snowyfoams/dog6/doc/walk/README.md

# Walking from the fold stand: one reference, the joint layer kept, the QP

*MuJoCo study, 2026-10-04, branch `cloud`.  The repo's own `StandSequence` /
`BalanceLaw` / `TrotGait` / `SafetyGate` run through
`doc/crouch_trot/hwsim.py` (CAN round robin, encoder quantisation, the 40 Hz
qd filter, IMU latency, the gate's 120 N·m/s slew and 9 N·m clip), with
`hw.trot_esti`'s Kalman filter fed **one sweep late** as `hw.stand` does.
The operator "holds keys": the command comes from a schedule.  Everything
here is simulation on the CAD model with DOG5's rotor inertia; **nothing has
flown**.  Section 10 says how to reproduce every table.*

**TL;DR.**  `hw.fold_walk` walks `hw.fold_trot` from the keyboard (W/S x, A/D
y, Q/E yaw) with the joint layer **kept**: its stance targets are anchored in
the world at each touchdown and seen from the *reference* trunk, so along
the reference they ask for exactly zero torque and they pull only on the
error the x/y rows pull on (section 2: the proof, and `selftest` §14).  The
force allocation is a QP with the friction pyramid inside the problem
(section 5), checked against SLSQP and certified by KKT.  **MuJoCo says it is
feasible inside a modest envelope**: across six gait phases a case the
shipped walk stays under 10° of tilt — in place, forward and back
0.05–0.10 m/s, sideways ±0.05 and 0.08 m/s, turns of ±20 and 40 °/s, 0.10 m/s
with a 20 °/s turn — and **0.15 m/s forward is not** (3 of 6 tipped, 2 to the
tilt stop).  Getting there took three findings worth more than any gain:
(1) the swing leg is **torque-rate bound** — in z the foot is 5.8 kg through
the reflected rotor, so the 20 mm arc's own feedforward asks the knee for
~1 000 N·m/s at the trot's 120 ms of swing and ~300 at 180 ms, against the
gate's 120: hence duty 0.70 and a swing law stiff in x/y, soft in z;
(2) DOG5's **settle** (a 0.2 s freeze of the gait clock every 2 cycles) must
be **off** while walking; (3) the **armature is the swing law's gain** — with
DOG6's lighter rotor (the bench's 1/1.7) and DOG5's M0 the walk fell 1 time
in 3 at 0.10 m/s, and with M0 fitted it never did.  The estimator under-reads
distance by ~10 %, so the robot walks ~10 % faster than asked.  The keys'
box ships at 0.10 / 0.05 m/s and 20 °/s.

**Follow-up, the same day, on request.**  The QP is now every entry point's
default allocator — stand, rise, hold, trot, walk (section 5.1): in place
it is the least squares to 0.05° of tilt, pushed it delivers more of the
wrench, and its worst case is capped at ~1.5 ms.  And `hw.fold2_walk` walks
the knees-out FOLD2 with the same walk (section 7).  Its CoM is on both trot
diagonals, and it is the better walker: six phases a case, in place to
0.15 m/s forward, 0.10 sideways, 40 °/s and 0.10 m/s with a 20 °/s turn all
under 8° of tilt, none tipped — 0.20 m/s forward is its edge (4 of 6 to
the stop) — and none of the hardware unknowns tipped it, the unfitted
lighter rotor included.

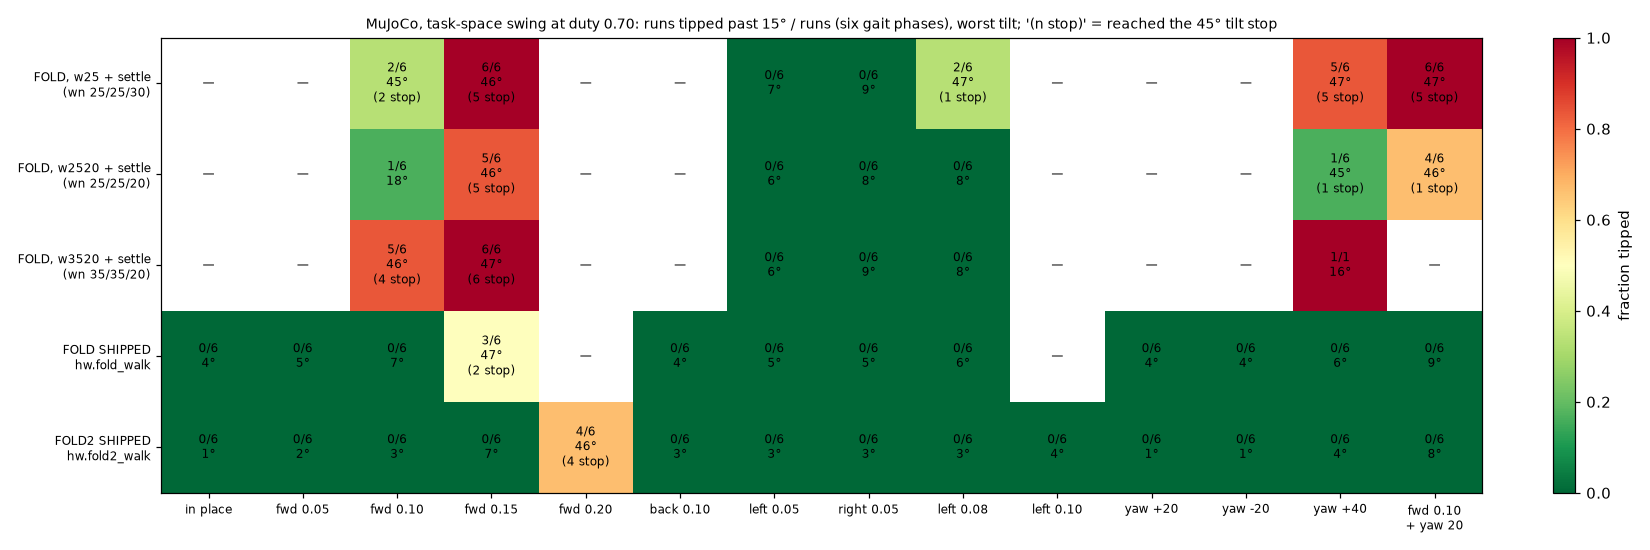
[picture p5: doc/walk/fig/fig_envelope.png]
envelope


**After the robot, 2026-10-05 (section 11).**  The trot that fails "after a
while" and the walk's trot in place that is worse than the trot's are, in
MuJoCo, one hardware unknown: the CoM a few mm off the CAD's.  3 / 5 mm
takes `hw.fold_trot` in place from 2.2° to 10° with the tilt rms growing
every 10 s and fells every walk within seconds; the rotor, friction,
latency, floor and torque constant cost under a degree each.  Shifting the
law's pin alone does not cure it; re-centring the stance on the measured
CoM does (`hw.com_check`, `hw.stand --com-offset`).  Until it is measured,
the walk's impedance on the trot's clock (`--swing-law impedance --duty
0.8 --contact-ramp 0.15 --settle 0.2`) is the configuration that stood
every 30 s run.  The harness also measured with the wrong SRB pin for the
fold until then; section 11.5 has the standard set re-run.

## 1. What was built

```
keys ──► WalkKeys.command (body axes) ──► WalkReference ──► RefSample (p, v, a, ψ, r) ──┬─► x/y rows (p_ref, v_ref, a_ref)
 W/S x  A/D y  Q/E yaw  SPACE stop       slew · clip · integrate · leash                ├─► heading (R_des = Rz(ψ_ref)…, ω_des = r ẑ)
                                                                                         ├─► joint layer (world-anchored targets)
                                                                                         └─► footholds + swing arc ─► swing law
                         SRB wrench ──► QP allocation (pyramid + box inside) ──► −Jᵀ Rᵀ f + gravity
```

| file | what it is |
|---|---|
| `hw/balance/trajectory.py` | the reference: `sim.cmpc.trajectory`'s generator **imported** (body command rotated by the *reference* yaw, integrated), the command slewed at `WALK_ACC_MAX`, clipped to the hardware box, **leashed** to the filter's CoM (MIT's `max_pos_error`) and the yaw to the IMU's heading on the circle |
| `hw/balance/keys.py` | `sim.cmpc.run`'s mapping key for key: W/S ±x, A/D ±y, Q/E ±yaw, SPACE stop; accumulates, clips |
| `hw/balance/qp.py` | stage 4 as a QP: `min ½|Af − b|²_S + ½α fᵀWf` s.t. the pyramid and the contact-weighted fz box; dense primal active set |
| `hw/balance/footstep.py` | the swing leg's **trajectory**: eq (33) + Raibert's term for the foothold, the x/y arc a quintic in the **world** (ground speed at both ends), z the in-place bump in the trunk |
| `hw/balance/swing_control.py` | the swing leg's **control**: task-space computed torque (`osc`, the default) or the Cartesian impedance |
| `hw/balance/walk.py` | ties them to one reference; the joint layer's world-anchored targets |
| `hw/fold_walk.py` | the entry point: `hw.fold_trot` + the hook + the QP + the walk's clock (`walking()`, which wraps any trot entry point) |
| `hw/fold2_walk.py` | the same walk over `hw.fold2_trot`, knees out (section 7) |
| `doc/walk/walksim.py` | this study |

`law.BalanceLaw` gains `alloc` and `walk`.  `walk` defaults to None, and
then nothing of the walk reaches any other entry point.  `alloc` defaults to
`"qp"` since the follow-up of the same day, on request: every entry point
now allocates with the QP (section 5.1), `--alloc wls` the least squares.
`selftest` passes the checks it passed before (the same two fail, section
10) and its section 14's new ones.

## 2. One reference — and why the joint layer survives walking

The worry (2026-10-04, before any of this was written): a joint target
latched at HOLD is a stance; the SRB law moving the trunk to correct x/y
deforms that stance; the two fight.  They do — *if their targets differ*.
The cure is not to drop the layer but to give it the same target as
everything else.

Each planted foot *i* has a **world anchor** `a_i` (x/y), latched at its
touchdown from the filter: `a_i = p̂ + R x_i^b`.  With the reference trunk
origin `p_o(t) = p_ref − Rz(ψ_ref) c_xy` (the CoM reference less the CoM
offset) the joint layer's target is the foot *as the reference trunk sees
it*:

```
x_t,i  = Rz(ψ_ref)ᵀ (a_i − p_o)          z: the commanded stance depth
ẋ_t,i  = −Rz(ψ_ref)ᵀ ṗ_o − r ẑ × x_t,i     (the anchor is fixed in the world)
q_t,i  = IK(x_t,i),   q̇_t,i = J_i⁻¹ ẋ_t,i
τ_i    = Kp (q_t,i − q_i) + Kd (q̇_t,i − q̇_i)       planted legs only
```

**Claim 1 — along the reference the layer is silent.**  If the trunk is
exactly on the reference — origin at `p_o`, heading `ψ_ref`, at their rates,
level and at the commanded height — and the foot has not slipped, the foot's
trunk-frame position *is* `x_t,i` and its rate *is* `ẋ_t,i`, so `q = q_t`,
`q̇ = q̇_t` and `τ = 0`.  (Roll, pitch and height errors still meet the
spring, as they always did: those are the attitude and height loops'
errors too.)  The layer therefore acts
only on the trunk's deviation from the reference — the same deviation the
x/y rows act on, measured the same way — so the two can no longer disagree
about where the trunk should be.  This is the conflict of the "joint hold
vs. SRB correction" question, removed by construction rather than by
softening either loop.  (`selftest` §14 builds a trunk 12 mm and 5° off the
engaging pose, moving at 0.1 m/s and 0.2 rad/s, sets its joints from an
independent finite difference of the reference's motion, and finds the
spring and the damper both zero to 1e-9 rad and 1e-10 rad/s.)

**Claim 2 — engaging is bumpless.**  At the first trot sweep every foot is
still on its HOLD site.  The anchors are set *virtually* to
`p_eq + Rz(ψ₀) s_i` with `s_i = FK(q_hold)` and `p_eq` the least-squares
origin that puts the four feet on their sites; the reference is reset on
the same `p_eq`.  So on that sweep `q_t ≡ q_hold` (to 9e-16 rad in
`selftest`) and the x/y error is zero — no step in the joint torque, none in
the wrench.

Two bounds keep an estimate gone wrong from pulling hard: the reference is
leashed within 30 mm of the filter's CoM, and per leg the x/y part of
`x_t − x` is clamped to 20 mm (`HOLD_XY_ERR_MAX`; at Kp 5 that is a few N).

The heading takes the same sample: `R_des = Rz(ψ_ref)·R(roll_sp, pitch_sp)`,
`ω_des = r ẑ`; the x/y rows get `p_ref`, `v_ref` and `a_ref` fed forward
(only while they are closed on a usable estimate).

## 3. Footholds and the swing arc

The foothold is cMPC's eq (33) with Raibert's feedback term, in the run's
world at the predicted touchdown (`t_rem` = swing time left):

```
p_land = p̂ + v_ref t_rem + Rz(ψ̂ + r t_rem + ½ r T_st) s_i + ½ T_st v̂ + k_v (v̂ − v_ref)
```

clamped to ±(60, 40) mm of the site in the heading frame.  `s_i` is the
**stance's own** neutral foot (the hold's), not the hip: the stance the SRB
model is pinned at.  `½ r T_st` is MIT's `pYawCorrected`.  `k_v` = 0.03 s
(MIT's); 0.06 and 0.10 were worse (section 6.2).

The arc is split on purpose: **x/y is a quintic between two world points**
(liftoff latched where the foot *is*, landing re-aimed every sweep), so the
foot leaves and meets the floor at ground speed — a trunk-frame arc would
slide every landing at the walking speed.  **z stays the in-place bump** on
the commanded depth, in the trunk, where the height loop and the joint
layer live.  World → trunk is by the heading, with the transport terms
(`v_b = Rzᵀ(v_w − v) − r ẑ × p_b`, `a_b = Rzᵀ(a_w − a) − 2r ẑ × v_b + r² p_b`);
`selftest` checks both against finite differences, walking and turning, and
the scalar arcs against `sim.cmpc.swing.SwingTrajectory` to 9e-15.

## 4. The swing law, and the number that decides it

```
osc:        τ = M0 J⁻¹ (a_ref + ωn² e + 2ζωn ė − J̇ q̇)        (cMPC's law, constant M0)
impedance:  τ = Jᵀ (Kp e + Kd ė)  [+ M0 J⁻¹ (a_ref − J̇ q̇_ref)  with --swing-ff]
```

The task-space law gives every axis its own bandwidth whatever the foot's
apparent mass, and that mass is the whole story.  At the fold stance,
`Λ = (J M0⁻¹ Jᵀ)⁻¹` has a diagonal of **0.31, 0.36, 5.8 kg** (x, y, z): the
reflected rotor, 0.0085 kg·m² a joint, seen through a short z lever.  The
20 mm z bump is two quintic halves of `T_h = T_sw/2`; its peak jerk is
`60 H / T_h³`, so its *feedforward alone* asks of the knee

| swing | z peak jerk | knee torque rate (feedforward only) | gate |
|---|---|---|---|
| 120 ms (duty 0.80) | 5 560 m/s³ | ~1 020 N·m/s | 120 |
| 180 ms (duty 0.70) | 1 650 m/s³ | **~300 N·m/s** | 120 |
| 245 ms | 650 m/s³ | ~120 N·m/s | 120 |

(`M0 J⁻¹ ẑ` is 0.18 N·m per m/s² at the knee.)  Past the gate's slew the
torque the motor gets is a triangle of the one asked for, the foot lags,
the feedback winds up behind the limiter, and the foot overshoots:

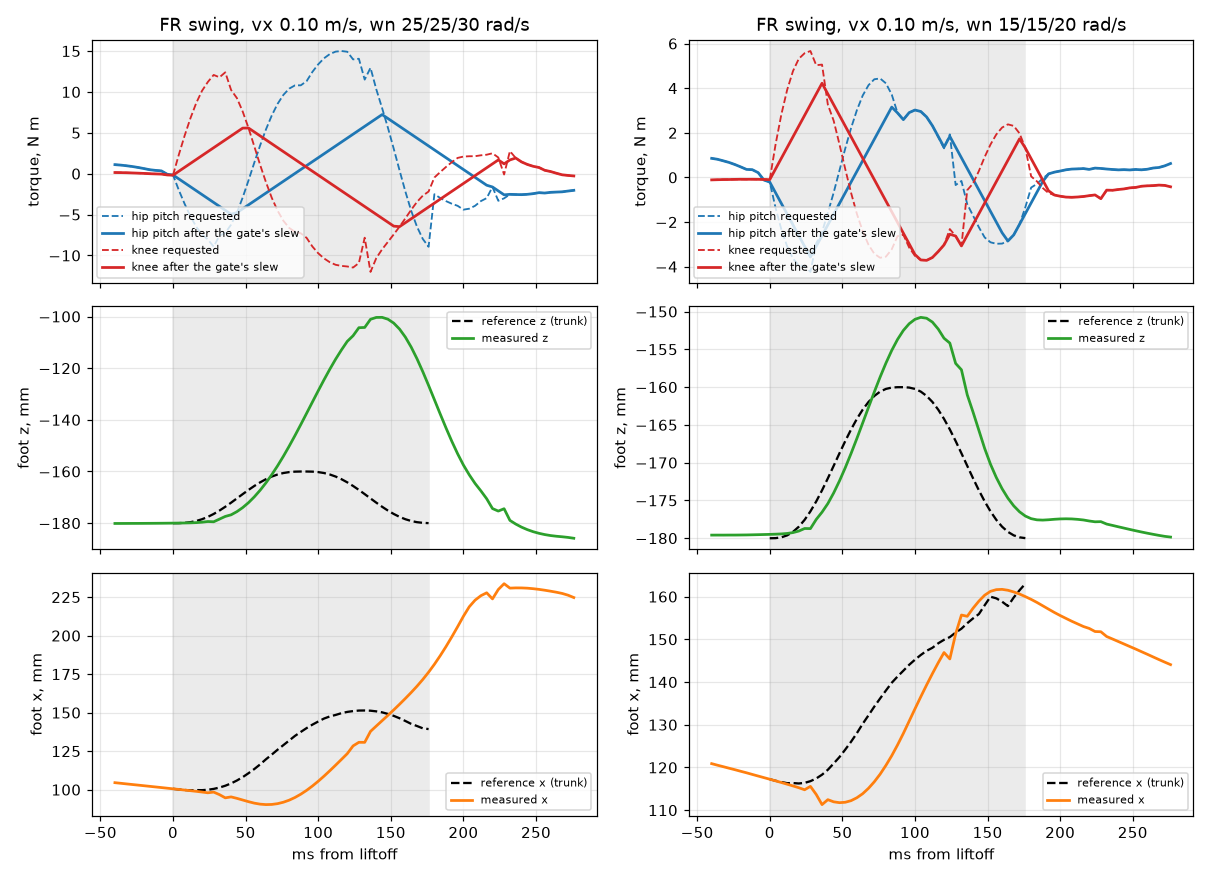
[picture p6: doc/walk/fig/fig_swing_slew.png]
swing slew


*FR, 0.10 m/s forward.  Left, ωn 25/25/30: the law asks 12–15 N·m, the gate
passes 120 N·m/s ramps, and the foot rises 80 mm for a 20 mm apex and lands
60 mm long.  Right, ωn 15/15/20: the request peaks near 5.5 N·m and the foot
follows within ~10 mm.*

So the lower bound on the swing time at the gate's slew is
`T_sw ≥ 2 (60 H κ / Ṫ_max)^(1/3)` = 245 ms at H = 20 mm (κ = 0.18 N·m s²/m).
The upper bound comes from the other side of the trot: each diagonal stands
alone for `T_sw`, and about its own support line it can make **no moment at
all** (forces at points on a line have zero moment about that line); the
trunk is an inverted pendulum there with `τ = √(h/g) ≈ 0.13 s`.  Lengthening
the swing to fit the slew lengthens the time the trunk falls about the
diagonal.  Duty 0.70 at 0.6 s (180 ms) and a low z bandwidth is where the
two meet in these runs; `--period 0.8` (240 ms) helped at 0.15 m/s once
(`h_fwd15_p08`) and nowhere reliably.

**The armature is the osc law's gain.**  M0 carries DOG5's rotor; the
bench's swing-ff run (2026-09-25) read DOG6's as ~1/1.7 of it.  Section 6.6
flies that plant.  Fit it (`hw.swing_bench --analyse`) and pass
`--ff-armature`.  The impedance (`--swing-law impedance`) does not read M0
without `--swing-ff`, but it is no way round this: in the shipped walk it
fell at 0.10 m/s (section 6.5).

## 5. The QP

```
min_f  ½ |A f − b_d|²_S + ½ α fᵀ W f          S = I, α = 1e-4, W = (10, 10, 1) / w_i
s.t.   |fx_i|, |fy_i| ≤ μ fz_i                 the pyramid, μ = 0.5
       w_i fz_min ≤ fz_i ≤ w_i fz_max          the contact ramp's box
       f_i ≡ 0 for w_i < 1e-3                  (not a variable)
```

`allocation.allocate` solves `A f = b` by weighted least squares and *then*
clips into the cone and rescales; the QP puts the cone and box in the
problem, so the delivered wrench is the closest the cone can make.  With
every face slack the two are the same allocation to α's regularisation
(0.01 N of 57.7 in `selftest`); on a 27 N push the least squares' clip
leaves a 11.7 N residual and the QP 0.12.

The solver is a dense **primal active set** (Nocedal & Wright, Alg. 16.3):
OSQP is not on the Pi and an ADMM's iteration count is the wrong shape for a
slot.  Most sweeps touch no face, and then the unconstrained optimum — one
12×12 solve — *is* the answer (checked first; ~65 µs against the least
squares' ~100 on this machine).  Otherwise it starts from that optimum
**projected into the cone** with the clipped rows as the working set (a
warm start from the last sweep was measured worse: 9.8 iterations mean / 38
max on the hardest sweeps of a walk, against 3.2 / 13).  Every iterate is
feasible, so the cap (30) can only cost optimality.  Degeneracy is handled
structurally: a foot's opposite faces can never both be active above the fz
floor, so the working set keeps one row of each pair; feet below the 1e-3
weight leave the problem (their collapsing box was what cycled).

Verification: on 77 captured hard sweeps and 3 000 random wrenches / stances
/ ramps, the forces agree with SLSQP to 1e-4 N, never violate a constraint,
never hit the cap (worst 26 iterations); `selftest` §14 certifies 400 more
by KKT (stationarity 8e-11, every multiplier ≥ 0).

### 5.1 The default, on every entry point (2026-10-04)

`law.BalanceLaw.alloc` and `hw.stand --alloc` default to the QP for every
entry point and every phase the SRB law drives — the stands, the rise, the
hold, the trot, the walk; `--alloc wls` keeps the least squares, and the
banner says which (`allocator QP -- the pyramid and the contact box inside
the problem`).  To be precise about what changes: the least squares'
forces are inside the cone too — it clips each foot into it and rescales —
but it meets the wrench *first*, so where the cone binds the wrench it
delivers is whatever the clip left; the QP delivers the closest wrench the
cone allows.  Where nothing binds the two are the same allocation.

The trot entry points in place, as flown (least squares) and as they now
ship (QP), 8 s each, and pushed sideways 3 s into the trot (`--allocs`):

| entry point | case | allocator | stood | max tilt | peak τ | slip | QP worst iterations |
|---|---|---|---|---|---|---|---|
| `hw.fold_trot` | in place, 8 s | least squares | yes | 2.24° | 1.34 N·m | 9.4 mm/s | — |
| `hw.fold_trot` | in place, 8 s | QP | yes | 2.27° | 1.34 N·m | 9.6 mm/s | 5 |
| `hw.fold_trot` | pushed 5 N × 0.2 s sideways | least squares | yes | 6.87° | 1.45 N·m | 10.7 mm/s | — |
| `hw.fold_trot` | pushed 5 N × 0.2 s sideways | QP | yes | 6.88° | 1.66 N·m | 10.7 mm/s | 5 |
| `hw.fold_trot` | pushed 10 N × 0.2 s sideways | least squares | yes | 11.86° | 2.43 N·m | 12.4 mm/s | — |
| `hw.fold_trot` | pushed 10 N × 0.2 s sideways | QP | yes | 11.84° | 2.80 N·m | 12.3 mm/s | 7 |
| `hw.fold_trot` | 0.1 N·m joint friction, IMU 15 ms | least squares | yes | 1.56° | 1.36 N·m | 7.9 mm/s | — |
| `hw.fold_trot` | 0.1 N·m joint friction, IMU 15 ms | QP | yes | 1.60° | 1.35 N·m | 7.9 mm/s | 5 |
| `hw.fold_trot` | floor μ 0.5 | least squares | yes | 2.29° | 1.35 N·m | 9.7 mm/s | — |
| `hw.fold_trot` | floor μ 0.5 | QP | yes | 2.33° | 1.35 N·m | 9.7 mm/s | 5 |
| `hw.fold2_trot` | in place, 8 s | least squares | yes | 0.50° | 1.25 N·m | 5.5 mm/s | — |
| `hw.fold2_trot` | in place, 8 s | QP | yes | 0.47° | 1.25 N·m | 5.5 mm/s | 4 |
| `hw.fold2_trot` | pushed 5 N × 0.2 s sideways | least squares | yes | 5.53° | 1.25 N·m | 6.8 mm/s | — |
| `hw.fold2_trot` | pushed 5 N × 0.2 s sideways | QP | yes | 5.56° | 1.41 N·m | 6.8 mm/s | 4 |
| `hw.fold2_trot` | pushed 10 N × 0.2 s sideways | least squares | yes | 9.72° | 2.15 N·m | 8.7 mm/s | — |
| `hw.fold2_trot` | pushed 10 N × 0.2 s sideways | QP | yes | 9.77° | 2.60 N·m | 8.5 mm/s | 5 |
| `hw.fold2_trot` | 0.1 N·m joint friction, IMU 15 ms | least squares | yes | 0.61° | 1.26 N·m | 4.2 mm/s | — |
| `hw.fold2_trot` | 0.1 N·m joint friction, IMU 15 ms | QP | yes | 0.62° | 1.26 N·m | 4.1 mm/s | 4 |
| `hw.fold2_trot` | floor μ 0.5 | least squares | yes | 0.54° | 1.24 N·m | 5.3 mm/s | — |
| `hw.fold2_trot` | floor μ 0.5 | QP | yes | 0.52° | 1.24 N·m | 5.3 mm/s | 3 |

Indistinguishable in place, under friction and latency and on a slippery
floor (tilt within 0.05°).  Under a push the QP's torque peak is 0.2–0.45
N·m higher at the same tilt: it meets more of the wrench the push calls for,
with bigger forces on the cone's faces — DOG5's caution in `allocation.py`
(a QP's p95 torque 2.73 against 1.61 N·m in its trot stance), here small
because S = I gives up the unreachable moment the way the least squares did.

**Cost.**  On the development VM the QP is ~110 µs + ~70 µs per active-set
iteration; its fast path (no face touched — every stand sweep, most trot
sweeps) is 80 µs against the least squares' 120.  The iterations are
numpy's call overhead, not the solve: a Schur-complement step (one m×m
solve, H inverted once) produced the same iterates to 1e-9 N and saved
nothing.  `config.QP_MAX_ITER` is now 20 (was 30), so the worst case is
~1.5 ms: no walk of the shipped configuration that stood needed more than
20 in a sweep (most 4–7; the trots in place above, 3–7), every iterate is
inside the cone, and none is worse than the one before — `selftest` checks
a solve stopped at its cap for both.

## 6. What MuJoCo says

Columns: *tipped* is any tilt past 15° (the harness's "fell"); *tilt stop*
is the fold stand's own 45° e-stop, i.e. on the floor.  *True* velocity is
the trunk's, from MuJoCo, over the steady second half of the 5 s command.

### 6.1 The first design: the walking impedance at the trot's clock

`--v0`: the walking impedance (`KP_SWING_WALK` 150/150/400) at the trot's own
duty 0.80 (120 ms of swing), the trot's settle, everything else as shipped.
`inplace_flown` is `hw.fold_trot` with nothing of the walk attached.

| scenario | command (vx, vy, r) | stood | true (vx, vy, r) | max tilt | peak τ | slip |
|---|---|---|---|---|---|---|
| `inplace_flown` | in place | yes | — | 2.2° | 1.34 N·m | 9.4 mm/s |
| `v0_inplace` | in place | yes | — | 2.5° | 1.26 N·m | 8.5 mm/s |
| `v0_fwd05` | +0.05, +0.00, +0°/s | yes | +0.040, -0.002, +0.6 | 6.2° | 6.51 N·m | 42.5 mm/s |
| `v0_fwd10` | +0.10, +0.00, +0°/s | yes | +0.063, -0.004, +0.6 | 13.6° | 8.36 N·m | 80.4 mm/s |
| `v0_back10` | -0.10, +0.00, +0°/s | yes | -0.106, -0.002, -0.4 | 4.0° | 2.65 N·m | 29.8 mm/s |
| `v0_lat05` | +0.00, +0.05, +0°/s | **fell** | — | 46.3° | 5.65 N·m | 23.4 mm/s |
| `v0_yaw20` | +0.00, +0.00, +20°/s | yes | +0.001, +0.009, +19.8 | 5.0° | 2.90 N·m | 27.2 mm/s |
| `v0_fwd10_ff` | — | **fell** | — | 46.2° | 9.00 N·m | 88.0 mm/s |
| `v0_fwd10_osc` | +0.10, +0.00, +0°/s | **fell** | — | 45.4° | 9.00 N·m | 73.1 mm/s |
| `v0_fwd10_d70` | +0.10, +0.00, +0°/s | yes | +0.082, -0.009, +1.8 | 9.8° | 8.03 N·m | 83.2 mm/s |

The walk attached at zero command is the trot in place it replaced (2.5°
against 2.2°).  Moving, it is not a walk: 0.10 m/s forward makes 0.063 at
13.6°, sideways falls, and neither the feedforward (`_ff`) nor the
task-space law at the same clock (`_osc`) rescues it; a longer swing alone
(`_d70`, duty 0.70) does better.  Section 4 is why.

### 6.2 Why: the swing is torque-rate bound

Section 4.  The one-knob sweep at 0.10 / 0.15 m/s on the osc law at duty
0.70 (`--sens`, ωn 25/25/30 otherwise):

| knob | 0.10 m/s | 0.15 m/s |
|---|---|---|
| none (`g_fwd10` / `g_fwd15`) | tilt 12.2°, τ 9.0 (the clip) | fell |
| gate slew 240 / 360 N·m/s | 8.5° / 10.0° | fell / fell |
| ωn 15/15/20 | **6.6°, τ 5.2** | fell |
| k_v 0.06 / 0.10 s | 11.6° / fell | fell / fell |
| apex 30 mm | fell | fell |

### 6.3 The swing's gains, by axis, across the gait phase

One run is one gait phase at the command, and the outcome flips with it.
Each case six times, the command 0, 100, … 500 ms into the 0.6 s clock
(`--qrepeats`; the trot's settle still on here).  z is the expensive axis
(5.8 kg), x/y nearly free (0.3 kg):

| config | case | runs | tipped >15° | tilt stop (45°) | max tilt (median) | true (vx, vy, r) of those that stood | peak τ |
|---|---|---|---|---|---|---|---|
| w25 | combo | 6 | 6 | 5 | 46.8° (45.6°) | — | 9.0 |
| w25 | fwd10 | 6 | 2 | 2 | 45.2° (11.6°) | +0.104, -0.001, +0.1 | 9.0 |
| w25 | fwd15 | 6 | 6 | 5 | 45.7° (45.4°) | — | 9.0 |
| w25 | lat05 | 6 | 0 | 0 | 7.4° (6.4°) | +0.010, +0.063, -0.1 | 5.7 |
| w25 | lat08 | 6 | 2 | 1 | 46.8° (11.9°) | +0.004, +0.111, -0.5 | 7.1 |
| w25 | latm05 | 6 | 0 | 0 | 8.8° (8.5°) | +0.007, -0.065, -0.2 | 5.8 |
| w25 | yaw40 | 6 | 5 | 5 | 46.9° (45.2°) | -0.011, +0.009, +38.5 | 8.6 |
| w2520 | combo | 6 | 4 | 1 | 45.7° (17.1°) | +0.116, +0.015, +19.9 | 8.7 |
| w2520 | fwd10 | 6 | 1 | 0 | 17.9° (11.9°) | +0.107, -0.001, -0.3 | 8.6 |
| w2520 | fwd15 | 6 | 5 | 5 | 46.3° (45.7°) | +0.174, -0.020, +0.0 | 9.0 |
| w2520 | lat05 | 6 | 0 | 0 | 6.2° (5.8°) | +0.003, +0.059, -0.1 | 4.2 |
| w2520 | lat08 | 6 | 0 | 0 | 8.2° (8.1°) | +0.004, +0.094, -0.0 | 4.6 |
| w2520 | latm05 | 6 | 0 | 0 | 8.0° (7.9°) | +0.003, -0.062, +0.1 | 4.3 |
| w2520 | yaw40 | 6 | 1 | 1 | 44.7° (7.2°) | +0.000, +0.011, +39.7 | 6.1 |
| w3520 | fwd10 | 6 | 5 | 4 | 46.3° (45.2°) | +0.109, +0.011, +0.0 | 9.0 |
| w3520 | fwd15 | 6 | 6 | 6 | 47.4° (45.6°) | — | 9.0 |
| w3520 | lat05 | 6 | 0 | 0 | 6.4° (5.9°) | +0.002, +0.055, +0.1 | 4.6 |
| w3520 | lat08 | 6 | 0 | 0 | 8.3° (7.0°) | +0.003, +0.088, +0.1 | 4.9 |
| w3520 | latm05 | 6 | 0 | 0 | 9.5° (9.2°) | +0.005, -0.061, +0.3 | 4.6 |
| w3520 | yaw40 | 1 | 1 | 0 | 15.7° (15.7°) | — | 6.9 |

25/25/20 against 25/25/30: the 40 °/s turn 1 tipped of 6 against 5,
0.08 m/s sideways 0 against 2, 0.10 forward 1 (to 17.9°, no stop) against 2
to the stop.  Stiffer x/y (35, `w3520`, stopped after 31 runs) broke the
forward walk.  15/15/20 (`--grid2`, `--repeats`) fixed forward but dropped
the lateral steps: 3 of 3 fell at 0.05 m/s, the leading front foot on the
ground in 20 % of its mid-swing samples.

### 6.4 The settle

`gait.TrotGait`'s settle freezes the clock 0.2 s every 2 cycles with the
four feet down, DOG5's re-level for the trot in place.  The reference does
not freeze: at 0.1 m/s the trunk moves 20 mm over planted feet, the stance
outlasts the `T_st` the footholds were planned for, and the next swing
starts 20 mm behind.  The same six phases, settle on (`w2520`) and off
(`w2520n`):

| config | case | runs | tipped >15° | tilt stop (45°) | max tilt (median) | true (vx, vy, r) of those that stood | peak τ |
|---|---|---|---|---|---|---|---|
| w2520 | combo | 6 | 4 | 1 | 45.7° (17.1°) | +0.116, +0.015, +19.9 | 8.7 |
| w2520 | fwd10 | 6 | 1 | 0 | 17.9° (11.9°) | +0.107, -0.001, -0.3 | 8.6 |
| w2520 | fwd15 | 6 | 5 | 5 | 46.3° (45.7°) | +0.174, -0.020, +0.0 | 9.0 |
| w2520 | lat08 | 6 | 0 | 0 | 8.2° (8.1°) | +0.004, +0.094, -0.0 | 4.6 |
| w2520 | yaw40 | 6 | 1 | 1 | 44.7° (7.2°) | +0.000, +0.011, +39.7 | 6.1 |
| w2520n | combo | 6 | 0 | 0 | 9.5° (7.2°) | +0.108, +0.004, +19.9 | 6.2 |
| w2520n | fwd10 | 6 | 0 | 0 | 6.6° (5.0°) | +0.112, -0.000, +0.0 | 5.8 |
| w2520n | fwd15 | 6 | 3 | 2 | 46.9° (14.2°) | +0.157, -0.003, +0.3 | 9.0 |
| w2520n | lat08 | 6 | 0 | 0 | 5.9° (4.9°) | +0.003, +0.089, +0.0 | 3.8 |
| w2520n | yaw40 | 6 | 0 | 0 | 5.8° (5.4°) | +0.001, +0.008, +40.1 | 5.1 |

`WALK_SETTLE_S` = 0.  (The in-place trot of `hw.fold_trot` keeps it.)

### 6.5 The walk as shipped

ωn 25/25/20, ζ 0.7, duty 0.70 (180 ms of swing), settle off, QP
(`config.WN_SWING_OSC`, `WALK_DUTY`, `WALK_SETTLE_S`; `walksim.py`'s bare
names).  Six phases a case (`q_w2520n_*` and `x_ship_*`; the bare-name single
runs reproduce their phase-0 rows to the last digit):

| case | runs | tipped >15° | tilt stop | max tilt (median) | true (vx, vy, r), stood | peak τ | slip |
|---|---|---|---|---|---|---|---|
| in place | 6 | 0 | 0 | 3.7° (3.7°) | — | 3.7 N·m | 15 mm/s |
| forward 0.05 | 6 | 0 | 0 | 5.2° (5.2°) | +0.061, −0.001, −0.1 | 4.3 N·m | 21 mm/s |
| forward 0.10 | 6 | 0 | 0 | 6.6° (5.0°) | +0.112, −0.000, +0.0 | 5.8 N·m | 28 mm/s |
| **forward 0.15** | 6 | **3** | **2** | 46.9° (14.2°) | +0.157, −0.003, +0.3 | 9.0 N·m | 37 mm/s |
| back 0.10 | 6 | 0 | 0 | 4.0° (3.8°) | −0.108, +0.001, +0.0 | 3.8 N·m | 24 mm/s |
| left 0.05 | 6 | 0 | 0 | 5.4° (4.4°) | +0.004, +0.056, +0.0 | 3.8 N·m | 18 mm/s |
| right 0.05 | 6 | 0 | 0 | 4.7° (4.3°) | +0.004, −0.055, −0.0 | 3.8 N·m | 18 mm/s |
| left 0.08 | 6 | 0 | 0 | 5.9° (4.9°) | +0.003, +0.089, +0.0 | 3.8 N·m | 22 mm/s |
| turn +20 °/s | 6 | 0 | 0 | 4.2° (4.2°) | +0.004, +0.004, +20.0 | 3.8 N·m | 19 mm/s |
| turn −20 °/s | 6 | 0 | 0 | 4.3° (4.2°) | +0.005, −0.003, −20.1 | 3.8 N·m | 19 mm/s |
| turn +40 °/s | 6 | 0 | 0 | 5.8° (5.4°) | +0.001, +0.008, +40.1 | 5.1 N·m | 28 mm/s |
| 0.10 fwd + 20 °/s | 6 | 0 | 0 | 9.5° (7.2°) | +0.108, +0.004, +19.9 | 6.2 N·m | 31 mm/s |

The standard set (`python doc/walk/walksim.py`, phase 0, one run each): every
run of the shipped walk stands, `fwd15` included at this phase (8.7°) —
which is the point of the repeats — and only the impedance variant falls:

| scenario | command (vx, vy, r) | stood | true (vx, vy, r) | max tilt | peak τ | slip |
|---|---|---|---|---|---|---|
| `inplace` | in place | yes | — | 3.7° | 3.67 N·m | 15.1 mm/s |
| `fwd05` | +0.05, +0.00, +0°/s | yes | +0.061, +0.001, -0.0 | 5.2° | 4.27 N·m | 20.9 mm/s |
| `fwd10` | +0.10, +0.00, +0°/s | yes | +0.114, +0.003, -0.1 | 4.5° | 5.55 N·m | 28.9 mm/s |
| `fwd15` | +0.15, +0.00, +0°/s | yes | +0.166, -0.001, -0.1 | 8.7° | 6.59 N·m | 36.1 mm/s |
| `back05` | -0.05, +0.00, +0°/s | yes | -0.052, +0.001, -0.0 | 3.7° | 3.64 N·m | 17.7 mm/s |
| `back10` | -0.10, +0.00, +0°/s | yes | -0.108, +0.002, +0.0 | 3.8° | 3.81 N·m | 24.7 mm/s |
| `lat05` | +0.00, +0.05, +0°/s | yes | +0.004, +0.056, +0.0 | 4.4° | 3.81 N·m | 18.5 mm/s |
| `latm05` | +0.00, -0.05, +0°/s | yes | +0.004, -0.054, -0.1 | 4.2° | 3.81 N·m | 17.9 mm/s |
| `lat08` | +0.00, +0.08, +0°/s | yes | +0.004, +0.090, +0.1 | 5.2° | 3.81 N·m | 22.6 mm/s |
| `yaw20` | +0.00, +0.00, +20°/s | yes | +0.004, +0.005, +19.8 | 4.2° | 3.68 N·m | 19.3 mm/s |
| `yawm20` | +0.00, +0.00, -20°/s | yes | +0.004, -0.003, -19.8 | 4.3° | 3.78 N·m | 19.2 mm/s |
| `yaw40` | +0.00, +0.00, +40°/s | yes | +0.002, +0.007, +39.9 | 5.6° | 5.05 N·m | 28.0 mm/s |
| `combo` | +0.10, +0.00, +20°/s | yes | +0.108, -0.000, +20.0 | 6.4° | 5.70 N·m | 31.4 mm/s |
| `diag` | +0.10, +0.05, +0°/s | yes | +0.105, +0.056, +0.0 | 5.8° | 5.59 N·m | 30.0 mm/s |
| `fwd10_wls` | +0.10, +0.00, +0°/s | yes | +0.110, +0.004, -0.2 | 4.6° | 5.57 N·m | 28.8 mm/s |
| `fwd10_fric` | +0.10, +0.00, +0°/s | yes | +0.112, -0.005, -0.0 | 7.4° | 5.39 N·m | 31.2 mm/s |
| `fwd10_mu05` | +0.10, +0.00, +0°/s | yes | +0.115, +0.004, +0.1 | 4.8° | 5.63 N·m | 29.7 mm/s |
| `fwd10_imp` | +0.10, +0.00, +0°/s | **fell** | — | 46.0° | 7.30 N·m | 59.1 mm/s |
| `inplace_arm06` | in place | yes | — | 4.7° | 3.51 N·m | 17.3 mm/s |
| `fwd10_arm06` | +0.10, +0.00, +0°/s | yes | +0.119, -0.003, -0.2 | 9.0° | 5.53 N·m | 37.0 mm/s |
| `fwd10_arm06fit` | +0.10, +0.00, +0°/s | yes | +0.121, -0.002, +0.1 | 6.3° | 3.83 N·m | 32.2 mm/s |
| `lat05_arm06` | +0.00, +0.05, +0°/s | yes | +0.002, +0.062, -0.0 | 6.5° | 3.73 N·m | 21.8 mm/s |
| `lat05_arm06fit` | +0.00, +0.05, +0°/s | yes | +0.002, +0.058, -0.1 | 5.3° | 2.82 N·m | 18.7 mm/s |

`fwd10_imp` is the shipped walk with the impedance swing in place of the
task-space law: it fell, so the impedance is not a fallback for walking.
`fwd10_wls` is the least squares in place of the QP: on a walk this far
inside the cone the two allocate the same forces (4.6° against 4.5°).

### 6.6 The hardware unknowns

The shipped walk with one thing the simulator does not know made worse, three
phases each (`--xrepeats`): `fric` 0.1 N·m of Coulomb friction on every joint
and the IMU 15 ms late; `mu05` the floor at μ 0.5; `arm06` the plant's rotor
at 0.6 of DOG5's — the bench's reading of DOG6's — with the law's M0 left at
DOG5's; `arm06fit` the same plant with M0 fitted (`--ff-armature`).

| config | case | runs | tipped >15° | tilt stop (45°) | max tilt (median) | true (vx, vy, r) of those that stood | peak τ |
|---|---|---|---|---|---|---|---|
| fric | fwd10 | 3 | 0 | 0 | 8.2° (7.4°) | +0.113, -0.005, +0.2 | 5.4 |
| fric | lat05 | 3 | 0 | 0 | 5.8° (5.7°) | +0.011, +0.057, +0.0 | 3.8 |
| fric | yaw20 | 3 | 0 | 0 | 5.1° (4.8°) | +0.009, +0.001, +20.1 | 3.8 |
| mu05 | fwd10 | 3 | 0 | 0 | 5.0° (4.9°) | +0.112, +0.001, -0.1 | 5.6 |
| mu05 | lat05 | 3 | 0 | 0 | 4.5° (4.4°) | +0.005, +0.057, +0.0 | 3.9 |
| mu05 | yaw20 | 3 | 0 | 0 | 4.4° (4.3°) | +0.005, +0.003, +20.0 | 3.8 |
| arm06 | fwd10 | 3 | 1 | 1 | 44.8° (9.0°) | +0.116, +0.002, -0.2 | 7.0 |
| arm06 | inplace | 3 | 0 | 0 | 4.7° (4.7°) | — | 3.5 |
| arm06 | lat05 | 3 | 0 | 0 | 6.5° (6.4°) | +0.001, +0.062, +0.0 | 3.8 |
| arm06 | yaw20 | 3 | 0 | 0 | 4.8° (4.2°) | +0.001, +0.002, +20.1 | 3.5 |
| arm06fit | fwd10 | 3 | 0 | 0 | 6.3° (6.3°) | +0.121, -0.004, +0.0 | 3.8 |
| arm06fit | inplace | 3 | 0 | 0 | 3.8° (3.8°) | — | 2.6 |
| arm06fit | lat05 | 3 | 0 | 0 | 5.7° (5.3°) | +0.002, +0.058, -0.0 | 2.8 |
| arm06fit | yaw20 | 3 | 0 | 0 | 4.1° (3.8°) | +0.004, +0.003, +20.1 | 2.8 |

Friction, latency and a slippery floor cost a few degrees.  The rotor is the
one that matters, and in the direction the bench points: the task-space law
multiplies by M0, so a rotor 0.6 the size makes it 1/0.6 too strong, and at
0.10 m/s that fell once in three; with M0 fitted it is the best walk in this
study (a lighter rotor is less torque rate to ask for: peak τ 2.6–3.8 N·m).

### 6.7 The estimator

`hw.trot_esti`'s filter, fed one sweep late, against MuJoCo's truth, shipped
walk at phase 0:

| run | trunk path | estimate − truth at the end | touchdown − plan, true world: mean / p95 |
|---|---|---|---|
| left 0.05 | 0.43 m | (−41, −29) mm | (−6, −3) mm / 22 mm |
| forward 0.10 | 0.69 m | (−71, 0) mm | (3, 0) mm / 63 mm |
| turn +40 °/s | 0.31 m | (−7, 0) mm | (−2, 1) mm / 32 mm |
| left 0.08 | 0.59 m | (−39, −47) mm | (−6, −5) mm / 24 mm |
| 0.10 + 20 °/s | 0.70 m | (−56, −43) mm | (−1, 5) mm / 54 mm |

The filter under-reads distance by 8–12 % (leg odometry over feet that slip
15–37 mm/s): the law regulates the *estimated* velocity to the command and
the true one comes out ~10 % high (0.112 for 0.10).  Footholds land where
they were planned to within a few mm on average — the planner and the
filter share one world, so the drift cancels out of the step — but the
robot's true position wanders off the estimate's by ~10 % of the distance
walked.  Nothing here closes that; the leash only keeps the reference
within 30 mm of the estimate.

### 6.8 Compute

`law.update` on this VM, one simulation at a time (the harness's own
`timing`, 8 s of trot each):

| | p50 | p95 |
|---|---|---|
| `hw.fold_trot` in place, nothing of the walk (`inplace_flown`) | 662 µs | 963 µs |
| the walk at zero command, impedance swing, least squares (`v0_inplace_wls`) | 915 µs | 1 193 µs |
| … with the QP (`v0_inplace`) | 875 µs | 1 283 µs |
| the shipped walk in place / 0.10 forward / 0.05 sideways | 908 / 948 / 943 µs | 1 222 / 1 228 / 1 297 µs |

The walk costs ~40 % on top of the trot in place: the joint layer's IK on
the planted legs, the footholds and arcs (scalar closed forms; the first
cut built two `SwingTrajectory` objects a leg a sweep and cost the law more
than the QP), the swing law's extra Jacobian.  The QP's fast path is
cheaper than the least squares; its active-set sweeps are not.  The
simulator charges a fixed 0.5 ms for the law, so **what this costs on the Pi
is not simulated**: `swing.py` records the trot's law at 729 µs p50 under
the robot's own Python, two legs swinging (891 with the swing feedforward),
against 662 here — so expect ~1 ms with the walk, and read the exit
report's `law timing` first.  The cheapest further cut is the
joint layer's IK: one Newton step from the measured q, `q + J⁻¹(x_t − x)`,
in place of the closed form.

## 7. FOLD2: `hw.fold2_walk`

`hw.fold2_trot`'s stand — `posture.FOLD2`, the front legs the rear legs
mirrored so every knee is outboard of its hip, the straight rise to the
160 mm hold — walked by `fold_walk.walking`: the same hook, keys and box,
the same swing law, clock and QP.  Nothing in the walk is posture-specific
beyond what it reads off the stance at the first trot sweep: the footholds
are placed about the sites latched from q_hold (FOLD2's feet at ±219.5 mm
in x, where the fold's stand has the front pair at +149.5), and the SRB pin
is FOLD2's own.  Two facts decide how it walks, both checked at the hold:

- **the swing leg is the same leg, mirrored**: Λ is 0.31 / 0.36 / 5.8 kg in
  x / y / z on every leg, as on the fold, and `M0 J⁻¹ ẑ` is the same
  0.18 N·m per m/s² at the knee — section 4's torque-rate budget holds to
  the digit, and the swing gains carry over unchanged;
- **FOLD2's CoM is on both trot diagonals** (0.0 mm off each line; the
  fold's stand has it 5.7 mm off both): the moment no diagonal pair can
  make about its own line — the line-contact argument of section 4 — is
  zero for this stance, so no two-foot phase starts with a moment the law
  cannot deliver.

### 7.1 The single runs

`python doc/walk/walksim.py --fold2`, phase 0, one run each:

| scenario | command (vx, vy, r) | stood | true (vx, vy, r) | max tilt | peak τ | slip |
|---|---|---|---|---|---|---|
| `f2_inplace` | in place | yes | — | 1.0° | 3.55 N·m | 7.6 mm/s |
| `f2_fwd05` | +0.05, +0.00, +0°/s | yes | +0.055, +0.001, -0.0 | 1.6° | 3.78 N·m | 12.5 mm/s |
| `f2_fwd10` | +0.10, +0.00, +0°/s | yes | +0.109, +0.002, +0.0 | 3.3° | 4.85 N·m | 21.5 mm/s |
| `f2_fwd15` | +0.15, +0.00, +0°/s | yes | +0.167, +0.002, -0.0 | 6.4° | 6.33 N·m | 38.5 mm/s |
| `f2_fwd20` | — | **fell** | — | 45.2° | 6.66 N·m | 39.2 mm/s |
| `f2_back10` | -0.10, +0.00, +0°/s | yes | -0.111, -0.000, +0.0 | 2.8° | 4.99 N·m | 22.9 mm/s |
| `f2_lat05` | +0.00, +0.05, +0°/s | yes | +0.000, +0.056, +0.0 | 2.0° | 3.65 N·m | 13.4 mm/s |
| `f2_latm05` | +0.00, -0.05, +0°/s | yes | -0.000, -0.056, -0.0 | 1.9° | 3.81 N·m | 12.8 mm/s |
| `f2_lat08` | +0.00, +0.08, +0°/s | yes | +0.000, +0.088, +0.0 | 2.6° | 3.78 N·m | 17.3 mm/s |
| `f2_lat10` | +0.00, +0.10, +0°/s | yes | -0.000, +0.110, +0.0 | 2.9° | 3.80 N·m | 19.7 mm/s |
| `f2_yaw20` | +0.00, +0.00, +20°/s | yes | +0.000, -0.000, +19.7 | 1.0° | 3.83 N·m | 14.9 mm/s |
| `f2_yawm20` | +0.00, +0.00, -20°/s | yes | -0.000, +0.000, -19.7 | 1.0° | 3.81 N·m | 15.0 mm/s |
| `f2_yaw40` | +0.00, +0.00, +40°/s | yes | +0.003, -0.001, +39.3 | 3.9° | 5.05 N·m | 26.1 mm/s |
| `f2_combo` | +0.10, +0.00, +20°/s | yes | +0.104, +0.002, +19.7 | 7.7° | 5.35 N·m | 26.3 mm/s |
| `f2_diag` | +0.10, +0.05, +0°/s | yes | +0.110, +0.055, +0.0 | 3.5° | 4.85 N·m | 24.6 mm/s |
| `f2_fwd10_wls` | +0.10, +0.00, +0°/s | yes | +0.109, +0.001, +0.0 | 3.3° | 4.87 N·m | 21.6 mm/s |
| `f2_fwd10_fric` | +0.10, +0.00, +0°/s | yes | +0.108, +0.002, +0.0 | 3.3° | 4.95 N·m | 19.9 mm/s |
| `f2_fwd10_mu05` | +0.10, +0.00, +0°/s | yes | +0.110, +0.001, +0.1 | 3.0° | 4.93 N·m | 22.7 mm/s |
| `f2_fwd10_arm06` | +0.10, +0.00, +0°/s | yes | +0.107, +0.003, -0.0 | 3.7° | 4.42 N·m | 25.6 mm/s |
| `f2_fwd10_arm06fit` | +0.10, +0.00, +0°/s | yes | +0.111, +0.000, -0.0 | 1.5° | 3.26 N·m | 19.4 mm/s |
| `f2_lat05_arm06` | +0.00, +0.05, +0°/s | yes | +0.000, +0.058, -0.0 | 3.1° | 3.57 N·m | 16.2 mm/s |
| `f2_lat05_arm06fit` | +0.00, +0.05, +0°/s | yes | +0.000, +0.054, -0.0 | 2.2° | 2.65 N·m | 13.6 mm/s |

Against the fold's single runs (section 6.5) every case is calmer — in
place 1.0° against 3.7°, 0.10 m/s forward 3.3° against 4.5°, sideways
0.08 m/s 2.6° against 5.2° — and 0.15 m/s forward, which tipped in 3 of 6
phases on the fold, stands at 6.4°; 0.10 m/s sideways, never flown on the
shipped fold, stands at 2.9°.  0.20 m/s forward falls.  The lighter rotor with DOG5's M0 (`_arm06`), which fell once in
three on the fold, stands here; fitted (`_arm06fit`) it is the calmest walk
of the study (1.5°).

### 7.2 Across the gait phase

Six phases a case, the command 0, 100, … 500 ms into the clock, the shipped
walk unchanged (`--f2repeats`):

| case | runs | tipped >15° | tilt stop | max tilt (median) | true (vx, vy, r), stood | peak τ | slip |
|---|---|---|---|---|---|---|---|
| in place | 6 | 0 | 0 | 1.0° (1.0°) | — | 3.5 N·m | 8 mm/s |
| forward 0.05 | 6 | 0 | 0 | 1.6° (1.5°) | +0.056, +0.000, +0.0 | 3.9 N·m | 12 mm/s |
| forward 0.10 | 6 | 0 | 0 | 3.3° (3.0°) | +0.110, +0.001, +0.0 | 5.0 N·m | 22 mm/s |
| forward 0.15 | 6 | 0 | 0 | 6.7° (5.9°) | +0.167, +0.002, +0.1 | 6.3 N·m | 36 mm/s |
| **forward 0.20** | 6 | **4** | **4** | 46.3° (45.1°) | +0.220, +0.014, +0.2 | 9.0 N·m | 45 mm/s |
| back 0.10 | 6 | 0 | 0 | 3.2° (2.9°) | −0.111, −0.000, +0.0 | 5.0 N·m | 22 mm/s |
| left 0.05 | 6 | 0 | 0 | 2.9° (2.1°) | +0.000, +0.056, +0.0 | 3.7 N·m | 13 mm/s |
| right 0.05 | 6 | 0 | 0 | 2.9° (2.2°) | +0.000, −0.056, +0.0 | 3.8 N·m | 13 mm/s |
| left 0.08 | 6 | 0 | 0 | 3.4° (3.1°) | +0.000, +0.089, +0.0 | 3.8 N·m | 17 mm/s |
| left 0.10 | 6 | 0 | 0 | 3.9° (3.6°) | +0.000, +0.110, +0.0 | 3.8 N·m | 19 mm/s |
| turn +20 °/s | 6 | 0 | 0 | 1.2° (1.0°) | +0.000, −0.000, +20.0 | 3.8 N·m | 15 mm/s |
| turn −20 °/s | 6 | 0 | 0 | 1.1° (1.0°) | +0.000, +0.001, −20.0 | 3.8 N·m | 15 mm/s |
| turn +40 °/s | 6 | 0 | 0 | 4.3° (3.7°) | +0.001, +0.000, +40.0 | 5.0 N·m | 26 mm/s |
| 0.10 fwd + 20 °/s | 6 | 0 | 0 | 7.7° (6.8°) | +0.106, +0.001, +20.0 | 6.0 N·m | 26 mm/s |

Beside the fold's shipped walk (section 6.5), the same cases and phases:

| case | FOLD tipped / runs, worst tilt | FOLD2 tipped / runs, worst tilt |
|---|---|---|
| in place | 0 / 6, 3.7° | 0 / 6, 1.0° |
| forward 0.05 | 0 / 6, 5.2° | 0 / 6, 1.6° |
| forward 0.10 | 0 / 6, 6.6° | 0 / 6, 3.3° |
| forward 0.15 | 3 / 6, 46.9° | 0 / 6, 6.7° |
| forward 0.20 | — | 4 / 6, 46.3° |
| back 0.10 | 0 / 6, 4.0° | 0 / 6, 3.2° |
| left 0.05 | 0 / 6, 5.4° | 0 / 6, 2.9° |
| right 0.05 | 0 / 6, 4.7° | 0 / 6, 2.9° |
| left 0.08 | 0 / 6, 5.9° | 0 / 6, 3.4° |
| left 0.10 | — | 0 / 6, 3.9° |
| turn +20 °/s | 0 / 6, 4.2° | 0 / 6, 1.2° |
| turn −20 °/s | 0 / 6, 4.3° | 0 / 6, 1.1° |
| turn +40 °/s | 0 / 6, 5.8° | 0 / 6, 4.3° |
| 0.10 fwd + 20 °/s | 0 / 6, 9.5° | 0 / 6, 7.7° |

Every case the fold walks, FOLD2 walks at a quarter (in place, turning at
20 °/s) to four fifths (back 0.10, the combined 0.10 + 20 °/s) of the
fold's worst tilt; 0.15 m/s forward, which tipped the fold in 3 of 6
phases, is 6 of 6 at 6.7° worst; 0.10 m/s sideways is 6 of 6 at 3.9°.  The edge is 0.20 m/s
forward: 4 of 6 to the tilt stop, at the 9 N·m clip — section 4's
torque-rate budget, which the CoM does not move.  The x/y velocity comes
out ~10 % over the command here too (0.110 for 0.10): the estimator's
under-read of section 6.7, not the posture's.

### 7.3 The hardware unknowns

Three phases each, as section 6.6:

| variant | case | runs | tipped >15° | tilt stop | max tilt (median) | true (vx, vy, r), stood | peak τ |
|---|---|---|---|---|---|---|---|
| friction + IMU 15 ms | fwd10 | 3 | 0 | 0 | 3.3° (3.0°) | +0.109, +0.000, −0.0 | 5.0 N·m |
| friction + IMU 15 ms | lat05 | 3 | 0 | 0 | 2.8° (2.7°) | +0.000, +0.063, +0.0 | 3.7 N·m |
| friction + IMU 15 ms | yaw20 | 3 | 0 | 0 | 2.1° (2.1°) | +0.001, +0.004, +20.0 | 3.8 N·m |
| floor μ 0.5 | fwd10 | 3 | 0 | 0 | 3.2° (3.0°) | +0.111, +0.000, +0.0 | 5.0 N·m |
| floor μ 0.5 | lat05 | 3 | 0 | 0 | 3.1° (2.2°) | +0.000, +0.057, −0.1 | 3.7 N·m |
| floor μ 0.5 | yaw20 | 3 | 0 | 0 | 1.2° (1.2°) | +0.000, +0.000, +20.0 | 3.9 N·m |
| rotor 0.6, M0 DOG5's | inplace | 3 | 0 | 0 | 1.0° (1.0°) | — | 3.3 N·m |
| rotor 0.6, M0 DOG5's | fwd10 | 3 | 0 | 0 | 4.1° (4.0°) | +0.107, +0.002, −0.1 | 4.4 N·m |
| rotor 0.6, M0 DOG5's | lat05 | 3 | 0 | 0 | 3.2° (3.1°) | +0.000, +0.058, −0.0 | 3.6 N·m |
| rotor 0.6, M0 DOG5's | yaw20 | 3 | 0 | 0 | 1.0° (1.0°) | +0.000, +0.001, +19.9 | 3.8 N·m |
| rotor 0.6, M0 fitted | inplace | 3 | 0 | 0 | 0.9° (0.9°) | — | 2.6 N·m |
| rotor 0.6, M0 fitted | fwd10 | 3 | 0 | 0 | 2.0° (1.5°) | +0.112, +0.000, −0.0 | 3.4 N·m |
| rotor 0.6, M0 fitted | lat05 | 3 | 0 | 0 | 3.2° (2.2°) | +0.000, +0.055, −0.0 | 2.6 N·m |
| rotor 0.6, M0 fitted | yaw20 | 3 | 0 | 0 | 1.0° (1.0°) | −0.000, +0.001, +20.0 | 2.7 N·m |

None tipped.  The rotor that tipped the fold once in three with DOG5's M0
(section 6.6) costs FOLD2 under a degree at 0.10 m/s (4.1° against 3.3°),
and fitted it is calmer than the model's own (2.0°, peak torque 3.4 N·m).
The fitted armature is still the first thing to do on the robot — it is a
gain — but on FOLD2 the walk does not hang on it.

## 8. Feasibility

**In MuJoCo: yes, inside the envelopes of sections 6.5 and 7.2.**  The fold
(`hw.fold_walk`): every case at every phase tried under 10° of tilt, peak
torque 3.7–6.2 N·m against the 9 N·m clip, the commanded yaw rate tracked
to 0.2 °/s; **0.15 m/s forward: no** — past the swing's torque-rate budget
(section 4) and the diagonal's roll.  FOLD2 (`hw.fold2_walk`): wider and
calmer — **0.15 m/s forward and 0.10 sideways: yes**, everything under 8°;
**0.20 m/s forward: no**.  If one stance is to walk first on the robot, the
simulation says FOLD2.  Both under the QP, which section 5.1 shows is the
least squares wherever the cone does not bind.

**On the robot: plausible, on three conditions.**

1. **Fit the armature first.**  `hw.swing_bench --analyse` on a hung-leg
   log, then `hw.fold_walk --ff-armature <fit>`.  Without it the task-space
   law flies DOG5's M0, too strong by the rotor ratio (section 6.6).
2. **Watch the swing against the gate.**  The log's `x_b` against
   `p_swing`, and `tau_req` against `tau_cmd`: a triangle in `tau_cmd`
   under a peak in `tau_req` is figure 1's failure.  If DOG6's rotor really
   is 1/1.7 of DOG5's, the demand is that much lower than here.
3. **The Pi's sweep time** (section 6.8).

A first flight, each step only if the last was clean: `hw.fold2_walk
--fake --auto 1 --no-imu` (the whole path, no robot); on the robot, T and
trot in place with the walk attached (this is *not* `hw.fold2_trot`'s trot
in place: duty 0.70, no settle, the task-space swing); Q / E once
(10 °/s); W once (0.05 m/s), SPACE, S once; A / D once (0.05 m/s); then a
second press.  SPACE, a cycle or two in place, T, ENTER to park.  The keys'
box is the same 0.10 / 0.05 m/s and 20 °/s on both stances; on FOLD2
`--v-max 0.15 0.10 --yaw-rate-max 40` is still inside what MuJoCo walked,
once the first flights are clean.  The same order on `hw.fold_walk`.

**What would widen it**, roughly in order of cost: the measured armature
(lower demand, condition 1); the gate's slew for the swinging legs only
(`--tau-slew` is every joint's, and the operator's to raise); the swing's
z referenced to the measured ground rather than the commanded height (sag
eats the 20 mm apex — the scuffs precede the falls); a lateral foothold term
on roll (the capture point about the diagonal); and the structural one, a
horizon — cMPC plans the next stance's wrench and absorbs the foothold
errors this law cannot.

## 9. What is not modelled

- **DOG6's rotor.**  The plant is DOG5's 0.0085 kg·m² a joint unless a
  scenario scales it (section 6.6).
- Backlash, the foot's real friction (MuJoCo's 1.0 unless set), the real
  floor; slip only as MuJoCo's contact makes it.
- The Pi's timing: the harness charges a fixed 0.5 ms for the law; section
  6.8 has what the law costs on this machine.
- A horizon.  This is the SRB PD; nothing plans the next stance's wrench,
  which is what cMPC uses to absorb the foothold errors that this law
  cannot.

## 10. Reproduce

```
V=<a python with numpy, scipy, mujoco 3.x>
$V -m hw.balance.selftest                      378 checks, the same 2 failures as before
$V doc/walk/walksim.py                         6.5, the single runs (STANDARD)
$V doc/walk/walksim.py --v0                    6.1
$V doc/walk/walksim.py --sens                  6.2 (--grid, --grid2: the grids behind it)
$V doc/walk/walksim.py --qrepeats              6.3, 6.4
$V doc/walk/walksim.py --xrepeats              6.5, 6.6
$V doc/walk/walksim.py --allocs                5.1, the trots in place, QP against least squares
$V doc/walk/walksim.py --fold2                 7.1, FOLD2 single runs
$V doc/walk/walksim.py --f2repeats             7.2, FOLD2 six phases a case
$V doc/walk/walksim.py fwd10 f2_lat05          any named scenario (--list)
```

Runs write `doc/walk/data/walk_<name>.json` (metrics) and `.npz` (the
hwsim log plus the walk's trace: `w_p_swing`, `w_land_w`, `w_ref_*`,
`w_est_*`, `w_f_w`); both are git-ignored.  ~15 s a run, four at a time.
The two figures are drawn from those files.

The two `selftest` failures are the baseline's, unchanged by this work: the
whole-law timing check against the 333 µs CAN slot (this VM is slower than
the machine it was set on) and `fold_stand`'s roll gain check.

### 10.1 Reproduce (section 11)

```
$V doc/walk/longrun.py inplace        11.2  (L_*: 8 configs x 2 plants, 30 s)
$V doc/walk/longrun.py single         11.3  (S_*: one unknown at a time)
$V doc/walk/longrun.py corr           11.4  (C_*: the pin alone)
$V doc/walk/longrun.py cent           11.4  (K_*: the stance re-centred)
$V doc/walk/longrun.py box            11.5  (B_*: the keys' box, hwlike)
$V doc/walk/walksim.py ; $V doc/walk/walksim.py --fold2     11.5
```

### References

- Di Carlo, Wensing, Katz, Bledt, Kim, *Dynamic Locomotion in the MIT Cheetah 3
  Through Convex Model-Predictive Control*, IROS 2018,
  [doi:10.1109/IROS.2018.8594448](https://doi.org/10.1109/IROS.2018.8594448) —
  the reference generator, eq (33), the swing law `sim.cmpc` implements.
- Bledt, Powell, Katz, Di Carlo, Wensing, Kim, *MIT Cheetah 3: Design and
  Control of a Robust, Dynamic Quadruped Robot*, IROS 2018,
  [doi:10.1109/IROS.2018.8593885](https://doi.org/10.1109/IROS.2018.8593885) —
  the SRB balance controller (eqs 2–3) and its QP force distribution.
- MIT Biomimetic Robotics Lab, [Cheetah-Software](https://github.com/mit-biomimetics/Cheetah-Software),
  `ConvexMPCLocomotion.cpp` — `max_pos_error` (the leash), `pYawCorrected`.
- Raibert, *Legged Robots That Balance*, MIT Press 1986 — the foothold's
  velocity-feedback term.
- Khatib, *A unified approach for motion and force control of robot
  manipulators: the operational space formulation*, IEEE J. Robotics and
  Automation 3(1), 1987,
  [doi:10.1109/JRA.1987.1087068](https://doi.org/10.1109/JRA.1987.1087068) —
  the task-space swing law, `JᵀΛ = M J⁻¹` for a square J.
- Nocedal, Wright, *Numerical Optimization*, 2nd ed., Springer 2006,
  [doi:10.1007/978-0-387-40065-5](https://doi.org/10.1007/978-0-387-40065-5),
  Alg. 16.3 — the primal active set.

## 11. What fails after a while, and what does not: 30 s on a robot-like plant

*2026-10-05, after the robot: the fold trot stands, then loses its balance
"after a while"; the walk's trot in place is worse than `hw.fold_trot`'s
and goes the same way sooner; other Kp / Kd did not cure either.
`doc/walk/longrun.py` runs both for 30 s in place, then the keys' box, on
a plant with every hardware unknown the bench and `doc/crouch_trot` name
at once, and then one at a time.  Section 10.1 says how to reproduce.*

**Two things changed under this section, and they change section 6's
numbers too.**  (1) `hwsim` measured the trunk with the *crouch's* SRB
model while the law flew `srb_at(height, stand feet)` -- for the fold, c^b
x -6.9 against -17.8 mm and z -31.3 against -27.2 -- where `hw.stand.run`
uses the law's for both.  Every fold number above was produced with that
11 mm mismatch inside the controller; the harness now does what the robot
does, and the standard set re-run on it is in 11.5.  (2) A fall mid-walk
straightened a planted leg, its Jacobian went singular and
`np.linalg.solve` raised out of `walk.hold_targets`; on the robot
`hw.stand.run` ends on any exception and the bus closes, so the exception,
not the fall, would have ended the run.  `swing.solve_jacobian` (the
least-squares answer on a singular matrix) now sits under the walk's and
the swing laws' solves; `selftest` §14 checks it.

### 11.1 The plant

`hwlike` is every unknown at once: the rotor 0.6x DOG5's with the law's
M0 left at DOG5's (the bench's reading), 0.1 N·m of joint Coulomb and the
IMU 15 ms late, floor μ 0.7, the CoM 3 / 5 mm off the CAD's in trunk x / y,
and 10 % less torque per amp.  `ideal` is the model as drawn.  Each run is
`T_HOLD` 3 s, then 30 s of trot in place, four at a time, ~25 s each.  The
new column is the **tilt rms per 10 s of trot**: a number that grows is
the failure that takes a while.

### 11.2 In place for 30 s

| config | plant | fell | max tilt | tilt rms per 10 s | drift x / y | peak τ |
|---|---|---|---|---|---|---|
| `hw.fold_trot` as shipped (impedance 10/10/400, duty 0.80, settle 0.2) | ideal | no | 2.2° | 0.68 / 0.68 / 0.63 | −2 / 6 mm | 1.38 |
| | **hwlike** | no | **9.7°** | **2.24 / 3.71 / 5.89** | −33 / −72 mm | 3.19 |
| `hw.fold_walk` as shipped (osc 25/25/20, duty 0.70, no settle) | ideal | no | 2.8° | 1.13 / 1.13 / 1.13 | 74 / 11 mm | 3.57 |
| | **hwlike** | no | 7.6° | 3.79 / 4.08 / 4.03 | **250 / 675 mm** | 3.64 |
| `hw.fold_walk --swing-law impedance --duty 0.8 --contact-ramp 0.15 --settle 0.2` (the walk's 150/150/400 on the trot's clock) | ideal | no | 2.2° | 0.66 / 0.64 / 0.64 | 5 / 0 mm | 1.28 |
| | **hwlike** | no | **4.3°** | **1.65 / 1.60 / 1.54** | 44 / 12 mm | 1.33 |
| … the same with the trot's own 10/10/400 (`--kp-swing-walk 10 10 400 --kd-swing-walk 5 5 40`) | ideal | no | 2.2° | 0.59 / 0.55 / 0.55 | 7 / −2 mm | 1.37 |
| | **hwlike** | **yes, 5.7 s** | 51.9° | 6.76 | 27 / 133 mm | 6.57 |

On the ideal plant all four are the same trot to half a degree, and the
walk's in-place trot is 0.6° worse than the trot's -- the osc swing's
torque (3.6 against 1.4 N·m) is the one visible difference.  On the
robot-like plant the shipped trot **rocks harder every 10 s** and the
shipped walk drifts two thirds of a metre sideways while "in place"; the
walk's impedance on the trot's clock is the one configuration whose rms
stays flat, and the trot's soft 10 N/m gains on the walk fall in 6 s.

### 11.3 One unknown at a time

| unknown, alone | `hw.fold_trot` | … with `--kp-swing 150 150 400 --kd-swing 6 6 40` | `hw.fold_walk` (osc) | walk, impedance on the trot's clock | walk, the trot's 10/10/400 |
|---|---|---|---|---|---|
| none (ideal) | 2.2°, rms 0.68 / 0.68 / 0.63 | 2.2°, 0.77 / 0.77 / 0.71 | 2.8°, 1.13 / 1.13 / 1.13 | 2.2°, 0.66 / 0.64 / 0.64 | 2.2°, 0.59 / 0.55 / 0.55 |
| rotor 0.6x, M0 DOG5's | 2.2°, 0.67 / 0.65 / 0.68 | 2.2°, 0.68 / 0.69 / 0.73 | 4.0°, 1.55 / 1.60 / 1.61 | 2.2°, 0.62 / 0.62 / 0.65 | 2.2°, 0.60 / 0.56 / 0.58 |
| rotor 0.6x, M0 fitted | — | — | 2.8°, 1.26 / 1.26 / 1.31 | — | — |
| **CoM 3 / 5 mm off** | **10.4°, 2.41 / 5.20 / 5.71** | **4.4°, 1.56 / 1.65 / 1.69** | **fell, 6.1 s** | **4.6°, 1.69 / 1.73 / 1.76** | **fell, 4.2 s** |
| 0.1 N·m friction + IMU 15 ms | 2.1°, 0.50 / 0.56 / 0.70 | 1.7°, 0.49 / 0.51 / 0.54 | 2.9°, 1.36 / 1.33 / 1.25 | 1.6°, 0.50 / 0.52 / 0.51 | 2.7°, 0.77 / 0.90 / 0.90 |
| floor μ 0.7 | 2.3°, 0.69 / 0.69 / 0.67 | 2.2°, 0.77 / 0.80 / 0.71 | 2.8°, 1.12 / 1.13 / 1.13 | 2.2°, 0.65 / 0.63 / 0.64 | 2.2°, 0.60 / 0.52 / 0.56 |
| torque 0.9x per amp | 2.0°, 0.56 / 0.54 / 0.53 | 2.0°, 0.60 / 0.61 / 0.59 | 2.7°, 0.96 / 0.94 / 0.95 | 2.0°, 0.55 / 0.56 / 0.55 | 2.0°, 0.46 / 0.41 / 0.45 |

(max tilt over 30 s in place, then the tilt rms over each 10 s.)

One of the five does all of it: **the CoM 3 / 5 mm off the CAD's**.  Alone
it takes the shipped trot to 10° with the rms growing 2.4 → 5.2 → 5.7 and
fells the shipped walk in 6 s; the rotor, the friction with the latency,
the floor and the torque constant cost under a degree each, growing
nothing.  The log of the trot says how: with the real CoM 5 mm to the
left, the left feet carry 18 N against the right's 14, the integrator-less
attitude loop parks the trunk at −4° of roll, and each swing lands its
foot a little inboard of the site because the trunk it is planned in is
rolled; at 10 N/m in x/y the swing does not pull it back out.  The stance
narrows from 124 to 110 mm over the 30 s, every roll is worse on the
narrower stance, and so on.  With the walk's 150 N/m the feet come back to
their sites each swing (the stance stays at 123–124 mm) and the rms stays
at 1.6°: that is the whole difference between the two impedance rows
above, and it is why `hw.fold_trot --kp-swing 150 150 400 --kd-swing 6 6
40` halves the damage (4.5°, flat) without touching anything else.

### 11.4 The cure is geometry, not a gain

The pin alone (`C_*`: the plant's CoM 3 / 5 mm off, the law's
`SrbModel.com_body` shifted by the same) buys almost nothing: the trot
9.7 → 7.9°, still growing; the osc walk 7.6 → 7.2°, still drifting.  A
model does not fix geometry -- the trunk rocks about whichever trot
diagonal the real CoM is further from, and the fold's CoM is already
5.7 mm off both.  Moving the stand's sites **with** the offset, so both
diagonals pass through the real CoM (`K_*`; `hw.stand --com-offset DX DY`
does both), brings everything back to the ideal plant:

| config, hwlike plant | pin alone (`C_`) | stance re-centred (`K_`) | ideal |
|---|---|---|---|
| `hw.fold_trot` in place | 7.9°, rms 1.8 / 2.7 / 4.2 | **1.9°, rms 0.5 / 0.7 / 0.8** | 2.2° |
| `hw.fold_walk` (osc) in place | 7.2°, drift 0.6 m | 3.8°, drift 0.24 m | 2.8° |
| … impedance on the trot's clock, in place | 3.9° | **1.5°** | 2.2° |
| … the trot's 10/10/400 on the walk, in place | fell 7.9 s | 2.3° | 2.2° |
| osc: 0.06 fwd / 0.06 back / 0.03 left / 12 °/s / 0.06 + 12 °/s | fell / fell / fell / fell / fell | 3.6° / 3.5° / 5.8° / 3.6° / 3.8° | — |
| impedance, trot's clock: the same five | 9.6° / 3.9° / fell / 5.5° / 11.2° | 5.8° / 1.6° / 3.3° / 3.0° / 10.5° | — |

(The first try moved the sites the other way, and every case fell on its
first swing: the CoM was then 10 mm off centre instead of 5.  The sign
is measured minus pinned, and `hw.com_check` prints it that way.)

Moving, the two swing laws split as section 6 found: the osc walks the
box at 3.5–5.8°, the impedance on the trot's clock is calmer in place and
turning but asks the 9 N·m clip at 0.06 m/s forward (the 120 ms swing
carrying a 36 mm step) and reaches 10.5° in the combined case.

### 11.5 The keys' box and the standard set on the fixed harness

The keys' box (0.06 / 0.03 m/s, 12 °/s), robot-like plant, CoM NOT
corrected -- what the robot is doing today if its CoM is off by this
much:

| case | osc as shipped | osc, M0 fitted | impedance, trot's clock (150/150/400, duty 0.8, settle) | the trot's 10/10/400, trot's clock | 150/150/400, duty 0.70 | 10/10/400, duty 0.70 |
|---|---|---|---|---|---|---|
| in place, 30 s | 7.6°, drift 0.7 m | fell 3.2 s | **4.3°** | fell 5.7 s | fell 2.6 s | fell 1.9 s |
| forward 0.06 | fell 3.8 s | fell 3.0 s | 11.2° (τ 9.0) | fell 3.3 s | fell 2.6 s | fell 1.9 s |
| back 0.06 | fell 4.3 s | fell 3.0 s | **4.3°** | fell 4.6 s | fell 2.6 s | fell 1.9 s |
| left 0.03 | fell 3.2 s | fell 2.6 s | fell 4.0 s | fell 2.7 s | fell 2.3 s | fell 1.8 s |
| turn 12 °/s | fell 5.2 s | fell 3.5 s | fell 8.3 s | 7.7° | fell 2.5 s | fell 1.9 s |
| 0.06 + 12 °/s | fell 4.6 s | fell 3.5 s | fell 6.2 s | fell 3.3 s | fell 2.5 s | fell 1.9 s |

With the CoM 5 mm off and uncorrected, **nothing walks** the box, and
every configuration on the walk's own clock (duty 0.70, 180 ms of swing)
is on the floor within two seconds -- the longer two-foot phase is the
longer the trunk falls about a diagonal the CoM is not on (section 4).
With the stance re-centred (11.4) every one of these stands.

The standard set (section 6.5) and FOLD2's (7.1), re-run with the
harness measuring on the law's own pin:

| unknown, alone | `hw.fold_trot` | … with `--kp-swing 150 150 400 --kd-swing 6 6 40` | `hw.fold_walk` (osc) | walk, impedance on the trot's clock | walk, the trot's 10/10/400 |
|---|---|---|---|---|---|
| none (ideal) | 2.2°, rms 0.68 / 0.68 / 0.63 | 2.2°, 0.77 / 0.77 / 0.71 | 2.8°, 1.13 / 1.13 / 1.13 | 2.2°, 0.66 / 0.64 / 0.64 | 2.2°, 0.59 / 0.55 / 0.55 |
| rotor 0.6x, M0 DOG5's | 2.2°, 0.67 / 0.65 / 0.68 | 2.2°, 0.68 / 0.69 / 0.73 | 4.0°, 1.55 / 1.60 / 1.61 | 2.2°, 0.62 / 0.62 / 0.65 | 2.2°, 0.60 / 0.56 / 0.58 |
| rotor 0.6x, M0 fitted | — | — | 2.8°, 1.26 / 1.26 / 1.31 | — | — |
| **CoM 3 / 5 mm off** | **10.4°, 2.41 / 5.20 / 5.71** | **4.4°, 1.56 / 1.65 / 1.69** | **fell, 6.1 s** | **4.6°, 1.69 / 1.73 / 1.76** | **fell, 4.2 s** |
| 0.1 N·m friction + IMU 15 ms | 2.1°, 0.50 / 0.56 / 0.70 | 1.7°, 0.49 / 0.51 / 0.54 | 2.9°, 1.36 / 1.33 / 1.25 | 1.6°, 0.50 / 0.52 / 0.51 | 2.7°, 0.77 / 0.90 / 0.90 |
| floor μ 0.7 | 2.3°, 0.69 / 0.69 / 0.67 | 2.2°, 0.77 / 0.80 / 0.71 | 2.8°, 1.12 / 1.13 / 1.13 | 2.2°, 0.65 / 0.63 / 0.64 | 2.2°, 0.60 / 0.52 / 0.56 |
| torque 0.9x per amp | 2.0°, 0.56 / 0.54 / 0.53 | 2.0°, 0.60 / 0.61 / 0.59 | 2.7°, 0.96 / 0.94 / 0.95 | 2.0°, 0.55 / 0.56 / 0.55 | 2.0°, 0.46 / 0.41 / 0.45 |

(max tilt over 30 s in place, then the tilt rms over each 10 s.)TD

### 11.6 What to do on the robot, in order

*Rewritten 2026-10-06: the CoM is now measured by the run itself (11.7).*

1. **Fly the trot and let the HOLD measure the CoM.**  `hw.fold_trot --log
   <a new name>.npz`: hold still in HOLD for at least 1.5 s, then T.  The
   notice at T says what the HOLD read (x/y, its p10..p90, Fz/W against the
   pin) and that the stance is re-centring; the trot starts by itself 0.5 s
   later.  `--com-auto` is the default on every trot that tracks its rise;
   `--no-com-auto` is the run as it was.
2. **Read every HOLD off the log**: `python -m hw.com_check <log>.npz` --
   one row per HOLD, the pin the law flew there, and each T's re-centring.
   If successive HOLDs read millimetres apart, joint stiction is the first
   suspect (11.7), not the CoM moving.
3. **The walk the same way, with the joint spring in its HOLD.**  Since
   2026-10-06 the working tree defaults the walks' stance to damping-only
   (`config.WALK_KP_JOINT` 0); on that HOLD `--com-auto` is off and
   refused, and in MuJoCo that stance falls on the robot-like plant
   uncorrected (11.7).  `hw.fold_walk --kp-joint 5 --kp-joint-abd 5
   --swing-law impedance --duty 0.8 --contact-ramp 0.15 --settle 0.2` is
   the walk as simulated, with the CoM measured and applied.
4. **If T says NOT APPLIED** (torque readback not believed, the robot not
   still, past 15 mm), the configurations that survive an uncorrected CoM
   in place: the walk's line above, and `hw.fold_trot --kp-swing 150 150
   400 --kd-swing 6 6 40`.
5. **Fit the armature** (`hw.swing_bench --analyse`, `--ff-armature`) for
   the osc walk: with the rotor at 0.6x and M0 unfitted it is 3.9° in
   place against 2.7° fitted -- real, and a tenth of the CoM's effect.

### 11.7 The CoM measured in every HOLD and applied at T (`--com-auto`)

*2026-10-06, on request: "each hold will bring the new com shift, so why
not directly read the com shift when hold and use it when I press T".*

**What it does.**  Every HOLD sweep, `hw.balance.com_estimate` reads the
CoM off the drivers' measured torque -- `hw.com_check`'s statics, one
batched solve, 44 us on the Pi, in a CAN slot of its own (`hw.stand.COM_SLOT`)
-- skipping the first 0.5 s.  T takes the HOLD's median (at least 1.0 s of
it; T pressed sooner waits), moves the SRB pin and every stance site by
measured - pinned, and slides the trunk over the four planted feet onto it
for 0.5 s with the tracked layer (the slanted rise's mechanism); then the
trot starts.  Not applied, with the reason in the notice, when Fz/W is
outside 0.5..1.5, the HOLD's p10..p90 spans more than 15 mm, or the
correction is past 15 mm.  The log carries `com_meas` and `com_pin`;
phase `recentre` is the slide.  `python doc/walk/longrun.py auto` reruns it.

**MuJoCo, the robot-like plant (11.1, the CoM 3 / 5 mm off), 30 s in
place, nothing told to the law.**  The HOLD read +2.5 / +4.6 mm against the
plant's true +2.7 / +5.0 (spread 1.2 mm, Fz/W 1.19 -- the plant's 0.9
torque per amp); `A_` is the run with it applied at T, `L_` uncorrected,
`K_` re-centred by hand on the true offset:

| config | `L_` uncorrected | `A_` measured and applied at T | `K_` by hand |
|---|---|---|---|
| `hw.fold_trot` | 9.7°, rms 2.24 / 3.71 / 5.90 | **2.4°, rms 0.76 / 0.83 / 1.00** | 1.9°, 0.54 / 0.67 / 0.74 |
| `hw.fold_walk` (osc) | 7.7°, drift 0.7 m | **4.1°**, drift 0.28 m | 3.8°, 0.25 m |
| walk, impedance 150 on the trot's clock | 4.3° | **2.0°** | 1.4° |
| walk, the trot's 10/10/400 on the trot's clock | fell, 5.7 s | **2.6°** | 2.4° |
| `hw.fold_trot`, the IDEAL plant | -- | 2.2°, read 0.2 mm, nothing applied | (ideal 2.2°) |

The keys' box (0.06 / 0.03 m/s, 12 °/s): every `A_` case stands -- osc
4.5-5.7°, within 1.2° of `K_`; impedance 2.0-3.6° back, left and turning
and 7.7° forward (`K_` 8.3°, both at the 9 N·m clip), and 11.7° forward
with the turn against `K_`'s 8.5°.  Uncorrected (11.5) the osc fell in all
five and the impedance in three.

**The joint spring is what makes the reading true.**  The walks' new
damping-only stance (`config.WALK_KP_JOINT` 0, uncommitted on 2026-10-06)
holds its HOLD with no spring, the joints freeze where the rise left them,
and stiction carries part of the load the drivers do not report: that HOLD
read +1.2 mm in y where the truth was +5.0, and the walk fell at 6.8 s.
`StandSequence` now refuses `com_auto` without the HOLD's spring.  The same
damping-only stance with nothing auto about it, impedance 150 on the trot's
clock:

| plant | with the joint spring | damping-only |
|---|---|---|
| ideal | 2.2°, rms 0.66 | 2.8°, rms 1.03 / 1.04 / 1.06 |
| ideal, osc | 2.8°, rms 1.13 | 6.1°, rms 1.92 / 1.91 / 2.05, drift 0.29 m |
| robot-like, uncorrected | 4.3° | **fell, 5.3 s** |
| robot-like, re-centred by hand | 1.4° | 7.5°, rms 3.11 / 4.19 / 4.69 -- growing |

On the robot, a HOLD-to-HOLD difference of a few millimetres may be the
same stiction rather than the CoM moving: the robot's own logs read the
nominal stance at +2.7 / -0.8 mm (`trot_kd.npz`, first HOLD, 1.1 s) and
the fold's at -6.7 / +2.3 (`fold_walk_bisect.npz`, 0.3 s) -- the fold's x
the OPPOSITE sign to the 3 mm this section simulated, which is the point of
measuring it every run.

### 11.8 The robot weighs 5.210 kg

*2026-10-06: the operator weighed DOG6 at 5.210 kg, 0.673 kg (11 %) under
the CAD's 5.883.*  `hw.balance.config.MASS` is now the weighed mass -- the
SRB law's m g and the force per m/s² of its PD, the allocator's box, the
residual trip, `com_estimate`'s Fz/W -- and the per-leg baseline and the
wave are handed it on the robot.  Where the 0.673 kg is missing from was not
measured: c^b and I^b keep the CAD's shape, and `--com-auto` measures c^b's
x/y in every HOLD.  **`hwsim`'s plant now weighs the same by default**
(`HwParams.trunk_mass_add` = `MASS - P.MASS`, taken off the trunk);
`trunk_mass_add=0.0` is the CAD's robot every table above was run on.

On the weighed plant, 30 s in place, the law's m makes little difference --
the joint layer holds the stance stiffly enough that a 6.6 N force error
moves the trunk under a millimetre:

| | law m 5.210 (now) | law m 5.883 (flown until now) |
|---|---|---|
| `hw.fold_trot` | 2.0°, rms 0.65 / 0.63 / 0.60, height −0.5 mm | 2.0°, 0.68 / 0.68 / 0.73, +0.1 mm |
| … drivers delivering 0.886 of the torque | 1.7°, 0.51 / 0.50 / 0.49, −0.8 mm | 1.9°, 0.58 / 0.56 / 0.56, −0.2 mm |
| … robot-like plant, `--com-auto` | 2.3°, 0.68 / 0.69 / 0.77, −1.0 mm | 2.3°, 0.70 / 0.73 / 0.80, −0.4 mm |
| walk, impedance on the trot's clock, robot-like, `--com-auto` | 2.0°, 0.63 / 0.60 / 0.60, −0.9 mm | 2.1°, 0.59 / 0.52 / 0.52, −0.3 mm |

(height: median of the legs' height minus the command over the trot.)  The
same stiffness means a robot log's height says nothing about the drivers'
torque constant.

### 11.9 The second `hw.fold2_walk` flight, and the governor

*2026-10-06, `fold2_walk_2.npz`: the joint spring and `--com-auto` on, the
walk's impedance on the trot's clock.  17 minutes of trot: 413 s in place,
then 630 s with 104 s of W/S/A/D/Q/E in it.  It fell walking left.  Times
below are the log's own clock (`t`), not sweeps / 250: the loop runs 5.5 ms
a sweep in every trot (tracker item).*

**What the run did.**  HOLD 11.7 s; the CoM read −0.6 / −1.6 mm, applied as
−0.3 / −1.4: FOLD2's CoM is on its pin.  In place the tilt peaked 3.5–7.7°
per 15 s window and the trunk sat ~1° rolled with the right feet carrying
26–28 N against the left's 20–23.  Walking at 0.015–0.03 m/s and 6 °/s the
tilt peaked 7–12°; the operator pressed SPACE at 200, 329 and 539 s (tilt
12.2, 9.0, 8.1°) and each time the trot in place had it back under 3° within
1–2 s.

**The fall (629 s), at 20 ms.**  A at 0.03 m/s for 4 s.  The FR/RL swing
lags its arc 24–27 mm to the *right* (the trunk is going left) and lands
late; the landing rolls the trunk right, +0.9 → +7.6° in 80 ms, and the
left feet drop to 1 N.  The next FL/RR landing adds to it (9°), the one
after (14°); by 629.8 s the robot stands on its right feet alone, rolling
over them, and the fall hold takes it at 43°.  The operator's SPACE came at
629.3 s; the tilt was back to 3° at 629.6 and the next landing threw it.
Once the trunk is rolled, the trunk-frame arcs land the low-side foot early
and the high-side foot late, which rolls it further: a loop that closes
through the landings.  The swing's tracking error is not a trigger for
this: walking, the swing lands 15 mm (median) and 27 mm (90th percentile)
off its arc on this robot, and the fall's 25 mm is inside that.

**The governor (`hw/balance/governor.py`), on request: "the script decides
which time to stop the command to trot in place for stable".**  Every
sweep the walk plan takes the roll and pitch *from the setpoint*, low-passes
them at 1.5 Hz (the trot's own ±3–7° rocking at 1.7 Hz passes at a third,
a lean passes whole) and calls the larger the **lean**.  Past 5° it
**pauses** the keys: the reference gets zero (it slews to rest in ~60 ms and
the next swing is the in-place arc), the keys are kept.  Under 3° for 1.0 s
it resumes them.  A second pause within 5 s of a resume says the command
itself tips the robot: the keys are **cleared** as SPACE would and the
operator is told to press again.  `--pause-lean DEG` (0 off), `--calm-lean`,
`--calm-s`; the status line shows the lean; the exit report counts the
pauses.  Everything a tilt *rate* would add was tried on the log and refused
(the rocking's ±60 °/s fires it hundreds of times).

Replayed on the log through the real class: five pauses, at 82.4, 185.1,
199.9, 539.9 and 629.1 s — the operator's own moments, 0.2 s before the
operator at the fall — 9.2 s paused of 630, none in the 526 s of in-place
trot.  Whether 0.2 s is enough to save that fall the robot decides.

In MuJoCo (FOLD2, the robot-like plant, `--com-auto`, walking left at
0.03 m/s, a 0.25 s sideways push 4 s in):

| push | walking, governor on | walking, governor off | in place |
|---|---|---|---|
| none | 2.2°, no pause | 2.2° | 1.4° |
| 4 N | 2.4°, no pause | 2.4° | 1.4° |
| 8 N | 2.5°, no pause | 2.5° | 3.7° |
| 12 N | 4.8°, no pause | 4.8° | 11.0°, one pause, 1.6 s |

The governor is silent through a walk that stays under 5° of lean, which
is what it should be: the model does not reproduce the robot's lagging
swing, so the model does not reproduce the fall.  (The same plant with the
CoM *not* re-centred fell walking left under a 4 N push, governor or no
governor, where in place it survived 10 N: the lateral walk at the box
speed has no margin without the re-centring.)

**Next on the robot:** the same command line, the governor on by default;
watch for `walk PAUSED`.  If pauses come and the robot still falls, the
stage after this one is a HOLD at the next four-foot window instead of a
trot in place — four feet down have the roll authority two do not.
