snowyfoams/dog6/doc/gait_study/runs/figs/p1_inplace_1/summary.txt

== p1_inplace_1 ==
  trot 120.0 s, 150 cycles; period 0.800 s, swing 160 ms, ramp 96 ms; sweep 5.51 ms; no fall hold
  attitude from the setpoint (-0.29 / 0.12 deg): roll mean +1.68  rms 1.79  min -0.59 max +4.50;  pitch mean -0.63 rms 0.65;  tilt max 4.50;  lean max 3.53
  tilt rms per 10 s: 1.17 1.25 1.14 1.20 1.39 1.74 1.71 2.02 2.12 2.25 2.31 2.43
  height mean 159.7 mm (cmd 160.0), min 154.4;  yaw drift +0.42 deg
  THE IMU AGAINST THE FEET.  Trunk attitude relative to the plane of the four feet (roll, pitch, deg): HOLD -0.08 / -0.01, trot four-foot windows -0.68 / +0.03;  the IMU says HOLD +1.31 / -0.37, trot +1.41 / -0.53.  IMU minus feet: HOLD +1.39 / -0.35, trot +2.09 / -0.56 -- on a flat floor that is the IMU's datum error (mount + statics)
  levelled foot heights with all four loaded, minus the mean (mm, FL FR RL RR): +4.6 -0.2 +0.1 -4.4 (std 1.3 0.5 0.7 1.2), from 2599 four-foot full-weight sweeps of the trot -- subtracted from every clearance below
  FL  swings 150: apex med  19.7 mm (p10  18.0), scuffed   0 %, liftoff lag med  38 ms, track rms  9.2 mm, end y err med  -0.2 mm | h_td med  9.3 p90 11.5 mm, Phi med 0.00 max 0.56 N s, in air  22 ms med, roll step toward med -0.37 p90 +0.00 deg
  FR  swings 150: apex med  19.3 mm (p10  18.5), scuffed   0 %, liftoff lag med  39 ms, track rms  9.7 mm, end y err med  -3.6 mm | h_td med 11.5 p90 13.0 mm, Phi med 0.14 max 0.36 N s, in air  39 ms med, roll step toward med -0.02 p90 +0.38 deg
  RL  swings 150: apex med  19.1 mm (p10  18.5), scuffed   0 %, liftoff lag med  38 ms, track rms  9.1 mm, end y err med  -0.5 mm | h_td med 11.3 p90 13.3 mm, Phi med 0.04 max 0.38 N s, in air  39 ms med, roll step toward med +0.02 p90 +0.48 deg
  RR  swings 150: apex med  20.9 mm (p10  19.3), scuffed   0 %, liftoff lag med  38 ms, track rms 10.6 mm, end y err med  -2.4 mm | h_td med 13.7 p90 15.6 mm, Phi med 0.18 max 0.84 N s, in air  39 ms med, roll step toward med +0.37 p90 +0.66 deg
  the ratchet (each foot's landing against its liftoff, over the floor as the planted feet show it): dy mean +1.26 mm per swing -> +189 mm over the run (+1.26 mm per cycle, averaged over the four feet); dx +1.20 mm per swing -> +181 mm.  A real drift that is NOT here moved the planted feet: slip.  Roll at landing minus at liftoff: mean +0.16 deg
      FL: dy +0.97 mm/swing (levelled, before the trunk's motion +0.48), roll at lo +1.47 at td +1.51
      FR: dy +0.83 mm/swing (levelled, before the trunk's motion +0.54), roll at lo +1.63 at td +1.91
      RL: dy +1.27 mm/swing (levelled, before the trunk's motion +0.98), roll at lo +1.63 at td +1.91
      RR: dy +1.96 mm/swing (levelled, before the trunk's motion +1.46), roll at lo +1.47 at td +1.51
  stance width front 126.2 -> 127.5 mm (slope -0.06 mm/min), rear 128.2 -> 128.9 (+0.19 mm/min)
  foot offset from the HOLD site, y (mm, start -> end): FL -4.3->-1.5, FR -1.7->-0.2, RL -4.7->-3.4, RR -5.5->-5.1;  x: FL +6.1->+6.5, FR +5.4->+4.1, RL -2.4->-2.6, RR -11.7->-11.3
  e_R cycle mean (deg) roll -0.92 -> -2.42 (slope -0.824 deg/min), pitch +0.45 -> +0.79;  commanded moment mean x -0.298 y +0.213 N m (slope x -0.1451 N m/min)
  two-foot phases 300 (154 ms median).  Moment about the support line, per phase: commanded |median| 0.278 N m, delivered |median| 0.273, and the weight's own toppling moment W d |median| 0.250 -- delivered minus toppling median -0.526 (two feet can make no other).  Roll excursion over a phase median +0.10 deg, |peak| median 0.36
  torque per amp by joint, first fifth -> last fifth of the trot (abd/pitch/knee): FL 0.76>0.63/0.90>0.91/0.97>0.96  FR 0.61>0.35/0.90>0.89/0.97>0.98  RL 0.76>0.75/0.91>0.90/0.96>0.94  RR 0.59>0.74/0.96>0.96/0.84>0.84
  load left / right, first fifth -> last fifth: 22.9 / 26.5 -> 20.6 / 28.8 N
  fz mean per leg (N): FL 10.5 FR 13.4 RL 11.3 RR 14.2;  left 21.8 right 27.6;  f_w y mean per leg (N): +0.19 +0.11 +0.21 +0.12
  estimator: p_est drift x +1.2 y +2.1 mm over the trot; v_est mean x -6.2 y -15.4 mm/s; x/y rows on 100 % of sweeps; their mean force x +0.17 y +0.67 N; commanded moment mean x -0.298 y +0.213 z -0.007 N m
  torque per amp, |meas|/|cmd| on planted legs by joint (abd pitch knee): FL 0.72/0.91/0.96  FR 0.54/0.90/0.98  RL 0.80/0.91/0.95  RR 0.79/0.96/0.85
  peak |tau_cmd| 1.59 N m; slew deficit 0.004 N m s; sweeps at the 9 N m clip 0
