snowyfoams/dog6/doc/gait_study/runs/figs/p1_lat_1/summary.txt

== p1_lat_1 ==
  trot 20.3 s, 25 cycles; period 0.800 s, swing 161 ms, ramp 96 ms; sweep 5.54 ms; no fall hold; TIPPED past 15 deg at 20.1 s, right side down, 40 deg at the end
  attitude from the setpoint (-0.29 / 0.12 deg): roll mean +2.16  rms 3.79  min -2.58 max +40.11;  pitch mean -0.60 rms 0.80;  tilt max 40.11;  lean max 27.29
  tilt rms per 10 s: 1.66 3.22 22.69
  height mean 159.3 mm (cmd 160.0), min 125.8;  yaw drift +0.13 deg
  THE IMU AGAINST THE FEET.  Trunk attitude relative to the plane of the four feet (roll, pitch, deg): HOLD -0.08 / -0.01, trot four-foot windows -0.17 / +0.05;  the IMU says HOLD +1.22 / -0.34, trot +1.78 / -0.53.  IMU minus feet: HOLD +1.30 / -0.32, trot +1.95 / -0.58 -- on a flat floor that is the IMU's datum error (mount + statics)
  levelled foot heights with all four loaded, minus the mean (mm, FL FR RL RR): +4.4 +0.1 -0.2 -4.3 (std 2.4 2.0 2.3 2.4), from 428 four-foot full-weight sweeps of the trot -- subtracted from every clearance below
  FL  swings  25: apex med  19.0 mm (p10  17.4), scuffed   0 %, liftoff lag med  44 ms, track rms 10.4 mm, end y err med  +0.3 mm | h_td med  9.6 p90 16.7 mm, Phi med 0.00 max 2.30 N s, in air  28 ms med, roll step toward med -0.70 p90 +0.71 deg
  FR  swings  26: apex med  18.8 mm (p10  17.6), scuffed   0 %, liftoff lag med  44 ms, track rms 10.5 mm, end y err med  -3.3 mm | h_td med 10.0 p90 13.3 mm, Phi med 0.06 max 2.30 N s, in air  22 ms med, roll step toward med +0.01 p90 +1.63 deg
  RL  swings  26: apex med  19.6 mm (p10  17.3), scuffed   0 %, liftoff lag med  34 ms, track rms  9.9 mm, end y err med  -0.3 mm | h_td med 13.0 p90 18.6 mm, Phi med 0.14 max 0.60 N s, in air  61 ms med, roll step toward med -0.01 p90 +0.75 deg
  RR  swings  25: apex med  20.9 mm (p10  17.3), scuffed   0 %, liftoff lag med  28 ms, track rms 11.7 mm, end y err med  -2.3 mm | h_td med 15.0 p90 16.5 mm, Phi med 0.22 max 1.26 N s, in air  42 ms med, roll step toward med +0.70 p90 +1.71 deg
  the ratchet (each foot's landing against its liftoff, over the floor as the planted feet show it): dy mean +5.50 mm per swing -> +140 mm over the run (+5.62 mm per cycle, averaged over the four feet); dx +0.95 mm per swing -> +24 mm.  A real drift that is NOT here moved the planted feet: slip.  Roll at landing minus at liftoff: mean +1.02 deg
      FL: dy +4.97 mm/swing (levelled, before the trunk's motion +3.70), roll at lo +1.49 at td +1.88
      FR: dy +4.77 mm/swing (levelled, before the trunk's motion +4.50), roll at lo +2.12 at td +3.75
      RL: dy +6.03 mm/swing (levelled, before the trunk's motion +5.75), roll at lo +2.12 at td +3.75
      RR: dy +6.25 mm/swing (levelled, before the trunk's motion +4.97), roll at lo +1.49 at td +1.88
  stance width front 127.6 -> 125.4 mm (slope -13.58 mm/min), rear 128.2 -> 122.5 (-21.16 mm/min)
  foot offset from the HOLD site, y (mm, start -> end): FL -2.1->-0.5, FR +0.2->+3.9, RL -3.0->-2.9, RR -3.8->+1.8;  x: FL +8.2->+6.4, FR +5.7->+4.5, RL -3.4->-3.3, RR -8.6->-8.3
  e_R cycle mean (deg) roll -1.08 -> -2.95 (slope -5.592 deg/min), pitch +0.38 -> +0.85;  commanded moment mean x -0.318 y +0.220 N m (slope x -1.0584 N m/min)
  two-foot phases 51 (155 ms median).  Moment about the support line, per phase: commanded |median| 0.285 N m, delivered |median| 0.292, and the weight's own toppling moment W d |median| 0.296 -- delivered minus toppling median -0.587 (two feet can make no other).  Roll excursion over a phase median +0.38 deg, |peak| median 0.91
  torque per amp by joint, first fifth -> last fifth of the trot (abd/pitch/knee): FL 0.96>0.66/0.90>0.86/0.96>0.92  FR 0.75>0.96/0.90>0.86/0.98>0.97  RL 0.90>0.69/0.91>0.83/0.93>0.92  RR 0.84>0.83/0.95>0.96/0.86>0.84
  load left / right, first fifth -> last fifth: 22.6 / 26.8 -> 20.4 / 29.7 N
  fz mean per leg (N): FL 10.5 FR 13.6 RL 10.9 RR 14.7;  left 21.4 right 28.4;  f_w y mean per leg (N): +0.09 -0.02 +0.07 +0.06
  estimator: p_est drift x +24.3 y +35.7 mm over the trot; v_est mean x -0.1 y +6.1 mm/s; x/y rows on 100 % of sweeps; their mean force x -0.05 y +0.27 N; commanded moment mean x -0.413 y +0.210 z -0.021 N m
  torque per amp, |meas|/|cmd| on planted legs by joint (abd pitch knee): FL 0.70/0.88/0.95  FR 0.93/0.90/0.97  RL 0.81/0.90/0.93  RR 0.88/0.95/0.87
  peak |tau_cmd| 5.13 N m; slew deficit 0.003 N m s; sweeps at the 9 N m clip 0
