snowyfoams/dog6/doc/gait_study/runs/figs/p1_lat_3/summary.txt

/home/user/dog6/doc/gait_study/analyse.py:650: RuntimeWarning: Mean of empty slice
  "%.2f>%.2f" % (np.nanmean(kt[:n5, 3 * i + j]), np.nanmean(kt[-n5:, 3 * i + j]))
== p1_lat_3 ==
  trot 11.2 s, 14 cycles; period 0.799 s, swing 159 ms, ramp 95 ms; sweep 5.43 ms; no fall hold; TIPPED past 15 deg at 11.0 s, right side down, 40 deg at the end
  attitude from the setpoint (-0.29 / 0.12 deg): roll mean +2.25  rms 4.21  min -0.90 max +39.92;  pitch mean -0.56 rms 0.75;  tilt max 39.92;  lean max 25.15
  tilt rms per 10 s: 1.77 11.90
  height mean 159.1 mm (cmd 160.0), min 127.0;  yaw drift +6.20 deg
  THE IMU AGAINST THE FEET.  Trunk attitude relative to the plane of the four feet (roll, pitch, deg): HOLD -0.15 / +0.01, trot four-foot windows -0.13 / +0.02;  the IMU says HOLD +0.67 / -0.27, trot +2.49 / -0.46.  IMU minus feet: HOLD +0.82 / -0.28, trot +2.62 / -0.49 -- on a flat floor that is the IMU's datum error (mount + statics)
  levelled foot heights with all four loaded, minus the mean (mm, FL FR RL RR): +5.0 -0.8 +0.4 -4.6 (std 8.3 4.6 3.2 6.3), from 243 four-foot full-weight sweeps of the trot -- subtracted from every clearance below
  FL  swings  14: apex med  17.2 mm (p10  16.3), scuffed   0 %, liftoff lag med  49 ms, track rms  9.9 mm, end y err med  +0.3 mm | h_td med  8.1 p90 18.1 mm, Phi med 0.00 max 0.20 N s, in air  16 ms med, roll step toward med -0.61 p90 +0.03 deg
  FR  swings  14: apex med  20.5 mm (p10  19.3), scuffed   0 %, liftoff lag med  22 ms, track rms 10.2 mm, end y err med  -1.8 mm | h_td med 11.7 p90 14.2 mm, Phi med 0.16 max 0.90 N s, in air  38 ms med, roll step toward med +0.09 p90 +1.69 deg
  RL  swings  14: apex med  19.5 mm (p10  18.3), scuffed   0 %, liftoff lag med  44 ms, track rms  9.6 mm, end y err med  -0.2 mm | h_td med 12.6 p90 18.5 mm, Phi med 0.07 max 1.11 N s, in air  43 ms med, roll step toward med -0.09 p90 +0.53 deg
  RR  swings  14: apex med  21.7 mm (p10  21.1), scuffed   0 %, liftoff lag med   8 ms, track rms 11.9 mm, end y err med  -1.8 mm | h_td med 14.4 p90 15.8 mm, Phi med 0.35 max 1.85 N s, in air  43 ms med, roll step toward med +0.61 p90 +2.19 deg
  the ratchet (each foot's landing against its liftoff, over the floor as the planted feet show it): dy mean +13.41 mm per swing -> +188 mm over the run (+13.41 mm per cycle, averaged over the four feet); dx +2.04 mm per swing -> +29 mm.  A real drift that is NOT here moved the planted feet: slip.  Roll at landing minus at liftoff: mean +1.16 deg
      FL: dy +11.87 mm/swing (levelled, before the trunk's motion +10.26), roll at lo +1.87 at td +2.99
      FR: dy +12.37 mm/swing (levelled, before the trunk's motion +10.28), roll at lo +1.37 at td +2.58
      RL: dy +15.21 mm/swing (levelled, before the trunk's motion +13.12), roll at lo +1.37 at td +2.58
      RR: dy +14.18 mm/swing (levelled, before the trunk's motion +12.56), roll at lo +1.87 at td +2.99
  stance width front 127.8 -> 124.0 mm (slope -18.42 mm/min), rear 128.8 -> 122.3 (-53.15 mm/min)
  foot offset from the HOLD site, y (mm, start -> end): FL -4.7->+6.2, FR +2.2->+16.7, RL -1.9->+3.5, RR -0.8->+10.6;  x: FL +4.2->+1.8, FR +1.6->-1.8, RL -0.2->-1.6, RR -7.9->-8.0
  e_R cycle mean (deg) roll -1.02 -> -3.16 (slope -21.587 deg/min), pitch +0.47 -> +0.57;  commanded moment mean x -0.338 y +0.187 N m (slope x -4.1268 N m/min)
  two-foot phases 28 (154 ms median).  Moment about the support line, per phase: commanded |median| 0.229 N m, delivered |median| 0.196, and the weight's own toppling moment W d |median| 0.191 -- delivered minus toppling median -0.391 (two feet can make no other).  Roll excursion over a phase median +0.28 deg, |peak| median 0.60
  torque per amp by joint, first fifth -> last fifth of the trot (abd/pitch/knee): FL nan>0.72/0.89>0.85/0.95>0.86  FR nan>0.95/0.90>0.83/0.98>0.97  RL 0.66>0.74/0.90>0.82/0.95>0.92  RR nan>0.97/0.94>0.95/0.92>0.87
  load left / right, first fifth -> last fifth: 22.9 / 26.4 -> 17.1 / 33.6 N
  fz mean per leg (N): FL 10.5 FR 13.9 RL 11.0 RR 14.6;  left 21.5 right 28.5;  f_w y mean per leg (N): +0.08 +0.03 +0.14 +0.06
  estimator: p_est drift x -1.3 y +82.4 mm over the trot; v_est mean x -10.8 y +11.8 mm/s; x/y rows on 100 % of sweeps; their mean force x +0.28 y +0.37 N; commanded moment mean x -0.444 y +0.221 z -0.030 N m
  torque per amp, |meas|/|cmd| on planted legs by joint (abd pitch knee): FL 0.80/0.88/0.95  FR 0.94/0.87/0.98  RL 0.77/0.88/0.93  RR 0.90/0.94/0.90
  peak |tau_cmd| 5.58 N m; slew deficit 0.038 N m s; sweeps at the 9 N m clip 0
