snowyfoams/dog6/doc/swing_leg/fig/one_leg.pdf

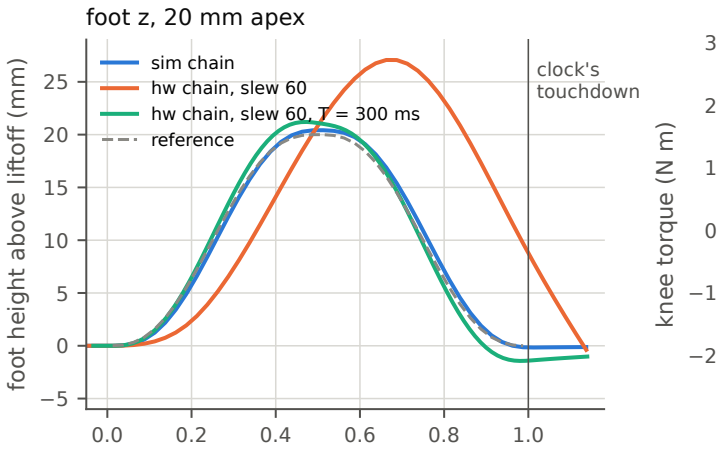
[picture p21: figure]
foot height above liftoff (mm); clock's touchdown; foot z, 20 mm apex; sim chain hw chain, slew 60 hw chain, slew 60, T = 300 ms reference; knee torque (N m)
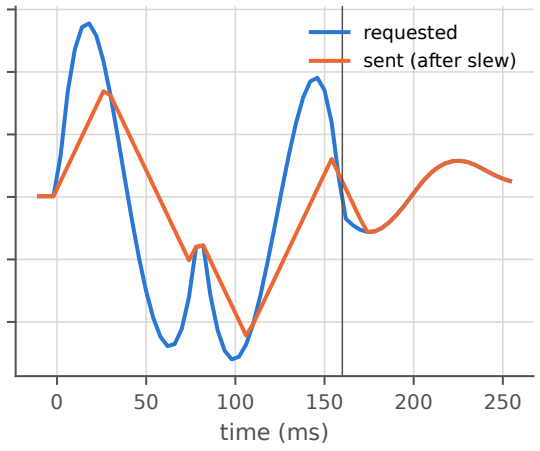
[picture p22: figure]
time (ms); requested sent (after slew)

swing progress s = t/T (no floor in the model) hw chain, 160 ms / 20 mm, slew 60
