snowyfoams/dog6/doc/gait_study/runs/figs/p1_inplace_1/full/p1_inplace_1_4_cycles.png

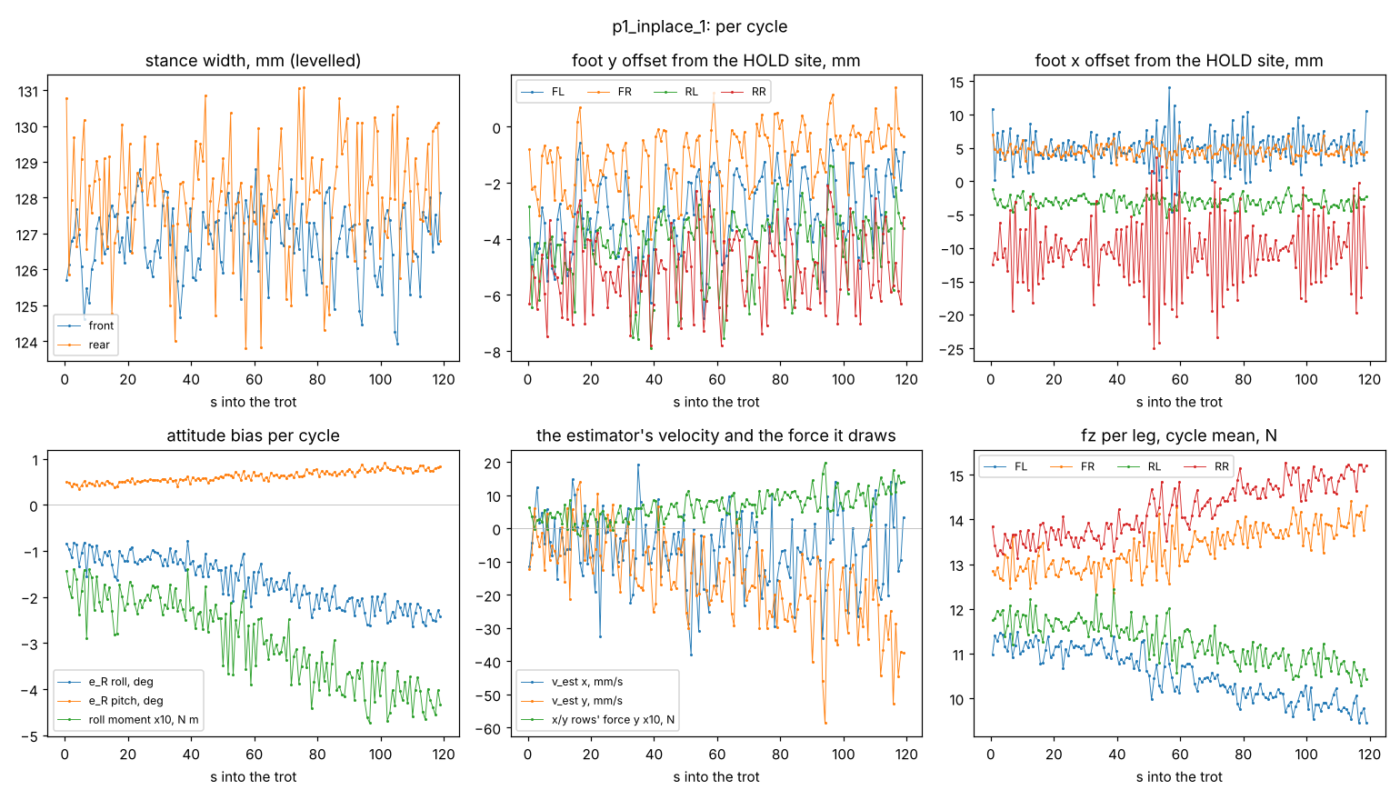
doc/gait_study/runs/figs/p1_inplace_1/full/p1_inplace_1_4_cycles.png
