snowyfoams/dog6/doc/gait_study/runs/figs/p1_inplace_1/full/p1_inplace_1_10_height_one_axis.png

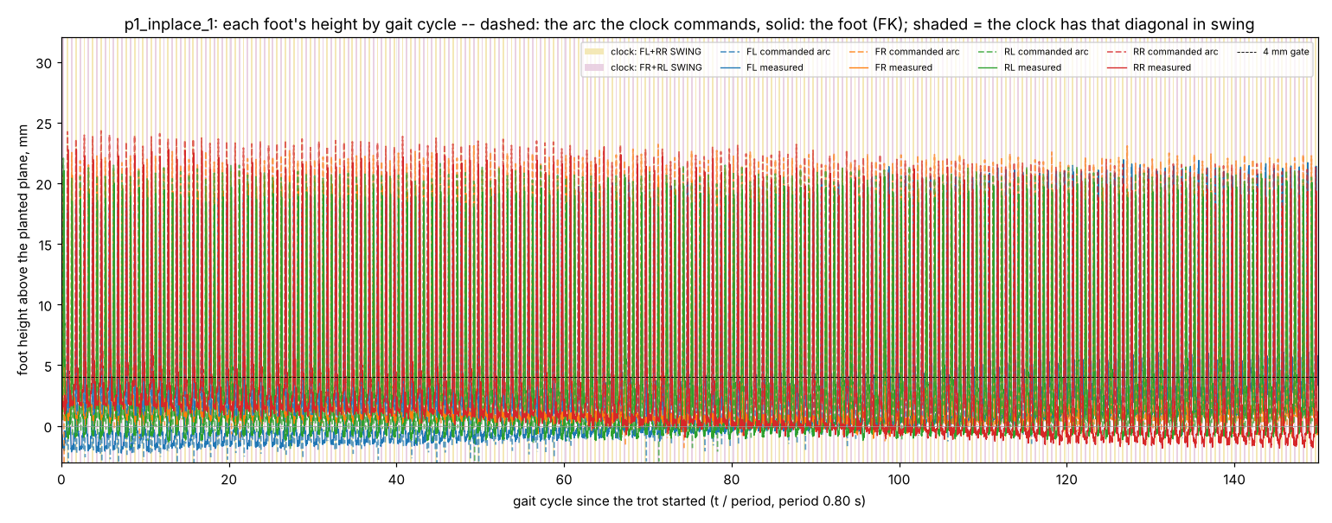
doc/gait_study/runs/figs/p1_inplace_1/full/p1_inplace_1_10_height_one_axis.png
