snowyfoams/dog6/doc/gait_study/runs/figs/p1_inplace_1/full/p1_inplace_1_19_residual_by_gait.png

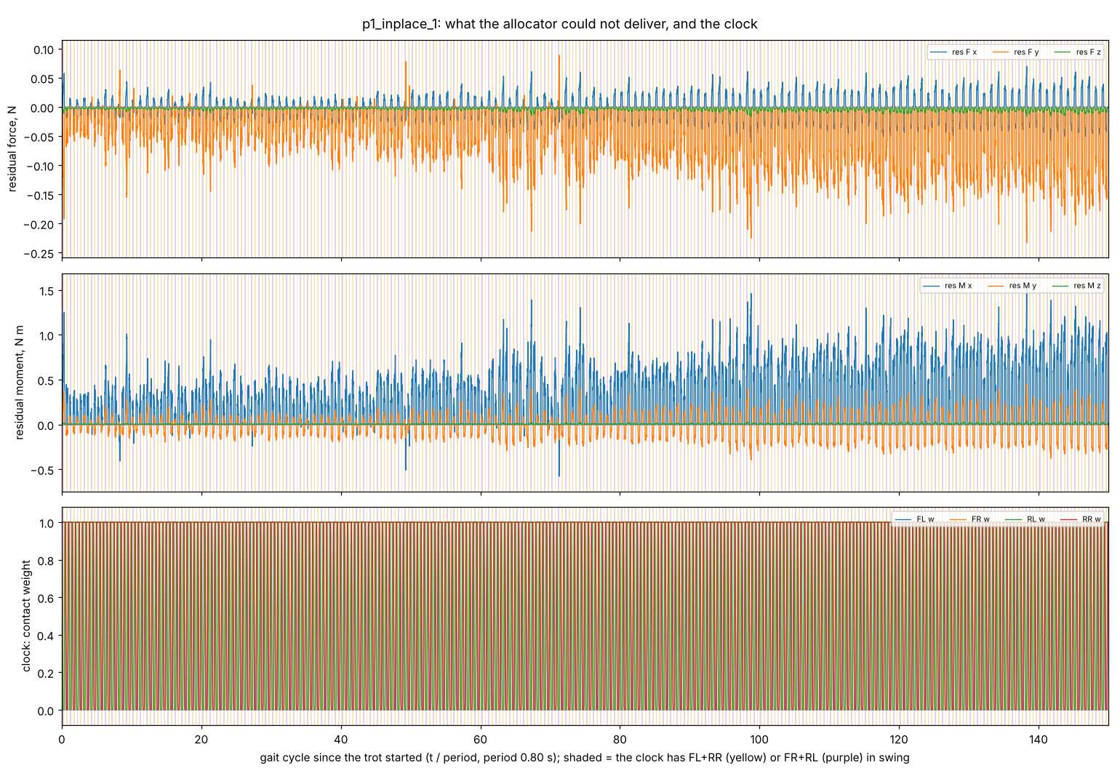
doc/gait_study/runs/figs/p1_inplace_1/full/p1_inplace_1_19_residual_by_gait.png
