snowyfoams/dog6/doc/gait_study/runs/figs/p1_inplace_1/zoom/p1_inplace_1_15_torque_by_gait.png

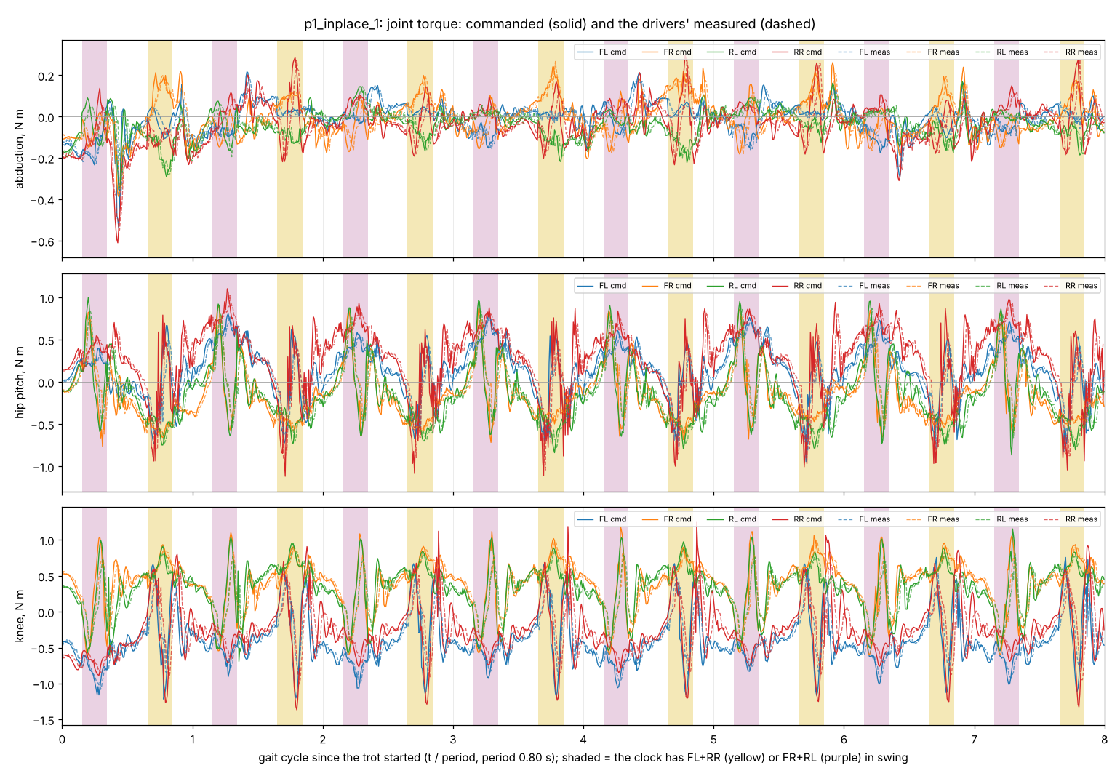
doc/gait_study/runs/figs/p1_inplace_1/zoom/p1_inplace_1_15_torque_by_gait.png
