snowyfoams/dog6/doc/gait_study/runs/figs/p1_lat_1/full/p1_lat_1_2_anatomy.png

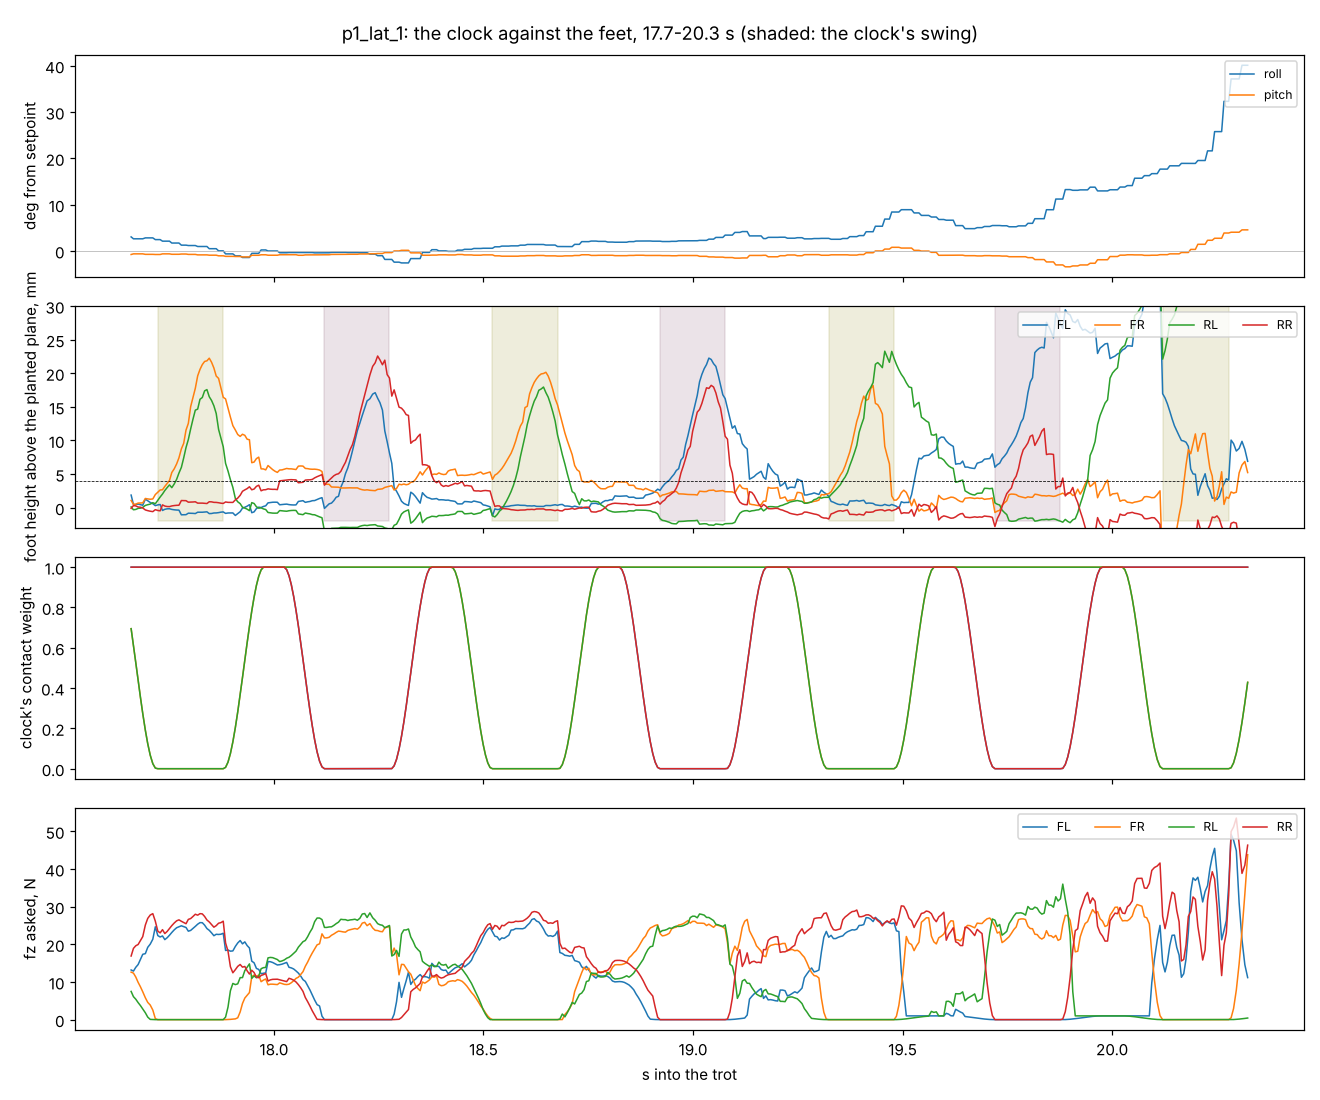
doc/gait_study/runs/figs/p1_lat_1/full/p1_lat_1_2_anatomy.png
