snowyfoams/dog6/doc/gait_study/runs/figs/p1_lat_1/zoom/p1_lat_1_1_overview.png

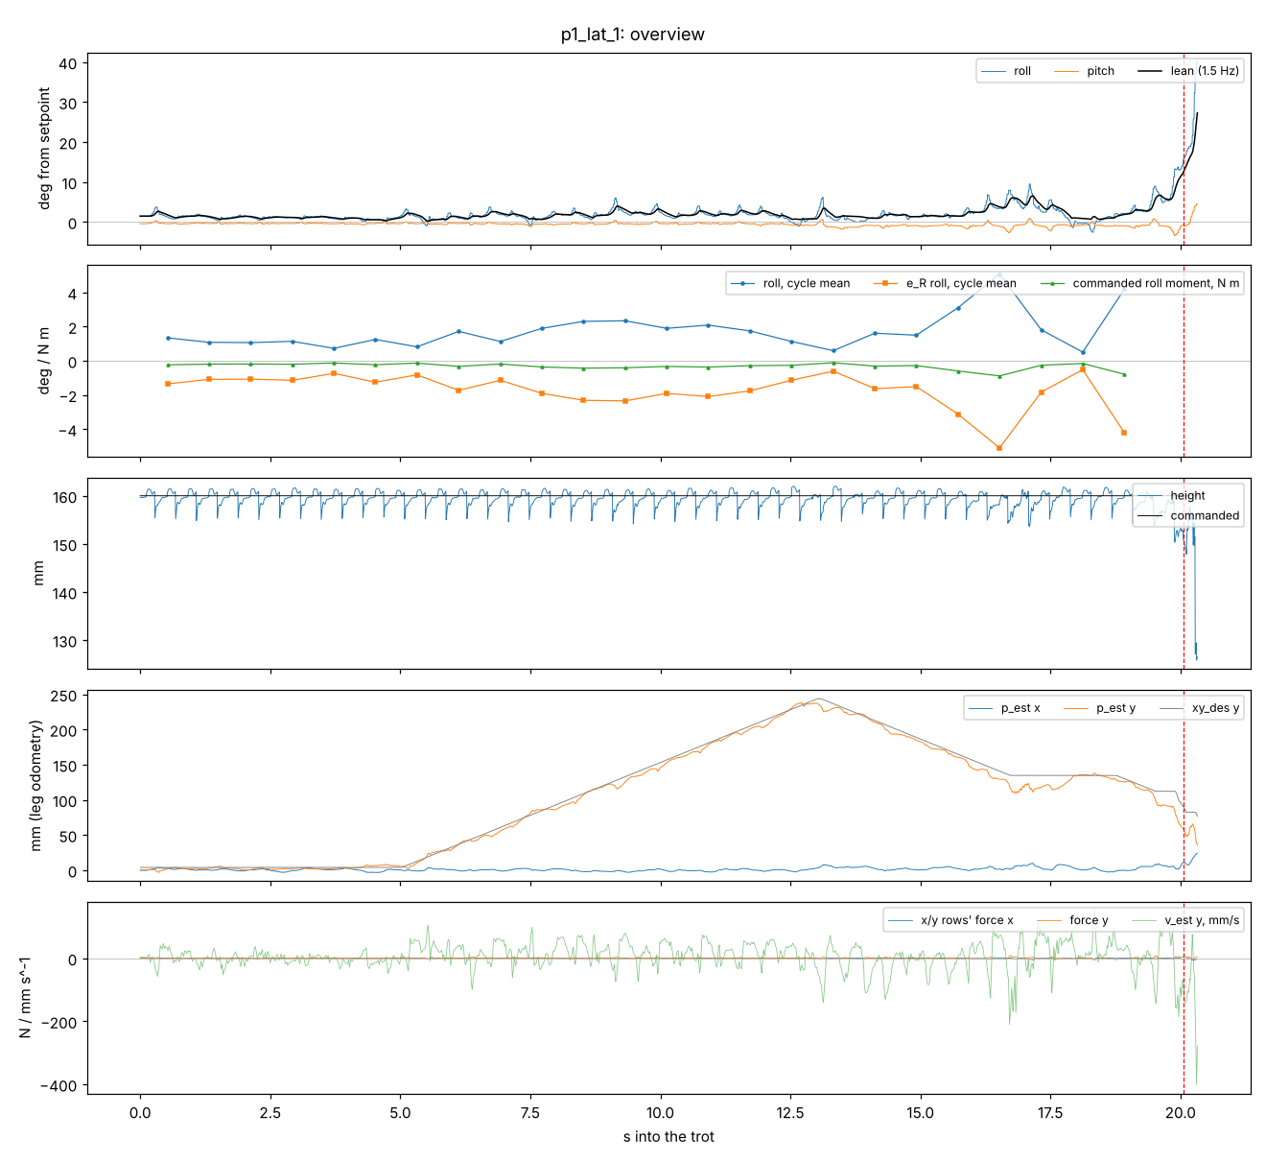
doc/gait_study/runs/figs/p1_lat_1/zoom/p1_lat_1_1_overview.png
