snowyfoams/dog6/doc/gait_study/runs/figs/p1_lat_1/zoom/p1_lat_1_14_attitude_error_by_gait.png

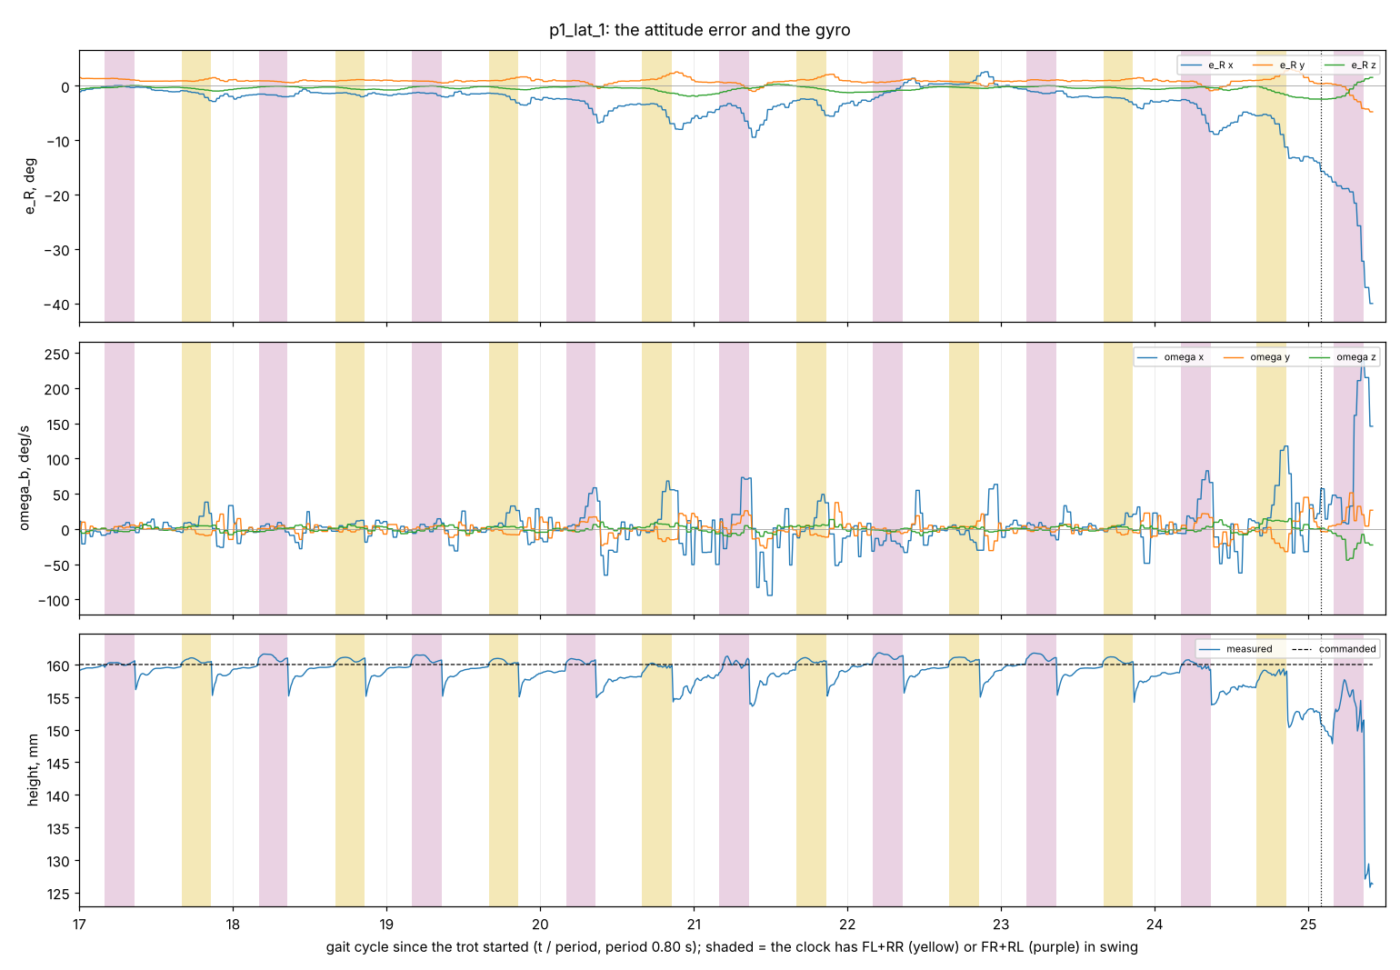
doc/gait_study/runs/figs/p1_lat_1/zoom/p1_lat_1_14_attitude_error_by_gait.png
