snowyfoams/dog6/doc/gait_study/runs/figs/p1_lat_1/zoom/p1_lat_1_16_feet_xy_by_gait.png

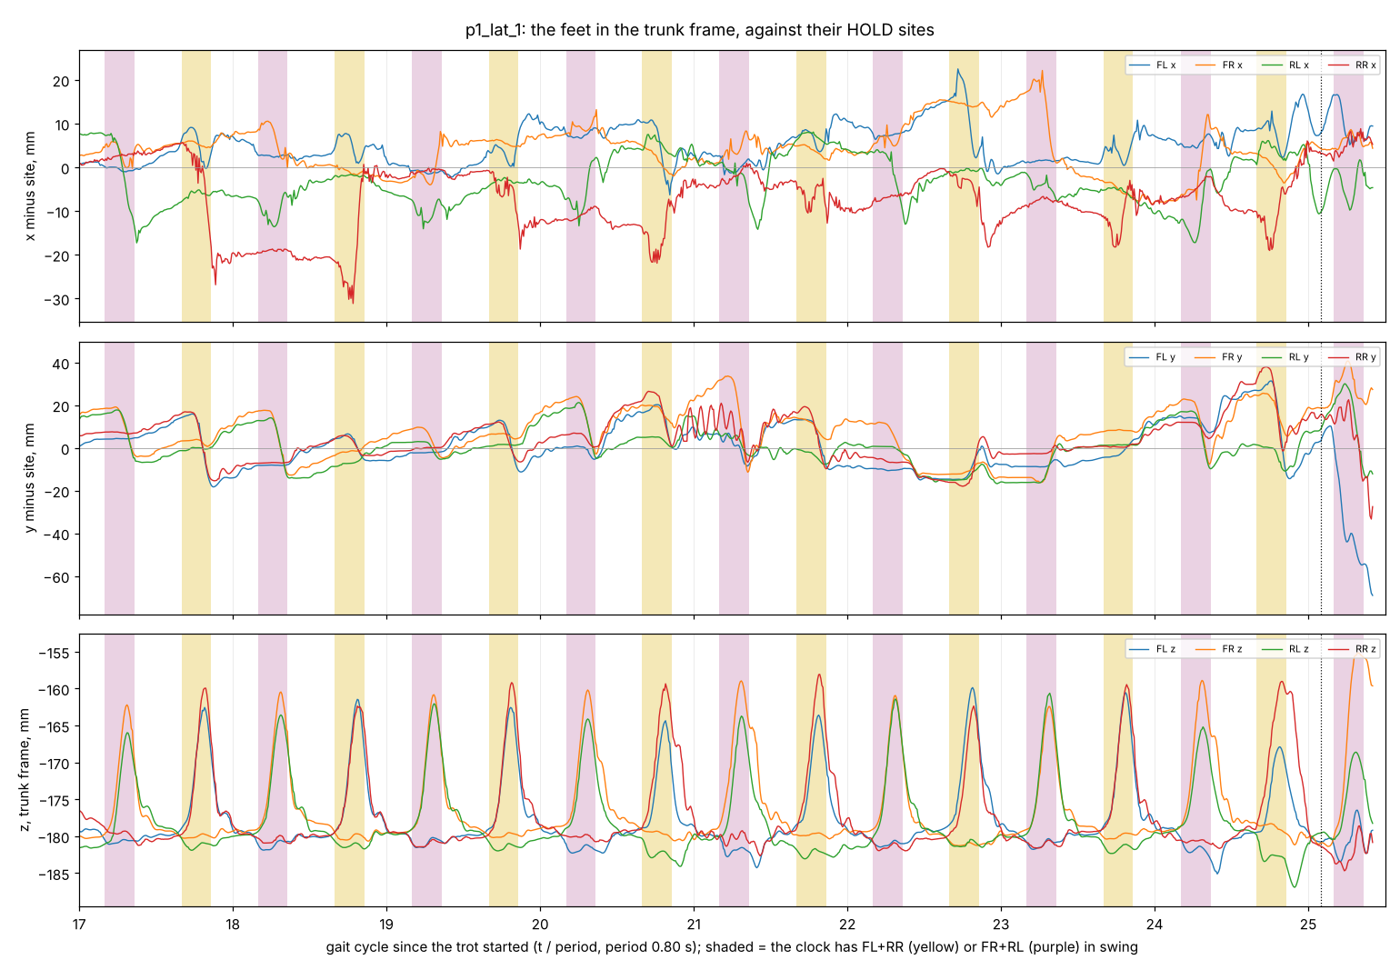
doc/gait_study/runs/figs/p1_lat_1/zoom/p1_lat_1_16_feet_xy_by_gait.png
