snowyfoams/dog6/doc/gait_study/runs/figs/p1_lat_2/full/p1_lat_2_3_swings.png

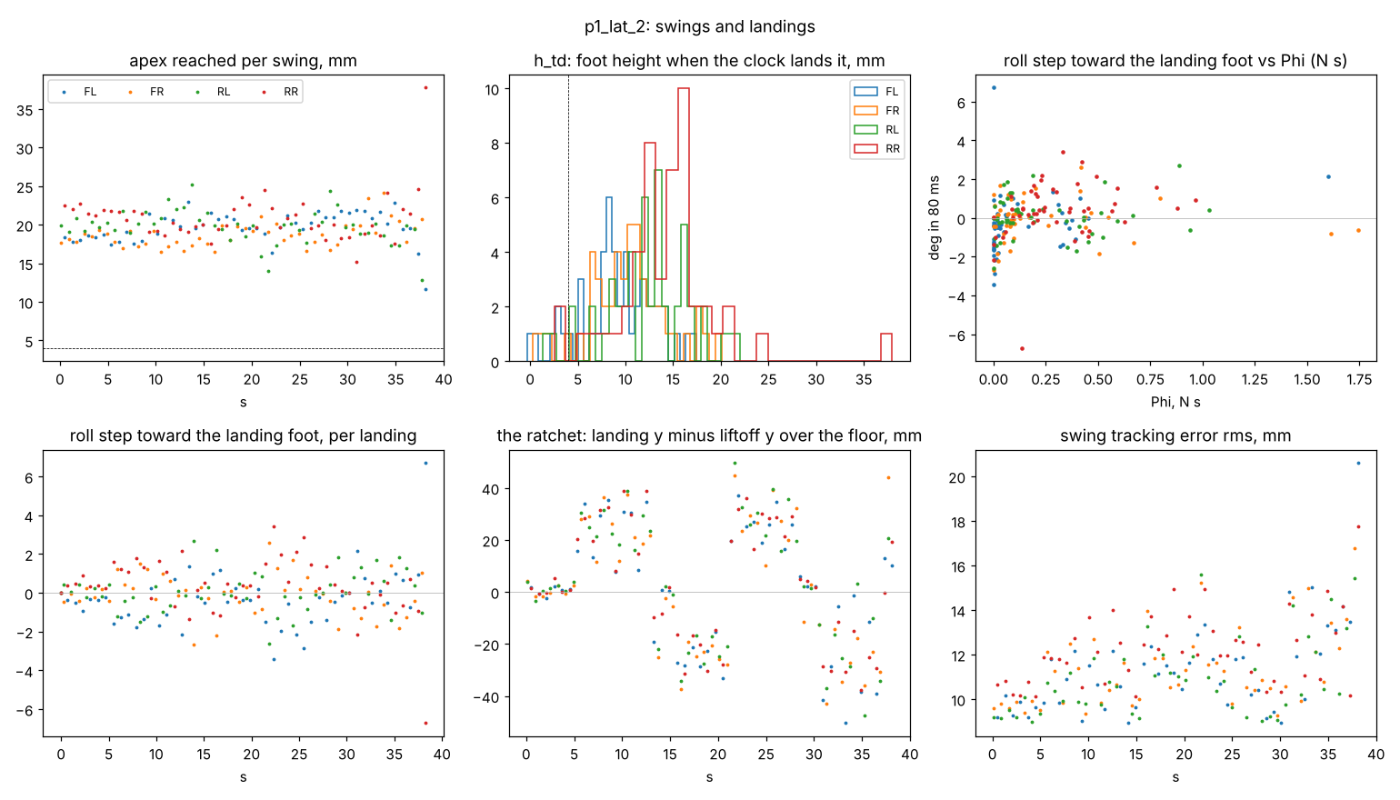
doc/gait_study/runs/figs/p1_lat_2/full/p1_lat_2_3_swings.png
