snowyfoams/dog6/doc/gait_study/runs/figs/p1_lat_2/full/p1_lat_2_9_height_by_gait.png

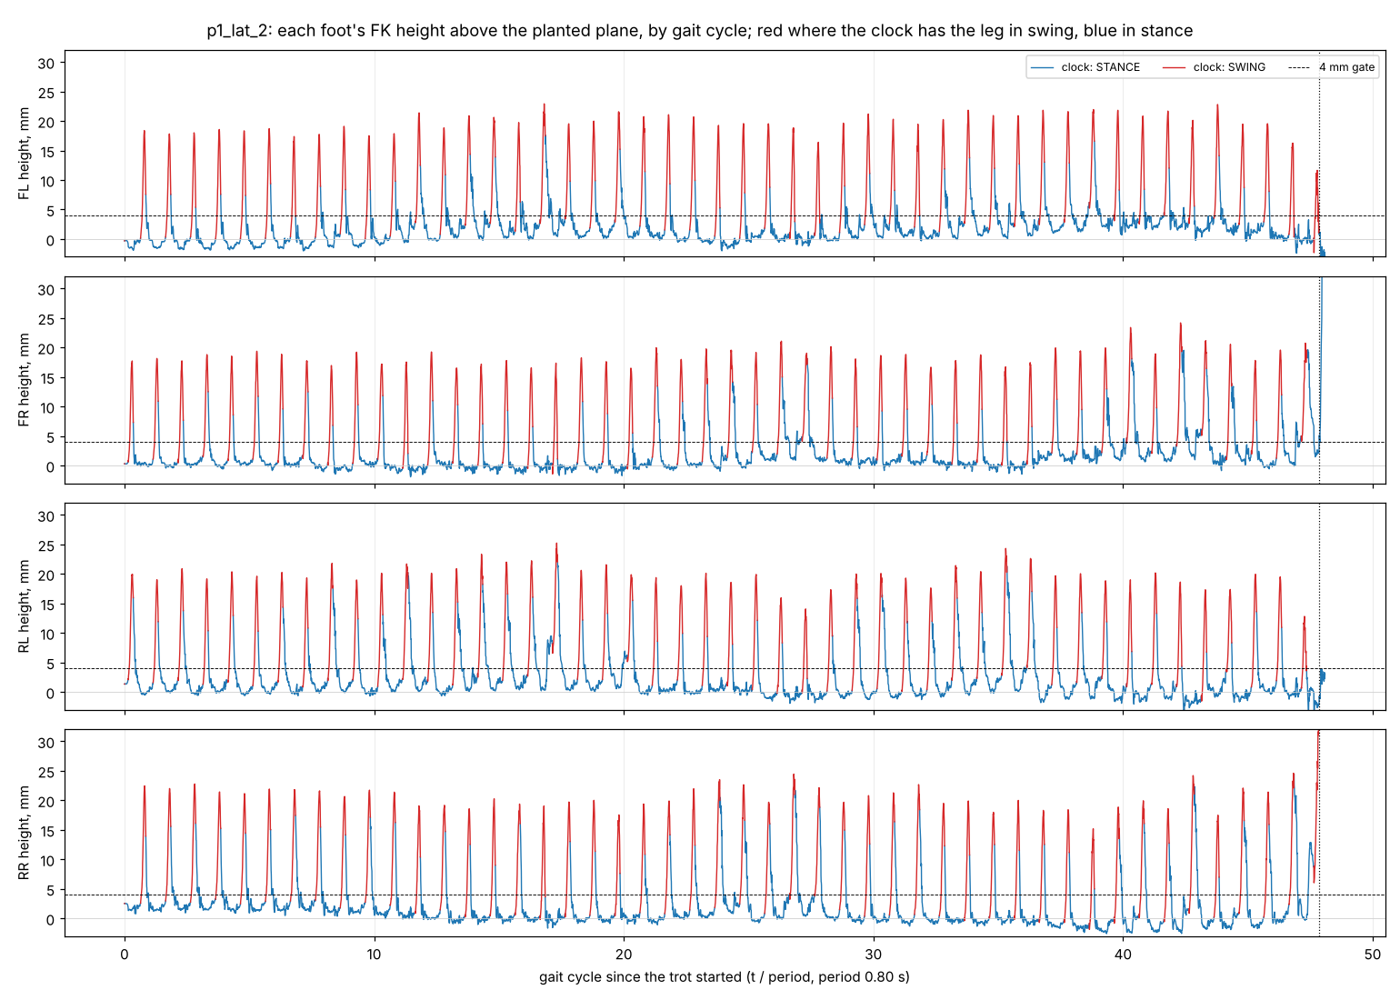
doc/gait_study/runs/figs/p1_lat_2/full/p1_lat_2_9_height_by_gait.png
