snowyfoams/dog6/doc/gait_study/runs/figs/p1_lat_2/zoom/p1_lat_2_4_cycles.png

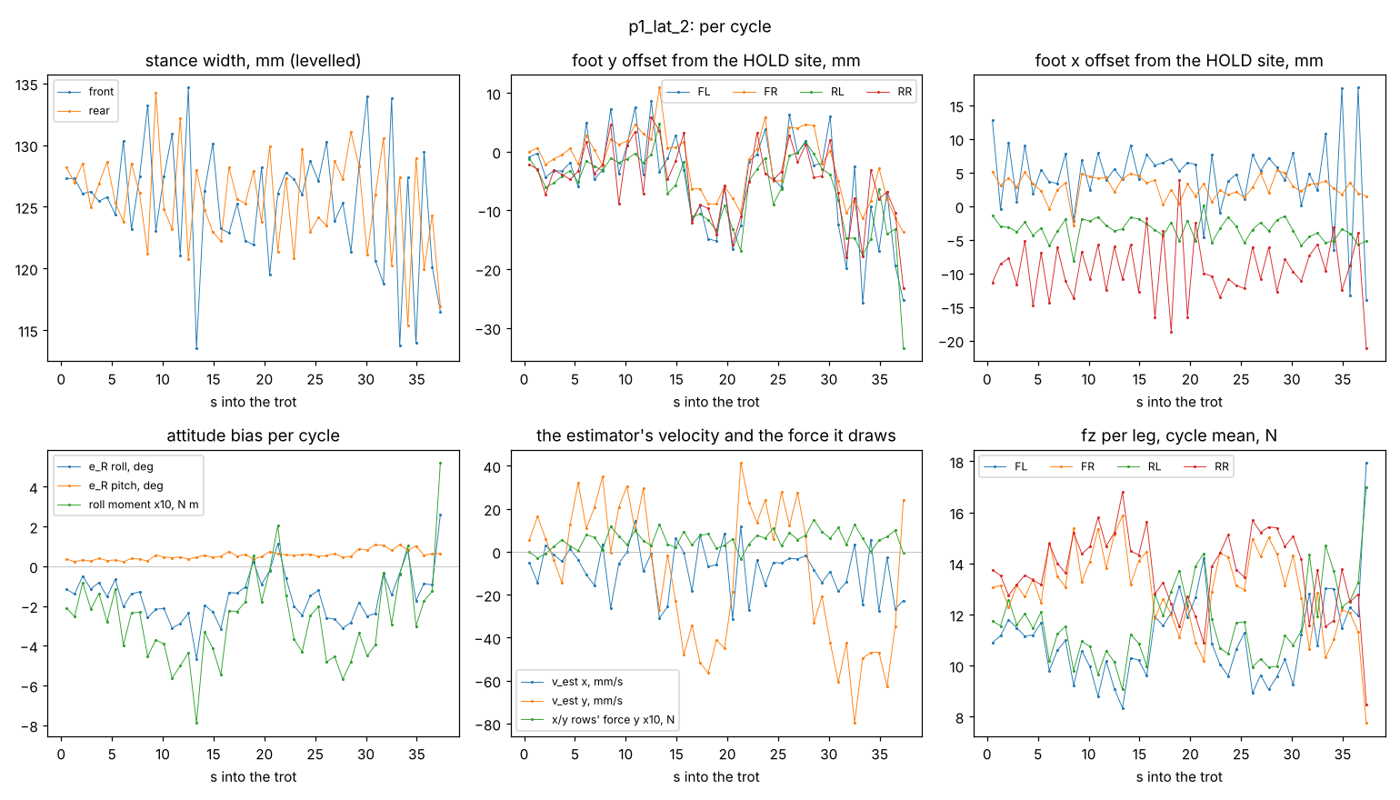
doc/gait_study/runs/figs/p1_lat_2/zoom/p1_lat_2_4_cycles.png
