snowyfoams/dog6/doc/gait_study/runs/figs/p1_lat_2/zoom/p1_lat_2_7_htd_per_cycle.png

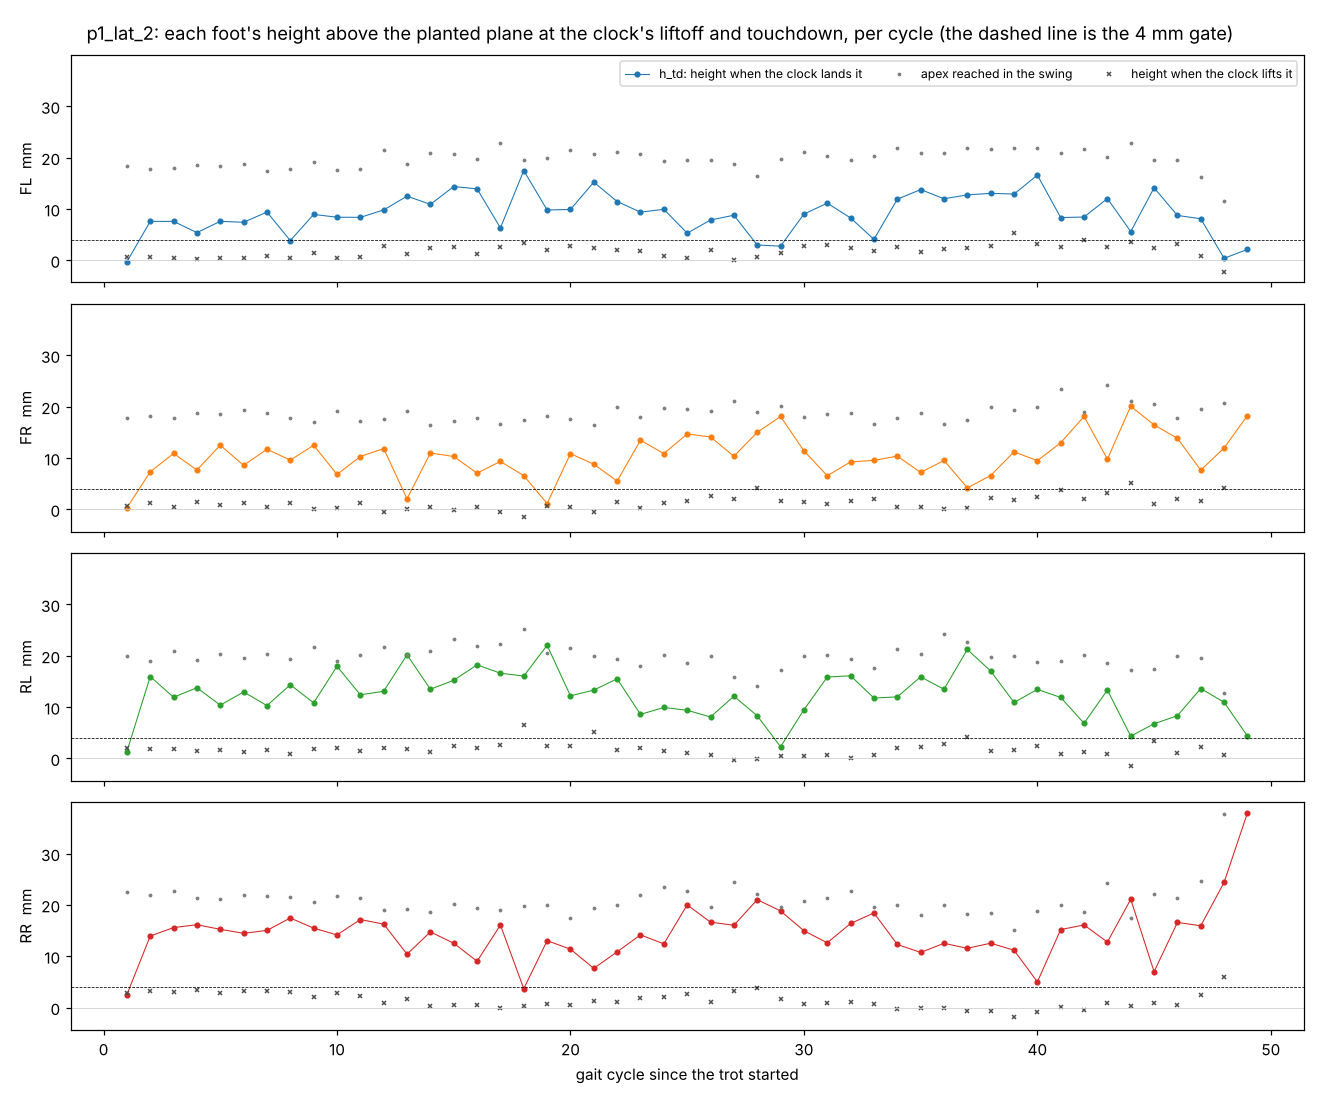
doc/gait_study/runs/figs/p1_lat_2/zoom/p1_lat_2_7_htd_per_cycle.png
