snowyfoams/dog6/doc/gait_study/runs/figs/p1_lat_2/zoom/p1_lat_2_10_height_one_axis.png

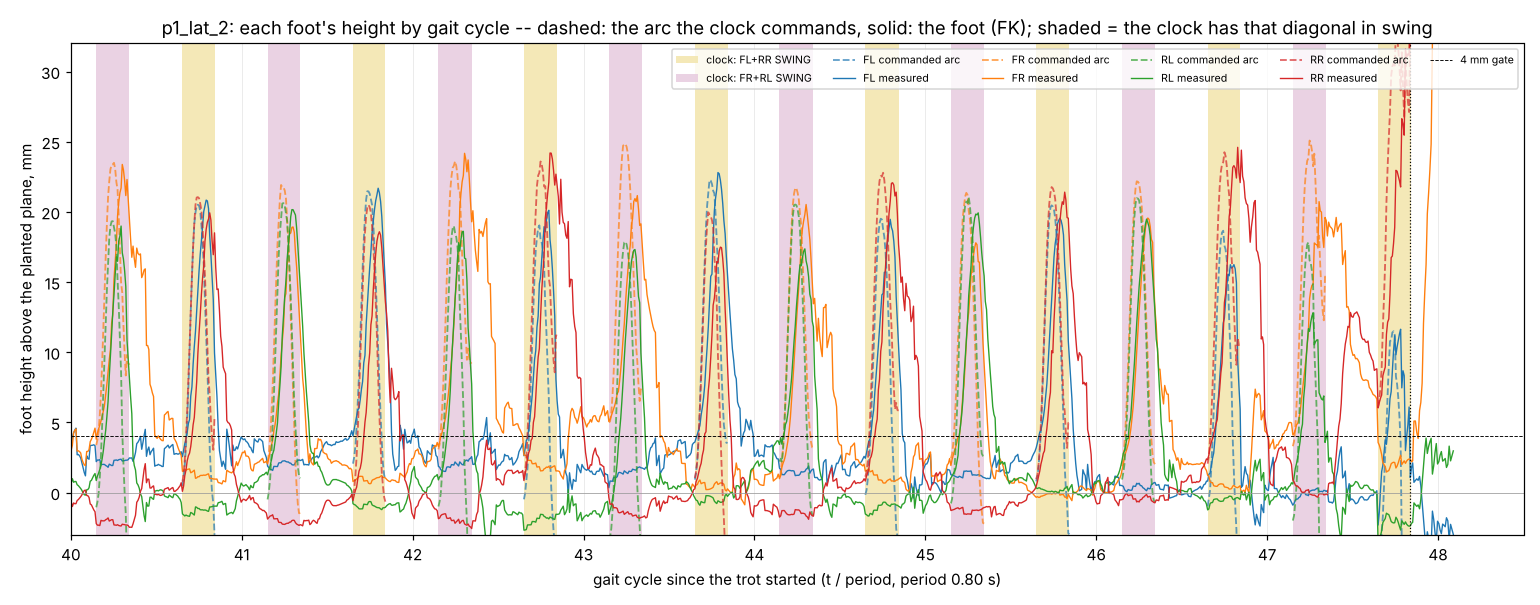
doc/gait_study/runs/figs/p1_lat_2/zoom/p1_lat_2_10_height_one_axis.png
