snowyfoams/dog6/doc/gait_study/runs/figs/p1_lat_3/full/p1_lat_3_4_cycles.png

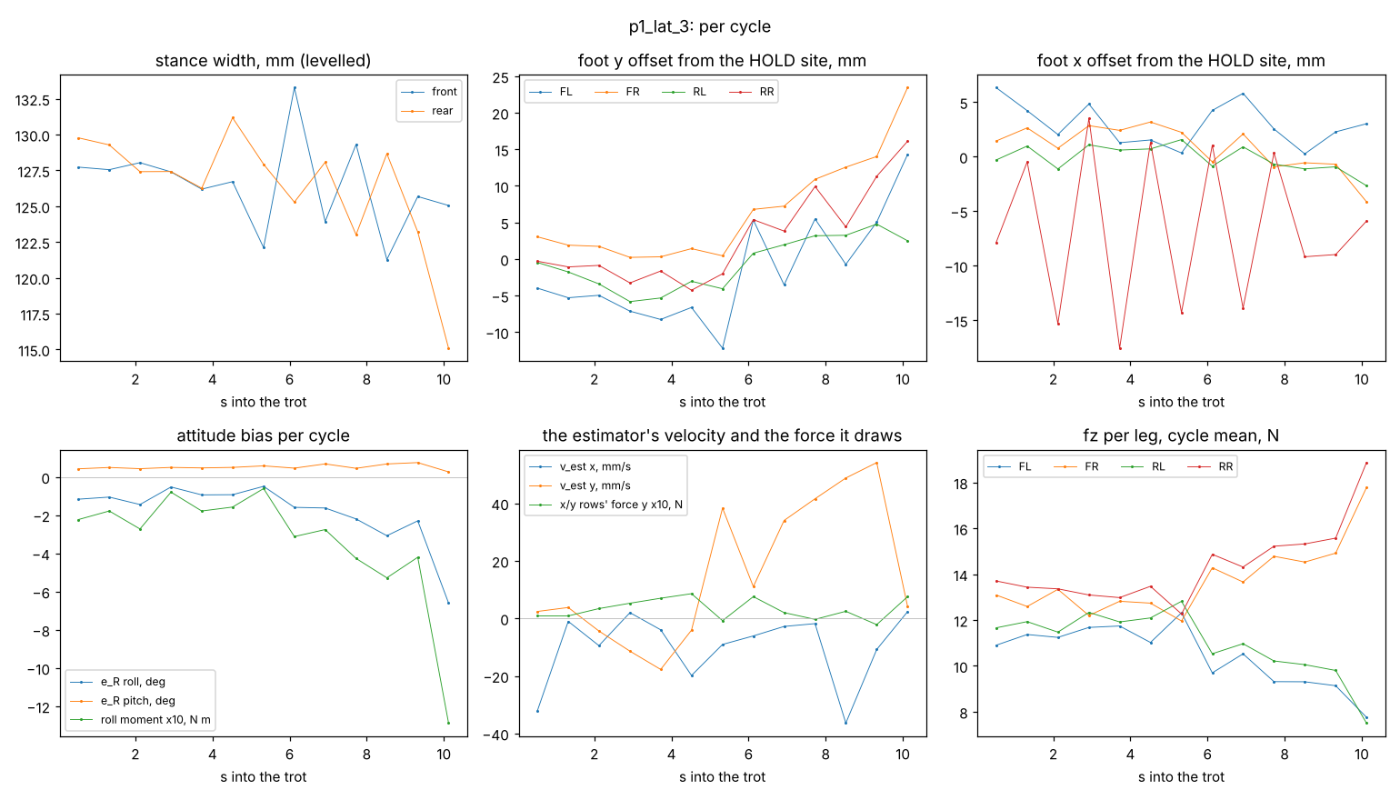
doc/gait_study/runs/figs/p1_lat_3/full/p1_lat_3_4_cycles.png
