snowyfoams/dog6/doc/gait_study/runs/figs/p1_lat_3/full/p1_lat_3_7_htd_per_cycle.png

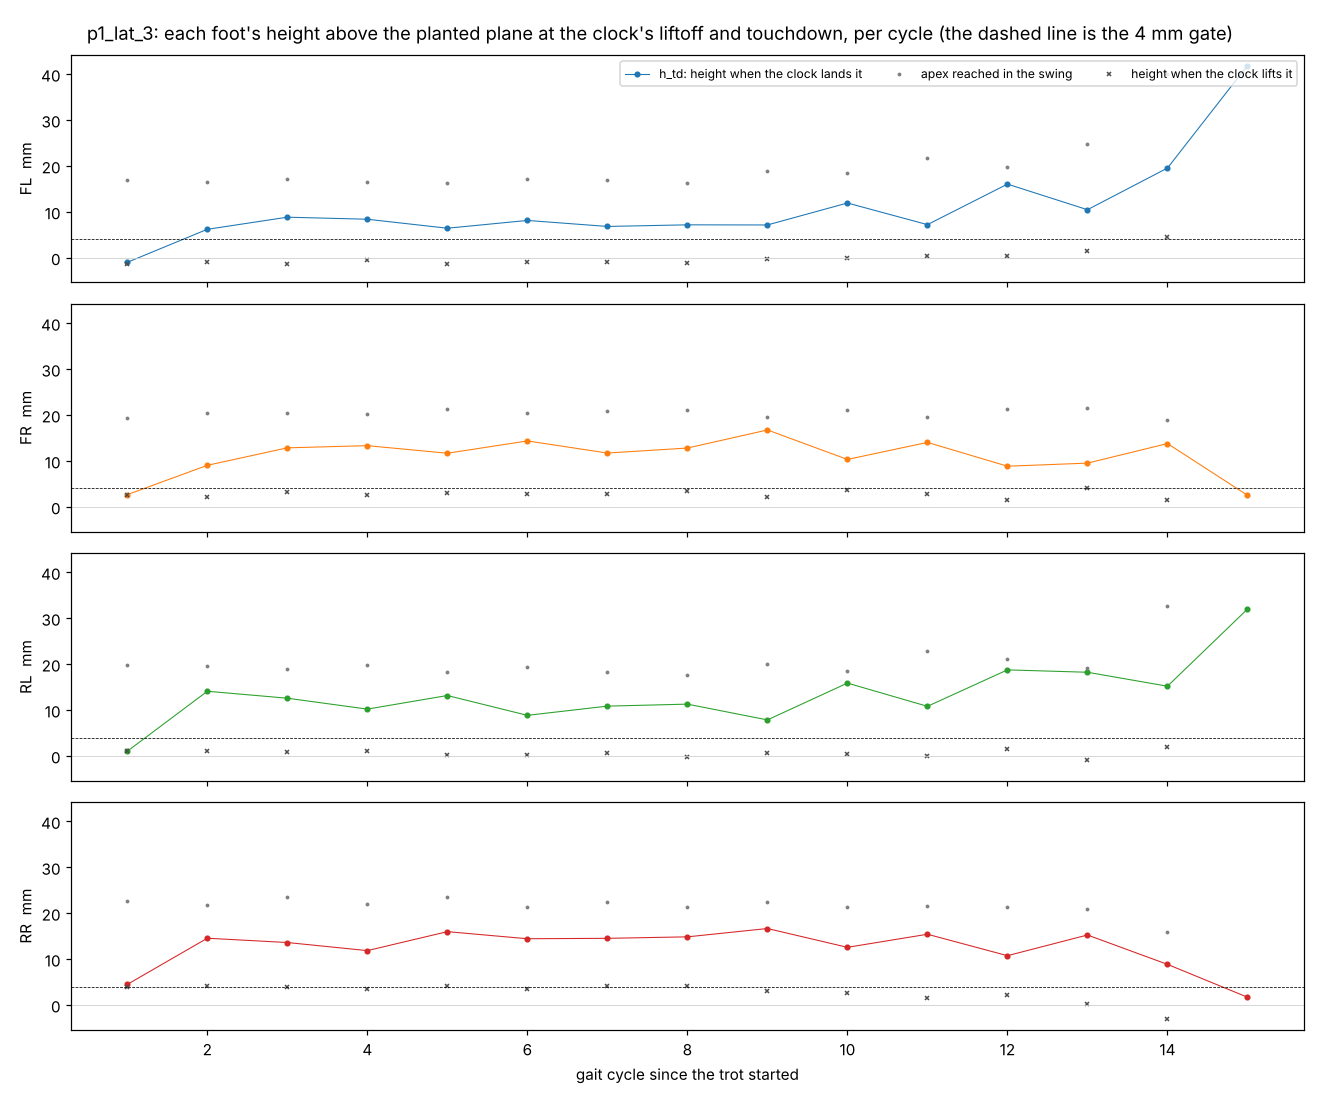
doc/gait_study/runs/figs/p1_lat_3/full/p1_lat_3_7_htd_per_cycle.png
