snowyfoams/dog6/doc/gait_study/runs/figs/p1_lat_3/full/p1_lat_3_10_height_one_axis.png

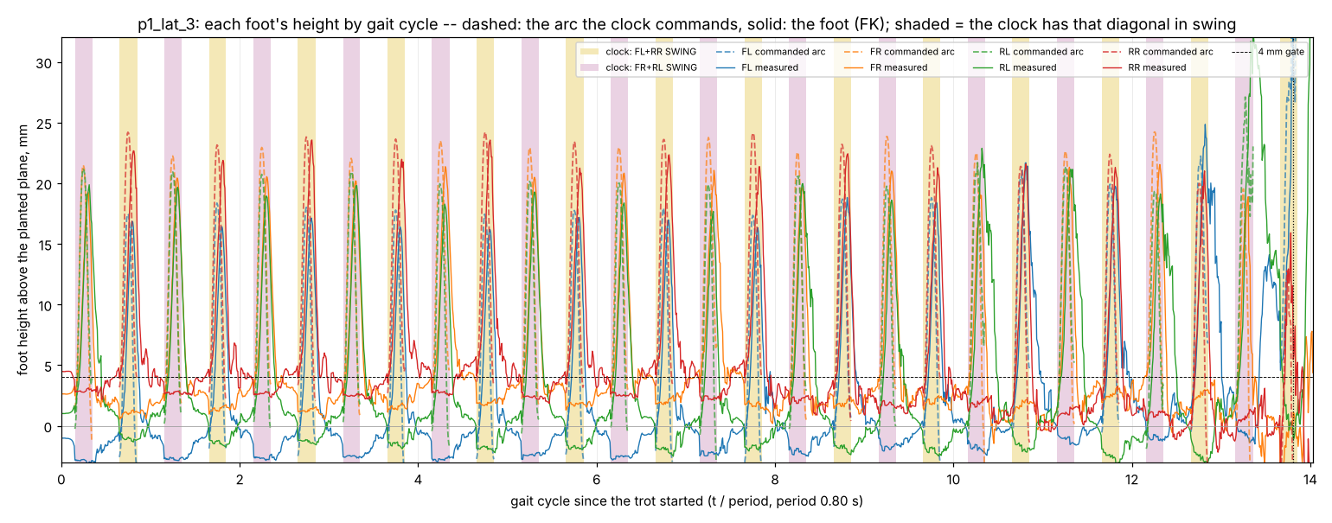
doc/gait_study/runs/figs/p1_lat_3/full/p1_lat_3_10_height_one_axis.png
