snowyfoams/dog6/doc/gait_study/runs/figs/p1_lat_3/full/p1_lat_3_14_attitude_error_by_gait.png

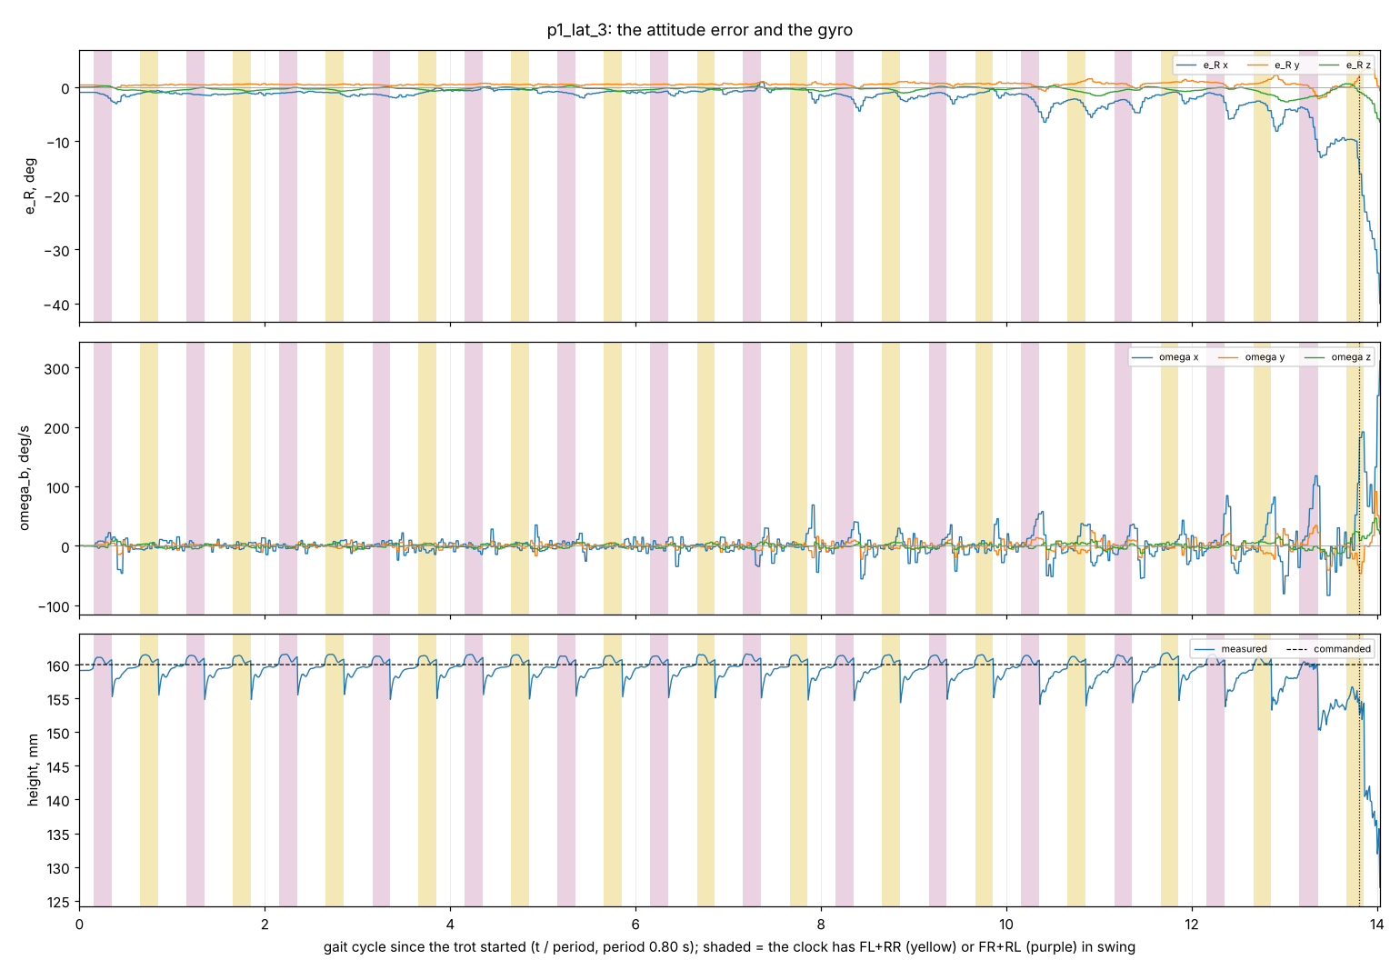
doc/gait_study/runs/figs/p1_lat_3/full/p1_lat_3_14_attitude_error_by_gait.png
