snowyfoams/dog6/doc/gait_study/runs/figs/p1_lat_3/full/p1_lat_3_20_torque_knee_vs_request_by_gait.png

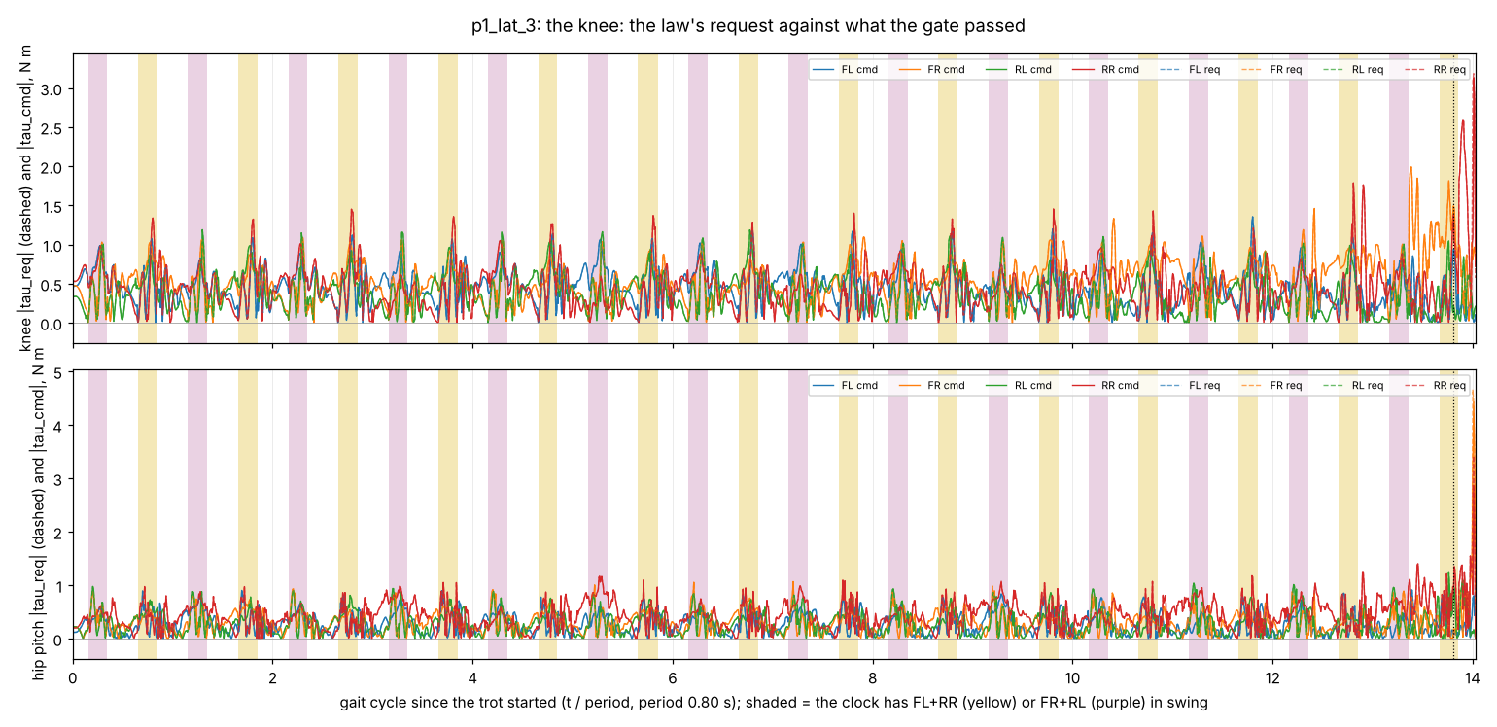
doc/gait_study/runs/figs/p1_lat_3/full/p1_lat_3_20_torque_knee_vs_request_by_gait.png
