snowyfoams/dog6/doc/gait_study/runs/figs/p1_lat_3/zoom/p1_lat_3_2_anatomy.png

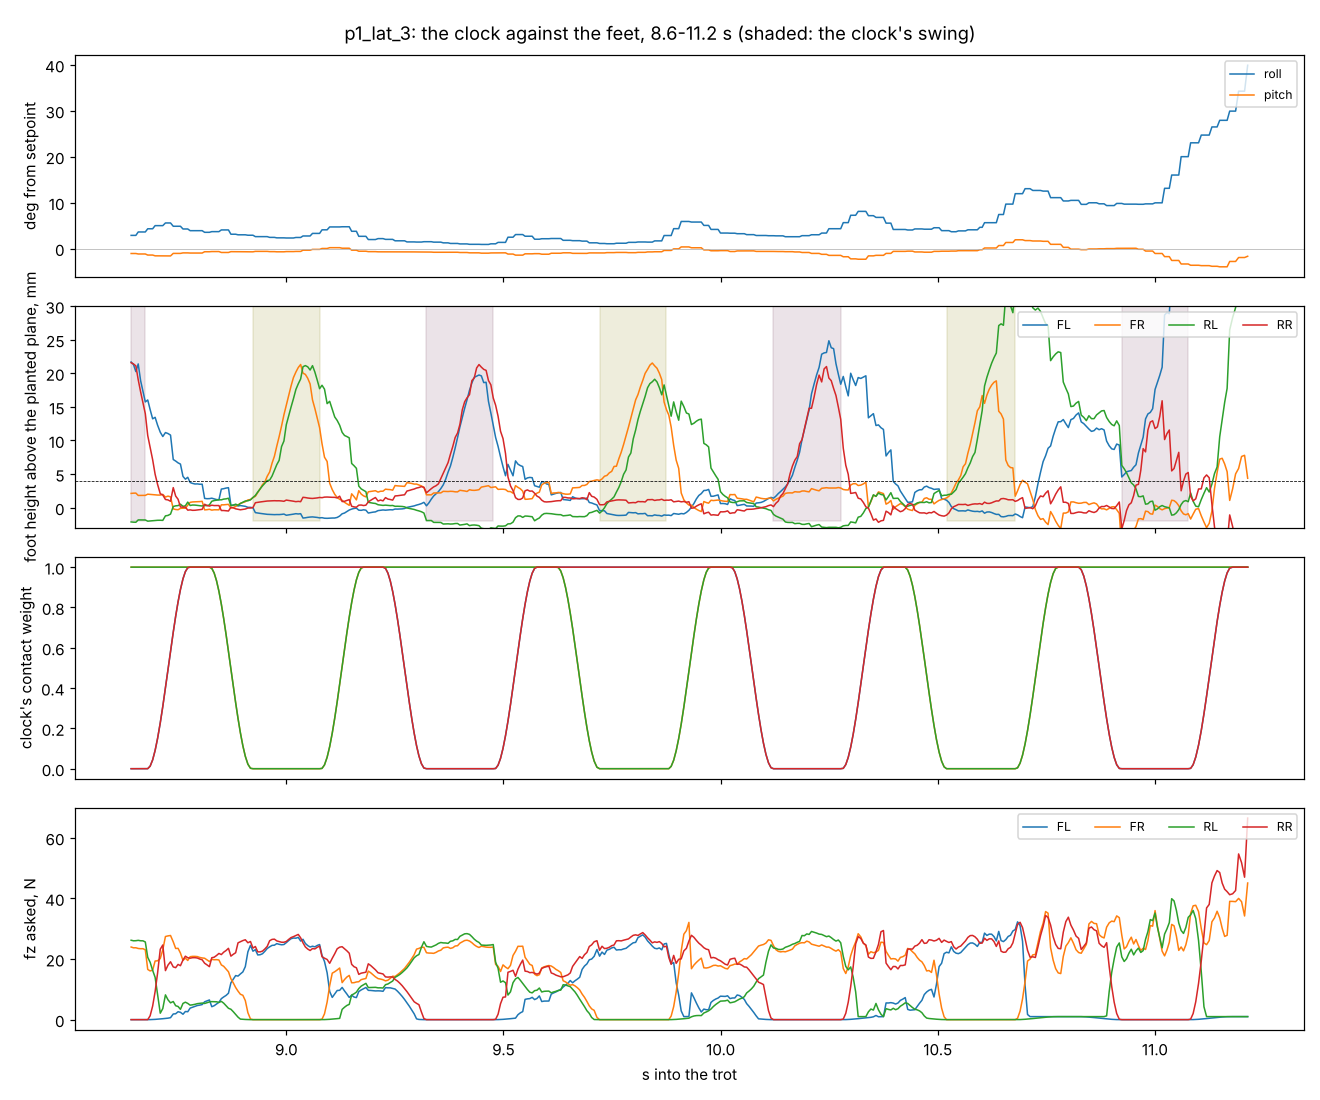
doc/gait_study/runs/figs/p1_lat_3/zoom/p1_lat_3_2_anatomy.png
