snowyfoams/dog6/doc/gait_study/runs/figs/p1_lat_3/zoom/p1_lat_3_3_swings.png

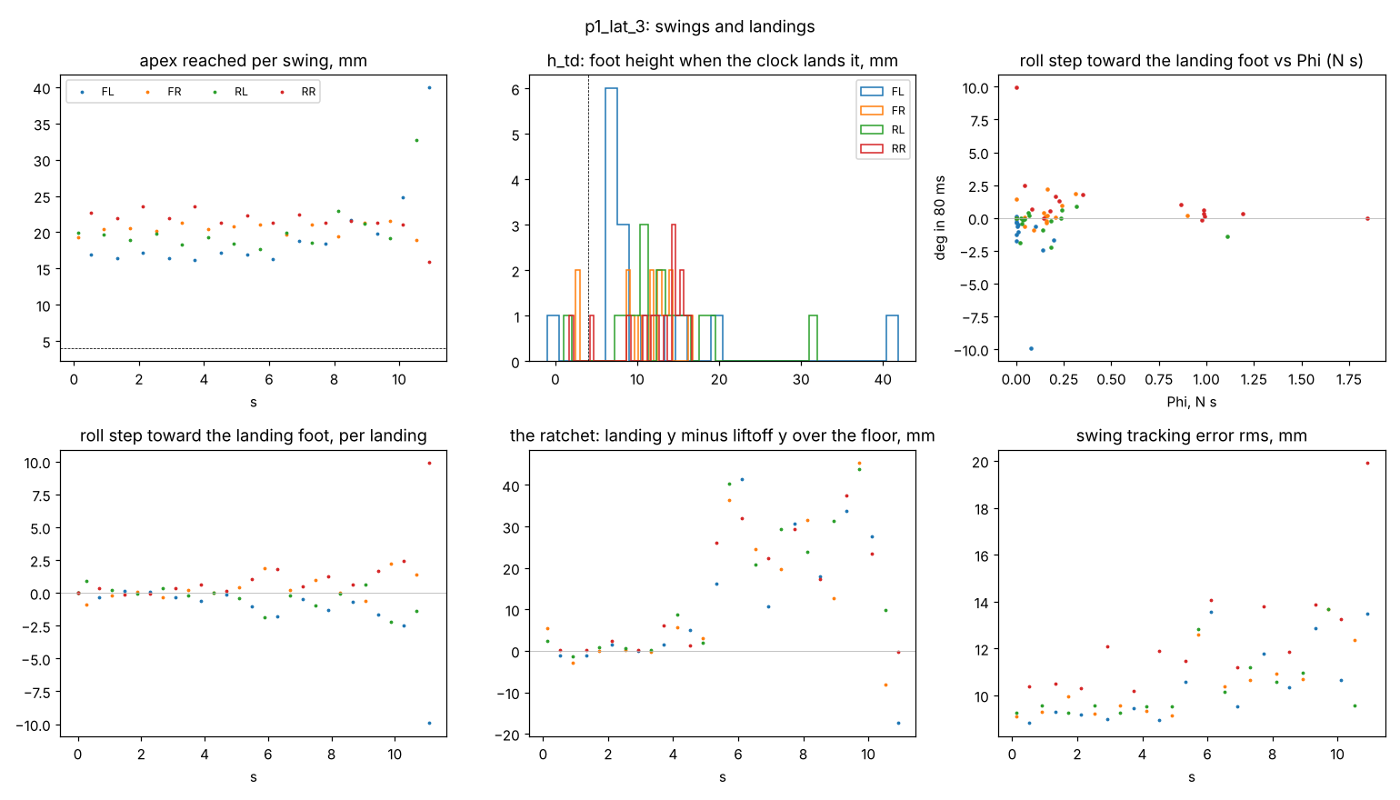
doc/gait_study/runs/figs/p1_lat_3/zoom/p1_lat_3_3_swings.png
