snowyfoams/dog6/doc/gait_study/runs/figs/p1_lat_3/zoom/p1_lat_3_15_torque_by_gait.png

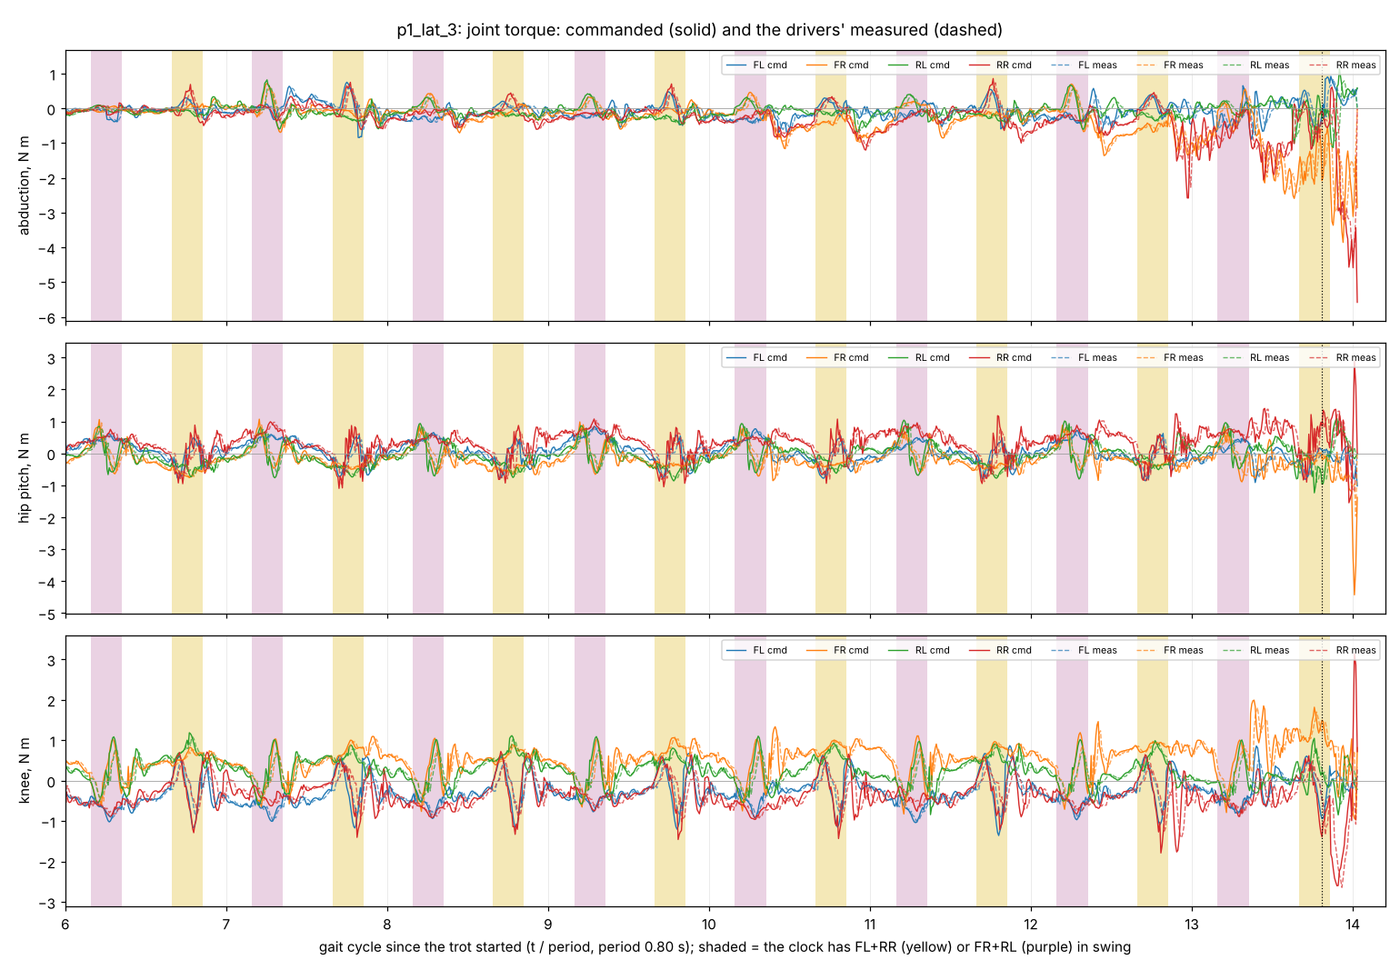
doc/gait_study/runs/figs/p1_lat_3/zoom/p1_lat_3_15_torque_by_gait.png
