snowyfoams/dog6/doc/swing_hw/fig/6_foot_path.png

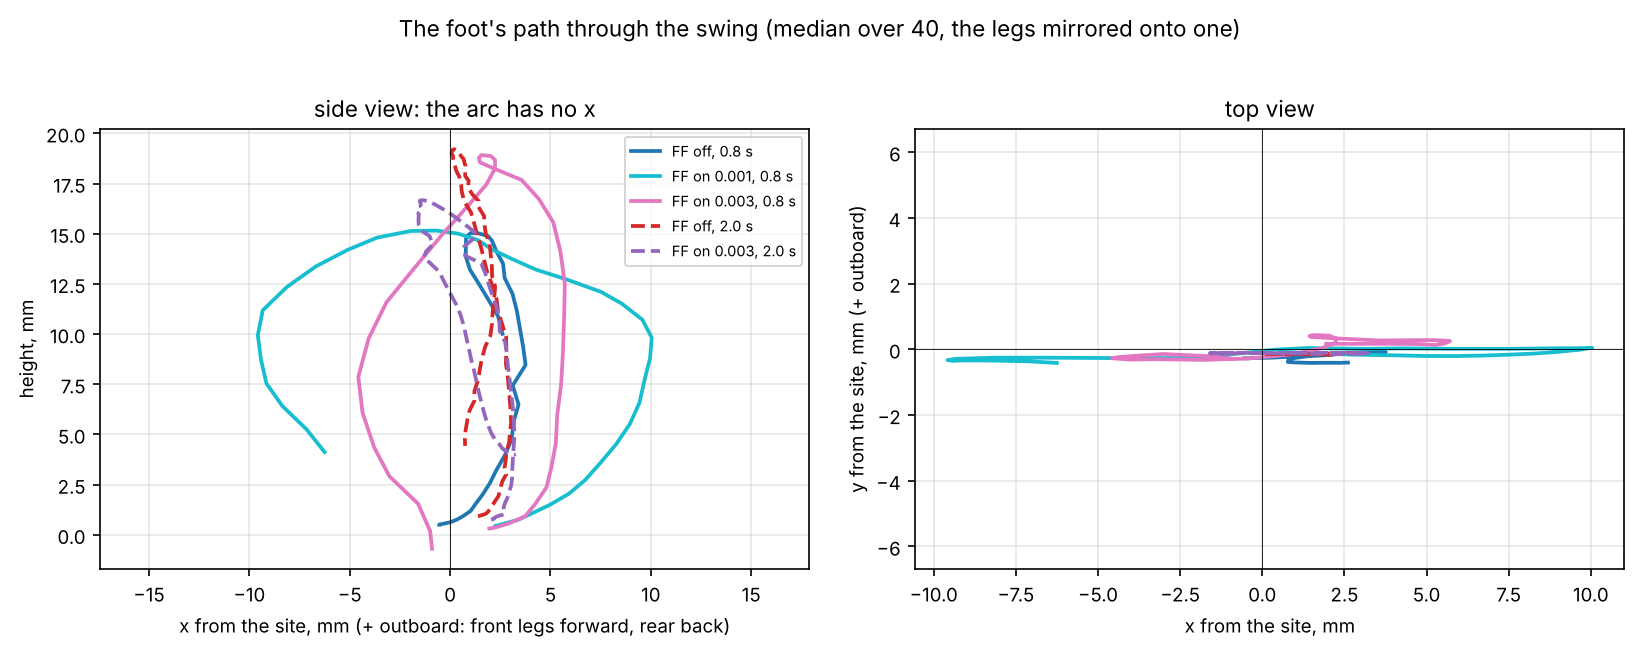
doc/swing_hw/fig/6_foot_path.png
