snowyfoams/dog6/doc/swing_hw/fig/12_gait_per_swing.png

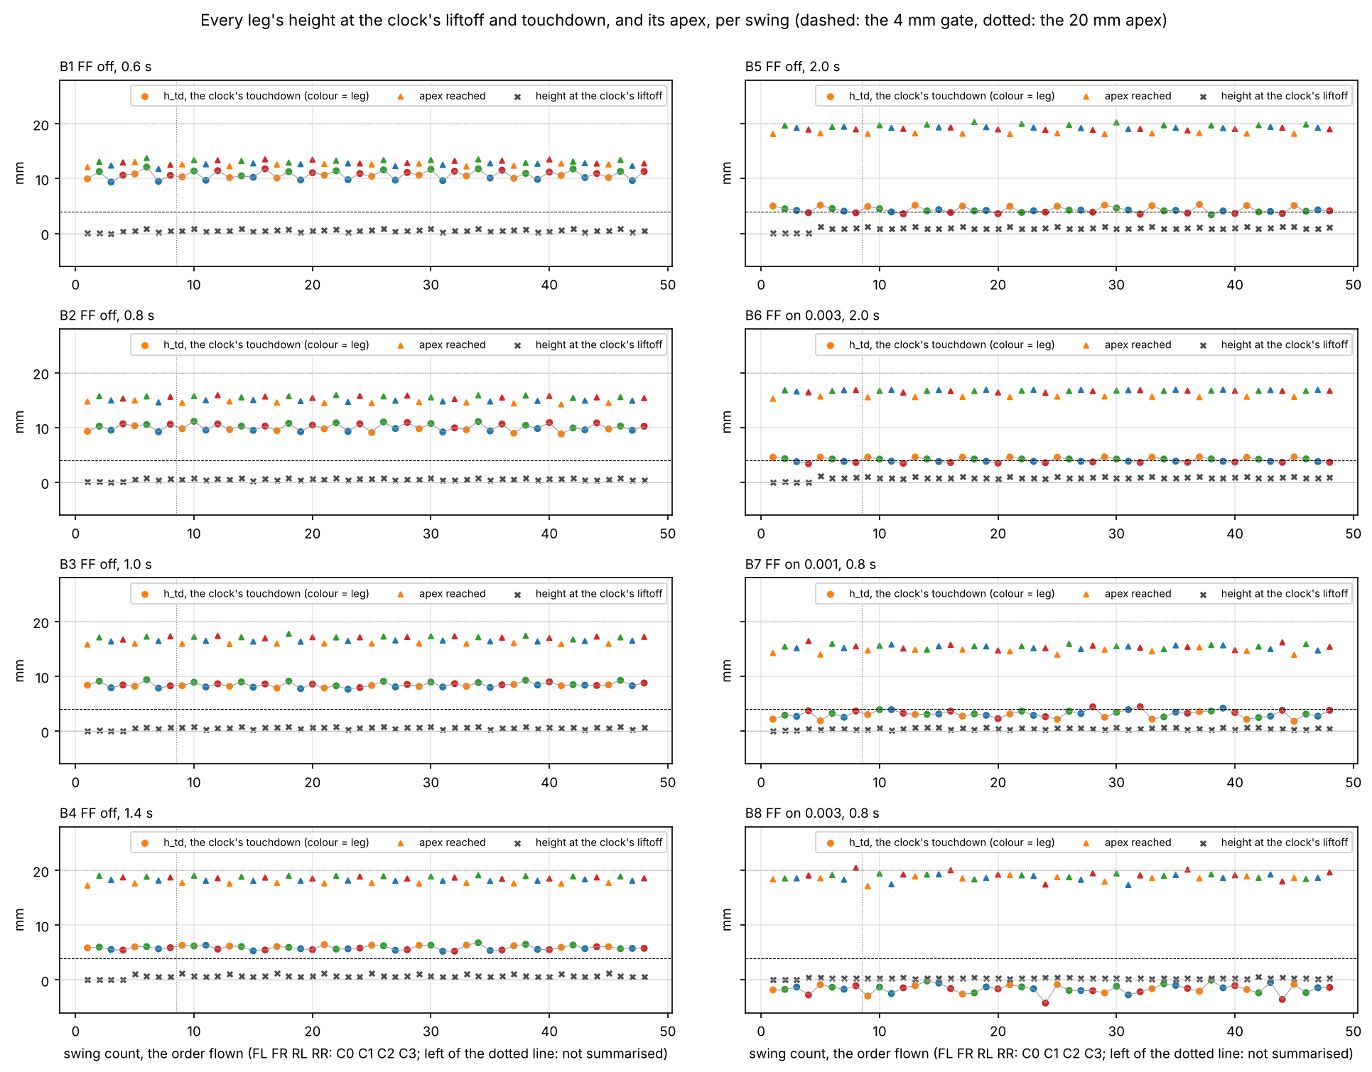
doc/swing_hw/fig/12_gait_per_swing.png
