snowyfoams/dog6/doc/trot_posture/fig/pose_WIDE_h160_crouch_side.jpg

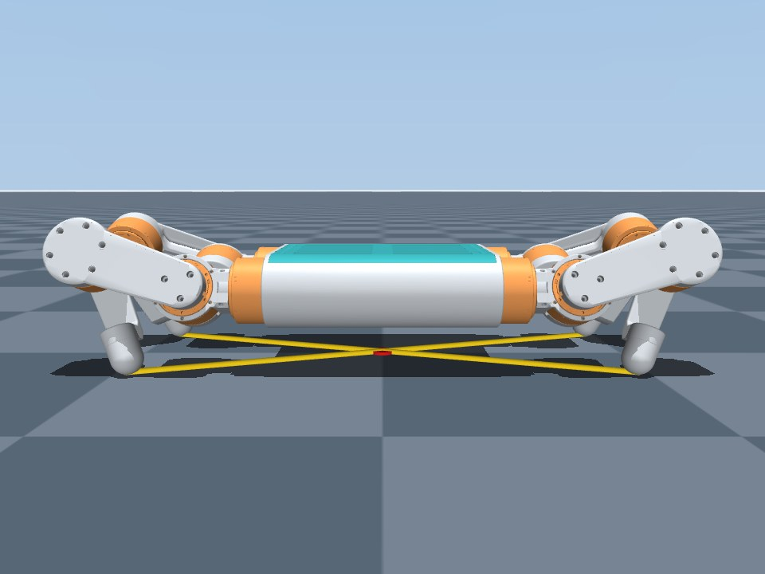
doc/trot_posture/fig/pose_WIDE_h160_crouch_side.jpg
