snowyfoams/dog6/sim/model/meshes/quadruped_link03_v2_MIR.stl

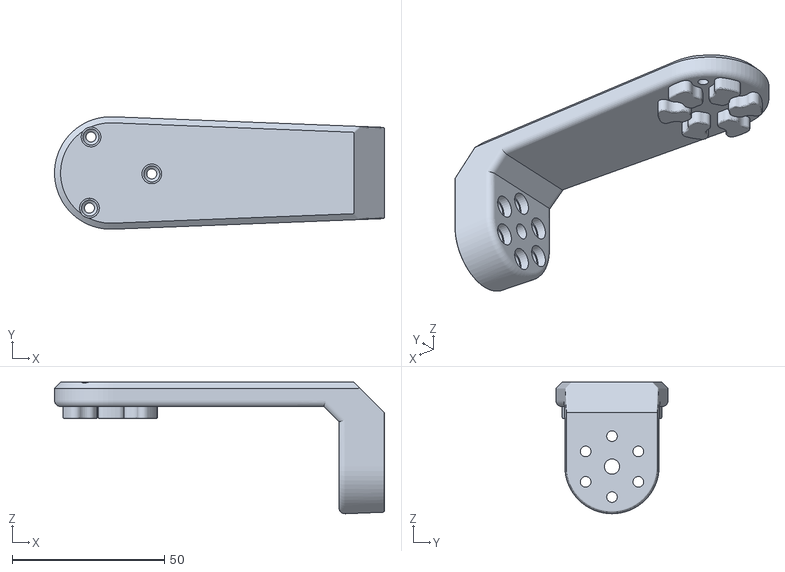
[picture p153: CAD file, 2026-09-15]
sim/model/meshes/quadruped_link03_v2_MIR.stl
108.5 x 37.0 x 43.3
