snowyfoams/dog6/sim/model/meshes/quadruped_foot_MIR_MIR.stl

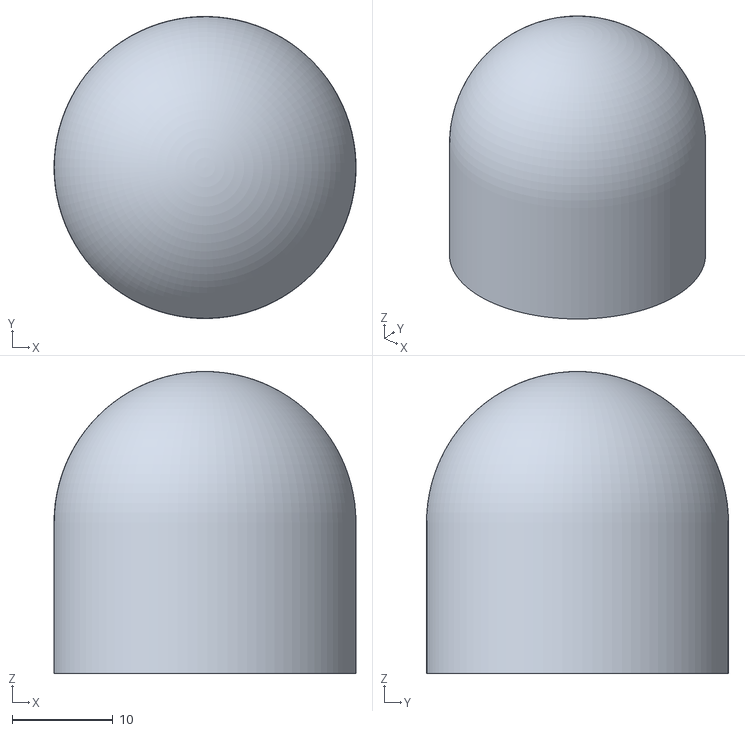
[picture p154: CAD file, 2026-09-15]
sim/model/meshes/quadruped_foot_MIR_MIR.stl
30.0 x 30.0 x 30.0
