snowyfoams/dog6/sim/model/meshes/quadruped_link01_v2.stl

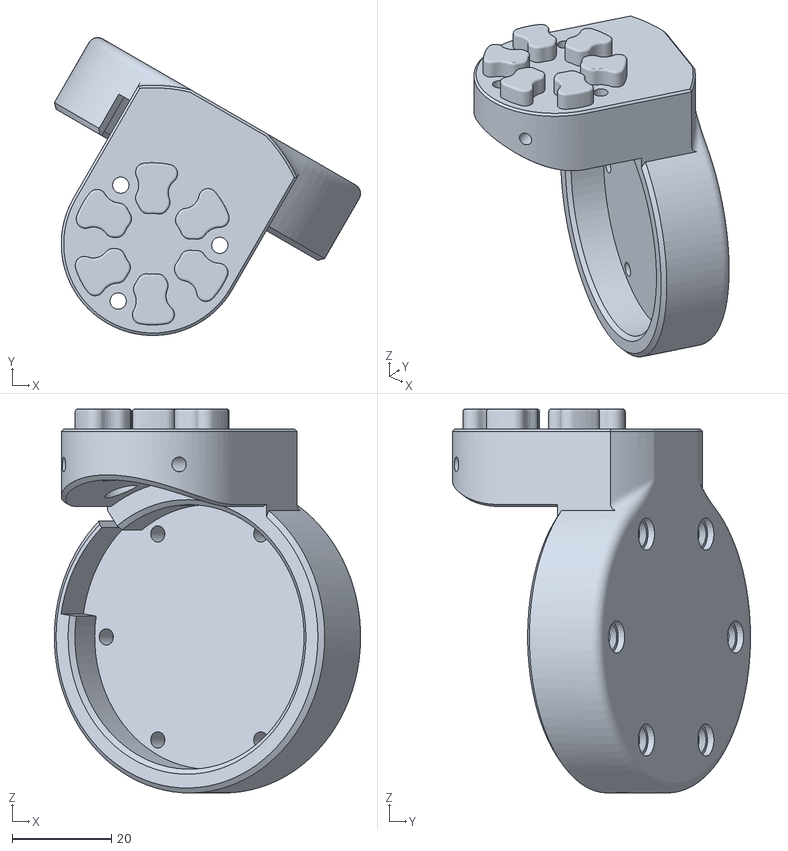
[picture p155: CAD file, 2026-09-15]
sim/model/meshes/quadruped_link01_v2.stl
61.8 x 60.1 x 77.5
