snowyfoams/dog6/sim/model/meshes/quadruped_body_cover.stl

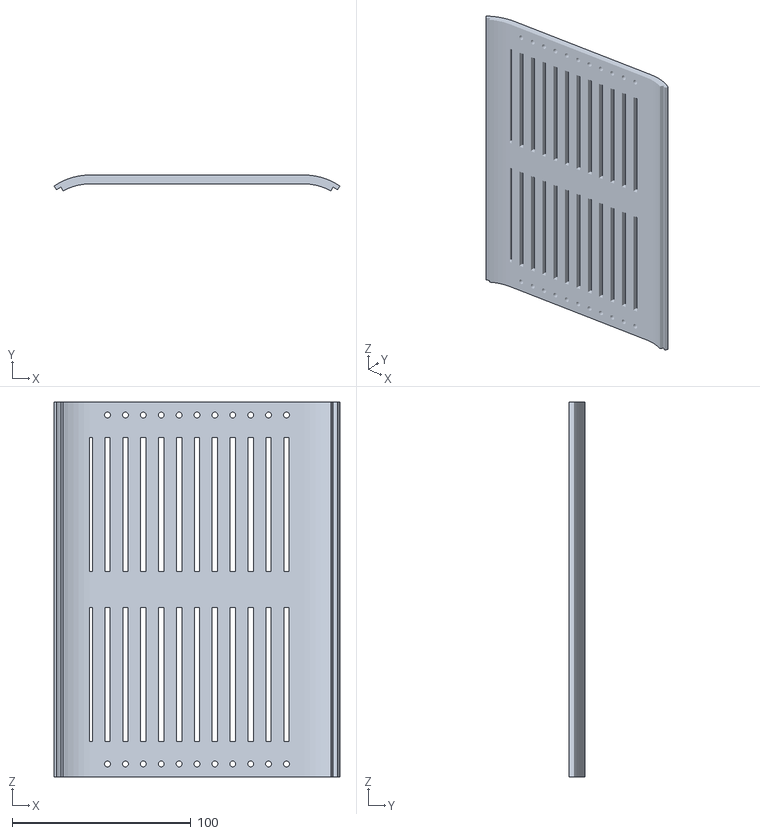
[picture p156: CAD file, 2026-09-15]
sim/model/meshes/quadruped_body_cover.stl
159.8 x 8.92 x 209.6
