snowyfoams/dog6/sim/model/meshes/MG5010-i10_plane.stl

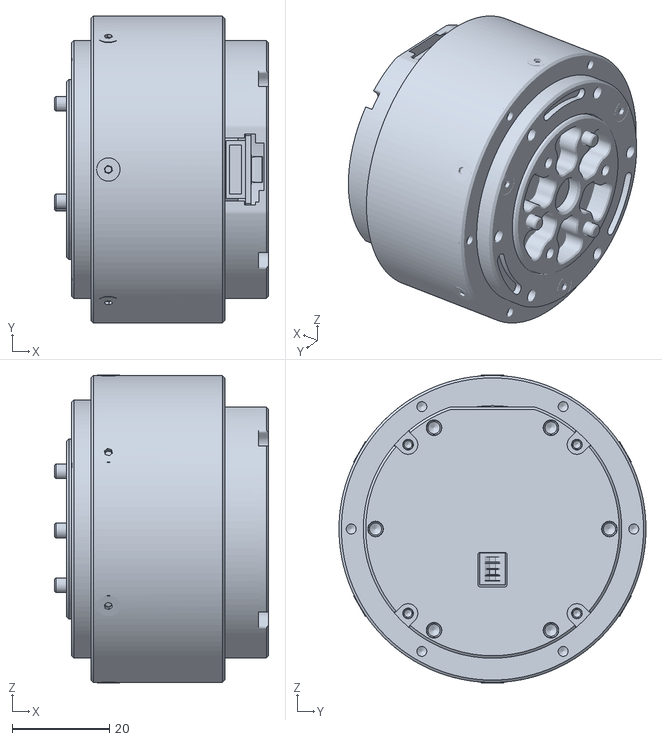
[picture p157: CAD file, 2026-09-15]
sim/model/meshes/MG5010-i10_plane.stl
44.0 x 63.0 x 63.1
