snowyfoams/dog6/sim/model/meshes/quadruped_body_v2.stl

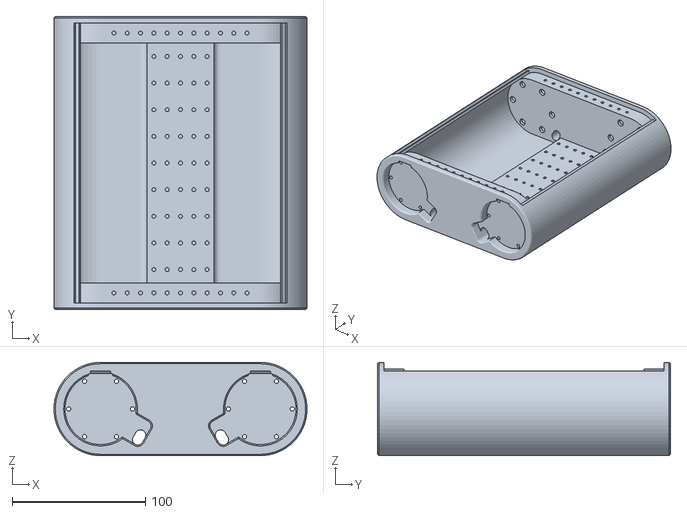
[picture p158: CAD file, 2026-09-15]
sim/model/meshes/quadruped_body_v2.stl
189.9 x 220.0 x 70.0
