snowyfoams/dog6/sim/model/meshes/quadruped_link02_v2_MIR_MIR.stl

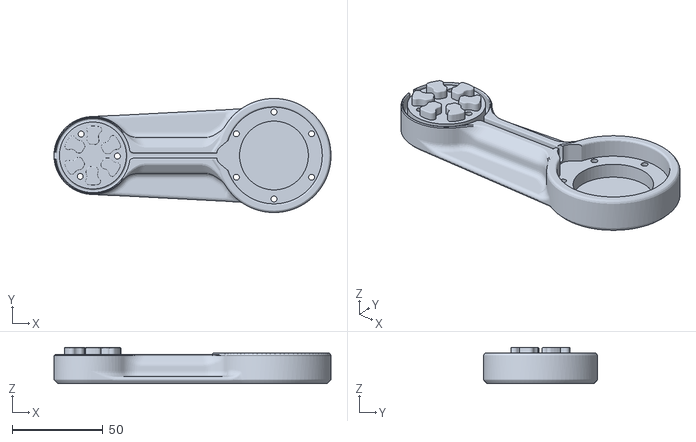
[picture p159: CAD file, 2026-09-15]
sim/model/meshes/quadruped_link02_v2_MIR_MIR.stl
153.0 x 63.0 x 20.0
