snowyfoams/dog6/sim/model/meshes/link01_v2_support.stl

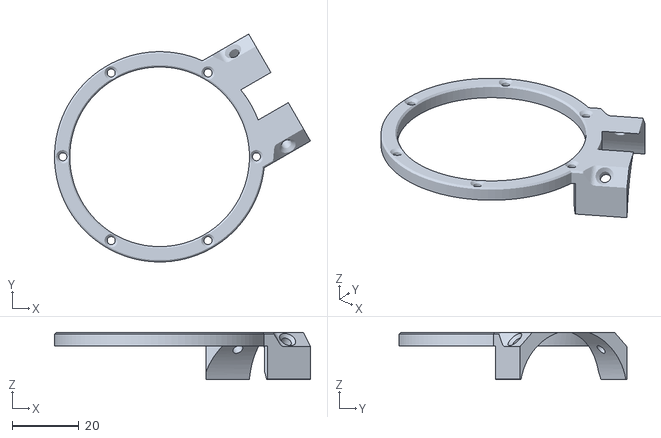
[picture p160: CAD file, 2026-09-15]
sim/model/meshes/link01_v2_support.stl
76.7 x 68.3 x 14.1
