snowyfoams/dog6/(list of files, cad)

Other CAD files:
sim/model/meshes/quadruped_link02_v2_MIR.stl
sim/model/meshes/quadruped_foot_MIR.stl
sim/model/meshes/quadruped_link01_v2_MIR.stl
sim/model/meshes/MG5010-i10_plane_MIR.stl
sim/model/meshes/link01_v2_support_MIR.stl
sim/model/meshes/quadruped_link03_v2_MIR_MIR.stl
sim/model/meshes/quadruped_link03_v2.stl
