snowyfoams/dog6/doc/swing_hw/results.txt

THE HUNG-UP SWING, 2026-10-27, ROUND 1: hw.swing_ff, all four legs, 12 swings a leg, FOLD2 at 160 mm, 20 mm arc, duty 0.8, ramp 0.15, Kp 150/150/400, Kd 6/6/40, cap 9 N*m, slew 300 N*m/s
per run, median [p10, p90] over the 40 swings after the first two of each leg; heights above the resting site, mm

  group run                   T s swing | apex                   s  lag ms            rms    h_td                vz_td  t_arr ms         vz_arr     dip   x mm
  B1    FF off, 0.6 s         0.6  116ms |  12.8 [12.4, 13.4]  0.81     53 [49, 56]  10.3   10.6 [9.7, 11.6]  -0.16     48 [44, 52]  -0.12   +0.1    4.8
  B2    FF off, 0.8 s         0.8  156ms |  15.1 [14.5, 15.8]  0.76     62 [60, 65]   9.7    9.9 [9.2, 10.9]  -0.21     44 [40, 48]  -0.11   +0.3    4.4
  B3    FF off, 1.0 s         1.0  196ms |  16.6 [16.0, 17.3]  0.73     72 [69, 74]   8.9    8.4 [7.9, 9.0]  -0.22     40 [32, 44]  -0.10   +0.6    4.3
  B4    FF off, 1.4 s         1.4  276ms |  18.4 [17.6, 19.0]  0.67     90 [85, 93]   7.5    5.9 [5.4, 6.4]  -0.15     32 [24, 44]  -0.08   +0.8    4.9
  B5    FF off, 2.0 s         2.0  395ms |  19.2 [18.2, 19.9]  0.61    117 [115, 120]   6.2    4.1 [3.6, 5.1]  -0.09     36 [20, 56]  -0.04   +1.0    4.2
  B6    FF on 0.003, 2.0 s    2.0  395ms |  16.7 [15.6, 16.9]  0.50     82 [82, 87]   3.8    4.0 [3.6, 4.6]  +0.01     64 [60, 68]  -0.05   +0.8    4.1
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
  B7    FF on 0.001, 0.8 s   | 0.0043 (0.56,  0 ms), 0.0005 (0.88, 20 ms) | 0.0053 (0.63,  4 ms), 0.0036 (0.73,  4 ms) | 0.38, 0.40
  B8    FF on 0.003, 0.8 s   | 0.0011 (0.56, 20 ms), 0.0006 (0.82, 20 ms) | 0.0052 (0.64,  4 ms), 0.0026 (0.70, 20 ms) | 0.37, 0.29

GUESS 1 -- period, FF off: apex 12.8, 15.1, 16.6, 18.4, 19.2 mm, h_td +10.6, +9.9, +8.4, +5.9, +4.1 mm, lag as a share of the swing 46, 40, 37, 33, 29 %, t_arr +48, +44, +40, +32, +36 ms, vz_arr -0.12, -0.11, -0.10, -0.08, -0.04 m/s for T = 0.6, 0.8, 1.0, 1.4, 2.0 s
GUESS 2 -- 2.0 s, FF off -> on 0.003: apex 19.2 -> 16.7 mm (at s 0.61 -> 0.50), lag 117 -> 82 ms, rms 6.2 -> 3.8 mm, h_td +4.1 -> +4.0 mm, t_arr +36 -> +64 ms, vz_arr -0.04 -> -0.05 m/s
GUESS 3 -- 0.8 s, FF off / 0.001 / 0.003: apex 15.1 / 15.3 / 18.9 mm, rms 9.7 / 9.0 / 4.9 mm, h_td +9.9 / +3.1 / -1.6 mm, t_arr +44 / +4 / -15 ms, vz_arr -0.11 / -0.18 / -0.35 m/s, dip +0.3 / +0.4 / -2.8 mm, x 4.4 / 11.5 / 7.9 mm, rate 153 / 194 / 263 N*m/s
