snowyfoams/dog6/doc/swing_height/tex/tab_results.tex

\begin{tabular}{lrrrrrrrrr}
\toprule
 & apex & $s_{apex}$ & lag & rms & $h_{td}$ & $v_{z,td}$ & $|x|$ & $\hat\tau$ & clip \\
 & mm & & ms & mm & mm & m/s & mm & N\,m & N\,m \\
\midrule
\textbf{FF off} & 15.0 & 0.83 & 55 & 9.9 & 13.0 & $-$0.10 & 4.2 & 0.95 & 0.00 \\
\textbf{FF on} & 23.4 & 0.52 & 33 & 3.4 & $-$1.9 & $-$0.11 & 5.0 & 3.31 & 0.21 \\
\midrule
FF off, ideal chain & 14.1 & 0.79 & 55 & 9.2 & 12.2 & $-$0.08 & 3.3 & 0.87 & 0.00 \\
FF on, ideal chain & 21.7 & 0.48 & 28 & 1.6 & 0.7 & $-$0.01 & 1.0 & 3.11 & 0.00 \\
\bottomrule
\end{tabular}
