snowyfoams/dog6/doc/swing_leg/fig/slew_budget.pdf

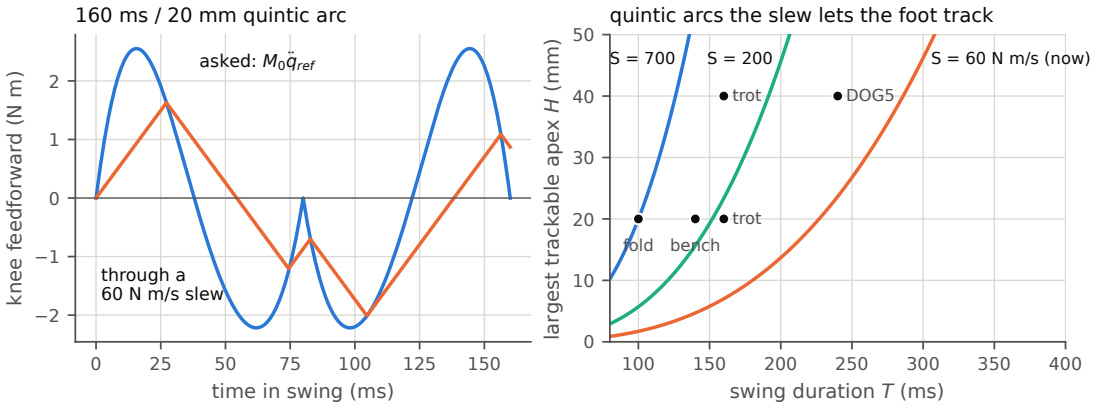
[picture p161: page 1]
knee feedforward (N m); asked: M0q̈; ref; through a 60 N m/s slew; S = 60 N m/s (now)

160 ms / 20 mm quintic arc

quintic arcs the slew lets the foot track

trot | DOG5

largest trackable ape

trot

fold bench

time in swing (ms)

swing duration T (ms)
