snowyfoams/dog6/hw/stand.py

"""DOG6 stand ON THE ROBOT: `sim.stand`'s sequence, through the real drivers.

    V=/home/robot01/Documents/can_motor_control/.venv/bin/python
    $V -m hw.stand --fake --auto 1 --no-imu   the whole path, no robot
    $V -m hw.stand --tau-cap 3.0 --log run.npz
    $V -m hw.stand --law per-leg --tau-cap 1.0 --log baseline.npz

    ATTITUDE GAINS, all in the PD's own units (kp 1/s^2, kd 1/s):
    $V -m hw.stand --kp-att 90 --kd-att 17           roll AND pitch together
    $V -m hw.stand --kp-roll 290 --kd-roll 23        roll only; pitch keeps
                                                     --kp-att / --kd-att
    $V -m hw.stand --kp-att 120 --kp-roll 290        pitch 120, roll 290; roll
                                                     kd follows --kd-att (17)
    $V -m hw.stand --kp-yaw 25 --kd-yaw 10          the HEADING spring, on
                                                     since 2026-09-24
    $V -m hw.stand --kp-yaw 0                        the damper-only yaw this
                                                     ran with before that
    --kp-roll and --kd-roll are independent: pass one and the other follows
    --kp-att / --kd-att.  The banner prints what each axis actually got.

    THE YAW SPRING HOLDS A DRIFT, NOT A NORTH.  It acts on the heading error
    off the yaw latched at the crouch -> rise handover, which is what makes a
    magnetometer beside twelve motors a fair thing to close on at all --
    `balance.config.KP_YAW` has the sizing and `hw.trot_esti` prints what a
    trot does to the heading.

Seven phases.  ENTER steps them -- except RISE, which ends on its own clock.
X is an E-STOP at any point:

    limp     0xA1 iq=0 keep-alives.  NO TORQUE.  Joint angles, the FK height
             and the trunk attitude are printed, so a wrong sign or a wrong
             zero is READ here, before anything moves
    settle   driver position mode (0xA4), holding the pose latched at ENTER
    crouch   0xA4, smoothstep to `sim.stand.Q_CROUCH` -- trunk on the floor
    rise     0xA1 TORQUE, one of two laws (below), through
             `hw.safety.SafetyGate`.  Ends WITHOUT a keypress, the sweep the
             S-curve arrives; ENTER is refused until then
    hold     the same law, same gains, at height.  THIS IS THE EXPERIMENT:
             push the trunk and watch whether it comes back.  The status line
             carries the worst tilt from the setpoint, the moment the law
             asked for, and how long recovery took
    park     0xA4, back to Q_CROUCH from wherever the hold left it
    done     0xA4, holding Q_CROUCH.  ENTER exits and stops the motors

`sim.stand` explains why the sequence is shaped this way.  This file only
explains what is different about running it on twelve MG5010 drivers.

    $V -m hw.stand --wave FL                  twelve phases: after `hold`,
             shift    TORQUE, the trunk slides over the feet
             raise    TORQUE, the FL paw is unloaded, then lifted
             wave     TORQUE, three feet; the paw waves, then holds
             lower    TORQUE, the paw goes back and is reloaded
             unshift  TORQUE, the trunk slides back
    `sim.wave` owns all five -- the targets, the load split and the law --
    and `balance.sequence.phases_for` says what they inherit from the hold.
    Plain `hw.stand` only: the nominal stand.


WHAT IS IN THIS FILE, AND WHAT IS IN `hw.balance`
    This file is the RUNNER: the CAN loop and its slots, the key poller, the
    per-sweep log, the exit report and the command line.  Every one of those
    is I/O, and I/O is the dividing line.

    THE SEQUENCE ITSELF IS `hw.balance.sequence.StandSequence` -- the six
    phases, what each one sends, the 0xA4 speed caps and the tracking trips
    that decide to stop.  It sits next to the law it hands the lift to,
    because every seam between a position phase and the lift is a statement
    about that law: the lift arms from the pose the CROUCH left, `arm` latches
    h0 and the heading from what is MEASURED there, and the PARK starts from
    wherever the lift settled rather than from Q_CROUCH.

    Nothing in that file opens a bus, reads a clock of its own or prints, so
    the object `--fake` exercises is exactly the object the robot runs, and it
    can be stepped in a test with a hand-built state and no hardware at all.


TWO LIFT LAWS, AND KEEPING BOTH IS THE POINT
    --law srb        `hw.balance`, the default.  The trunk's attitude is
                     MEASURED, the error is an SO(3) log map, gravity enters
                     once as m*g, and an allocator splits the resulting wrench
                     across four feet by the geometry the robot actually has.
                     Roll and pitch have gains that are roll and pitch gains.
    --law per-leg    `sim.stand.compliance_torque`, UNCHANGED.  Four
                     independent Cartesian springs in their own hip frames, a
                     fixed mg/4 feedforward, no sensor that reads trunk
                     attitude and no variable that names it.

    The second one is kept because without it the first question after a bad
    run -- "is this worse than what we had?" -- has no answer.  It is also the
    A/B that says whether a fault is above or below the model: if the per-leg
    law misbehaves too, no controller swap will fix it and the place to look
    is the torque gain, the current loop or the CAN timing.

    `--ablate-attitude` is the third point on that line: the SRB law with both
    attitude gains zeroed, which is the height loop and gravity split properly
    and nothing else.  Between "the old law" and "the new law" it is the step
    that isolates what the attitude loop itself did.


WHAT CARRIES OVER FROM SIM, AND WHAT DOES NOT
    Carries   Q_CROUCH, FOOT_XY, CROUCH_HEIGHT, LIFT_HEIGHT, the ramp
              durations, the smoothstep, and the compliance law with its
              KP_CART / KD_CART and weight feedforward -- all imported from
              `sim.stand`, none copied.  A trajectory and a force law at the
              feet are properties of the robot, not of the simulator.
    Does not  KP_JOINT / KD_JOINT.  Position mode here IS the driver's own
              0xA4 loop, closed in the driver with the driver's gains.  The
              python PD in `sim.stand` was only ever emulating it.

    Frames: every command is in JOINT coordinates.  `MotorBus` is opened with
    `hardware_map.motor_directions()`, so 0xA1/0xA4 apply the measured sign on
    the way out, and `calibration.joint_state` applies it on the way back.
    Both laws use `hw.kinematics` (0.09 ms for four legs) rather than
    `sim.kinematics`; `sim.selftest` gates the two at 1e-12.

    HEIGHTS.  Everything this file PRINTS is floor to trunk BOTTOM -- the
    number a ruler reads.  `sim.stand`'s constants are trunk-ORIGIN heights,
    35.01 mm higher, and `hw.balance.state` is the only conversion.  DOG5
    printed 191 mm where a ruler read 160 for want of that distinction.


THE TIMING, MEASURED RATHER THAN ASSUMED
    The SRB law runs entirely at slot 0, once per 4 ms sweep, and it delays
    the same motor every sweep -- so it has to fit in a 333 us slot.  It does:
    210 us in isolation and p50 250-310 / p95 375 us inside the fake-bus loop
    on a laptop, with all four leg-gravity terms refreshed every sweep.

    That last part is only affordable because `hw.balance.torque` has a
    closed form for it: the chain walk `sim.kinematics` uses costs 465 us for
    four legs and would be two thirds of the whole law.  `--gravity-legs 1`
    sub-rates it the way the per-leg law does, at the cost of the 12 ms skew
    across the legs.  The exit report prints the law's real p50/p95/max every
    run; if the Pi disagrees with the numbers above, believe the Pi.

    ANYTHING ELSE THAT COSTS REAL TIME GETS ITS OWN SLOT.  The eleven slots
    that are not slot 0 send one frame and then wait, so there is 300-odd us of
    each going spare.  `ESTIMATOR_SLOT` spends one of them on an `estimator`
    tap -- 290 us of Kalman filter that slot 0 has no room for.


THE 50 MS INPUT-LOST PROTECTION IS WHAT SHAPES THE LOOP
    Every driver latches error 0x80 and goes limp if it hears nothing for
    `safety.INPUT_LOST_S`.  So this is ONE single-threaded paced loop in which
    every slot sends exactly one frame to exactly one motor, round-robin,
    from the moment `arm()` returns to the moment the motors are stopped:

      * nothing after `arm()` blocks -- no `status1()`, no `flush_rx()`, no
        `input()`.  Keys are polled with a zero-timeout select;
      * the control law runs once per sweep, at slot 0.  If it overruns, the
        schedule RE-ANCHORS instead of catching up, because catching up is a
        burst of back-to-back frames into a 10-frame SocketCAN TX queue;
      * the driver fault byte only arrives in a 0x9A reply, so one 0x9A
        replaces one control frame every other sweep, rotating over the
        twelve.  That motor's command gap becomes two sweeps, 8 ms at 250 Hz;
      * before every send the gap since that motor's previous frame THE
        KERNEL TOOK is measured.  Past `GAP_ESTOP_S` -- half the window --
        the run stops while the drivers are still listening, rather than
        finding out from a 0x80 that one of them already went limp, and says
        whether the link refused, another process had the core, or this one
        was computing (`realtime.SendGuard`).  A 0x80 seen anyway is its own
        e-stop;
      * nothing else may take the time either: the garbage collector is
        frozen before `arm()` and run by the loop in a slot of its own, and
        on the robot every thread runs at nice -20 (`hw.realtime`: a GC pass
        reproduced "CAN 6 went 27.3 ms without a frame" on the fake bus, and
        four MuJoCo sweeps beside a real run took a quarter of its core --
        the two candidates for that stop, 2026-10-05);
      * can0 itself is the program's: reset before the socket opens and
        after the motors stop, re-plugged in software when it has to be
        (`hw.can_link`).  A link that dies under the loop is a stop reason
        like any other, with the log and the reports after it.


AN E-STOP IS A LIMP ROBOT, AND DURING RISE OR HOLD THAT IS A DROP
    X, Ctrl-C, a trip and a crash all end in `MotorBus.close()`: 0x81 stop
    then iq=0 to every motor.  From limp, settle, crouch, park and done that
    is harmless -- the crouch holds at zero torque (sim measured 0.1 mm of
    trunk drop in 3 s released).  From RISE or HOLD it drops the trunk onto
    its belly from up to 157 mm.  Run the first lifts with the robot
    supported -- and note that HOLD is the phase an operator deliberately
    PUSHES, so it is the phase in which a trip is most likely and a drop
    least expected.

    A TILT ENDS NOTHING: THE TILT E-STOP IS DELETED, 2026-10-05, on request.
    Past `--fall-hold` the balance law stops and every joint is held at the
    stand in joint space (`balance.law.BalanceLaw.fall_hold_deg`, phase
    "fall") until ENTER parks or X drops it -- 45 deg in every trot.  The
    stands have no fall hold (their 5 N*m/s slew cannot carry it), so in a
    stand nothing acts on a tilt; the tracking trip is still on.

    `--tau-cap` defaults to `safety.TAU_START_MAX` = 1.0 N*m, which CANNOT
    lift the robot: the lift phase will push, saturate, and leave the trunk on
    the floor.  That is the intended first run.  Standing needs about 2.2;
    `TAU_STAGED_MAX` = 3.0 is the ceiling `SafetyGate` allows.

    Position mode has NO torque cap -- 0xA4 carries a speed limit and nothing
    else, so the crouch and park transients are limited by the driver's own
    configuration, not by `--tau-cap`.  What bounds them here is the
    per-joint speed cap and the tracking-error trip.


THE MAP
    Confirmed on the robot by the operator, 2026-09-15 (CAN 3, 6, 7, 9, 10, 12
    are -1), so `hw.CONFIRMED_ON_DOG6` is True and `--unconfirmed` is not
    needed.  If the map is ever re-opened, `SafetyGate` refuses again until
    `--unconfirmed "why"` is given.  The limp phase stays the place to look:
    move a foot by hand and watch the printed angle go the way
    `hw.hardware_map` predicts.
"""
from __future__ import annotations

import argparse
import dataclasses
import sys
import time

import numpy as np

if __package__ in (None, ""):        # allow `python hw/stand.py` too
    import os
    sys.path.insert(0, os.path.dirname(os.path.dirname(os.path.abspath(__file__))))
    __package__ = "hw"

from sim import coordinates as C     # noqa: E402
from sim import kinematics as SK     # noqa: E402
from sim import params as P          # noqa: E402
from sim import stand as ST          # noqa: E402
from sim import wave as WV           # noqa: E402

from . import CONFIRMED_ON_DOG6      # noqa: E402
from . import calibration as CAL     # noqa: E402
from . import can_link as CANL       # noqa: E402
from . import hardware_map as HM     # noqa: E402
from . import imu as IMU             # noqa: E402
from . import realtime as RT         # noqa: E402
from . import safety as SAFE         # noqa: E402
from . import script as SCRIPT       # noqa: E402
from . import velocity_estimator as VEL  # noqa: E402
from .balance import config as BCFG  # noqa: E402
from .balance import controller as BCTRL   # noqa: E402
from .balance import law as BLAW     # noqa: E402
from .balance import posture as POSE  # noqa: E402
from .balance import state as BSTATE  # noqa: E402
from .balance import swing as BSWING  # noqa: E402
from .balance.sequence import (      # noqa: E402
    LAWS, PHASES, StandSequence, phase_blurb)

#: Re-exported from `balance.sequence`, which owns the sequence itself.
#: This module is the RUNNER: the bus, the slots, the keys, the log, the CLI.
__all__ = ["PHASES", "LAWS", "StandSequence", "GAP_ESTOP_S", "StandLog",
           "run", "main"]

#: Per-motor command rate.  DOG5's 250 Hz: 3000 frames/s out and 3000 back is
#: about 72 % of a 1 Mbit/s bus, and 4 ms is far inside the 50 ms window.
RATE_HZ = 250.0

#: Stop while the drivers are still listening: half their input-lost window.
GAP_ESTOP_S = 0.5 * SAFE.INPUT_LOST_S

#: What `--no-limits` leaves ON.  None of it limits where the robot goes:
#: the operator's key, the drivers' health, and the gate's torque shaping.
NO_LIMITS_KEPT = ("X, CAN input-lost / missed replies / sweep gap, "
                  "over-temperature, motor faults, torque readback, non-finite "
                  "state; the torque cap, the 9 N*m clip, the slew, the soft "
                  "start")

#: A 0x9A replaces one control frame every this many sweeps, rotating.
STATUS_EVERY_SWEEPS = 2

#: Which slot an `estimator` tap runs in.  NOT SLOT 0, AND THAT IS MEASURED.
#: Slot 0 belongs to the control law, and on the Pi (2026-09-24) the law alone
#: is p50 470 us in `balance.selftest` and p50 560 us inside this loop -- the
#: slot is 333 us, so it is over budget before anything is added to it.
#: `hw.state_estimator`'s filter is another 290 us, and run at slot 0 it pushed
#: EVERY sweep past the 1 ms re-anchor line (2000 overruns in a run against 59)
#: and widened the worst CAN gap from 6.2 to 6.5 ms.  Every other slot sends one
#: frame and then waits, so one of them has the time to spare.
#:
#: THE TAP STILL SEES THE SWEEP'S OWN MEASUREMENT: `body` and `orientation` are
#: latched at slot 0 and handed over here unchanged, so only the arithmetic
#: happens 2 ms later, not the reading.  That is a luxury a tap can have and a
#: fast controller cannot -- the law acts BEFORE this slot, which is exactly
#: why `state_estimator.adapters.run_once` documents the order it does.
#: The trots' x/y loop (`--est-xy`) feeds on it anyway, ONE SWEEP LATE (`run`'s
#: `feed`): 4 ms is 0.7 deg of phase at that loop's 0.48 Hz.
ESTIMATOR_SLOT = 6

#: The slot the HOLD's CoM sample is taken in (`StandSequence.feed_torque`,
#: `--com-auto`), on slot 0's latched measurement and torque readback: four
#: 3x3 solves and the legs' weight, which slot 0 has no room for and nothing
#: reads before T.  Clear of the estimator's slot and the GC's.
COM_SLOT = 9

#: Low-pass on the finite-differenced encoder, the velocity the law damps
#: with.  The driver's own speed field is kept as the safety gate's witness
#: only -- see `calibration.joint_state` for why it is not trusted alone.
QD_FILTER_HZ = 40.0

STATUS_PERIOD_S = 0.5


class StandLog:
    """Per-sweep recorder.  The 2026-09-15 runs could not be analysed because
    nothing was kept -- a 2 Hz status line is not a log.

    Columns are chosen so that every term of the law is RECOVERABLE: the
    commanded height beside the measured one, the wrench asked for beside the
    forces allocated, the torque commanded beside the torque the drivers
    report producing.  A log of a bad run that holds the result and neither
    the cause nor the command is what the last set of runs had.
    """

    #: field -> per-sweep shape.  DECLARED rather than inferred, so the
    #: SRB-only columns come out the same shape under `--law per-leg` (full of
    #: NaN) as under `--law srb`.  An A/B is two files read by one script, and
    #: a script that has to branch on which law wrote the file is a script
    #: that will eventually compare the wrong columns.
    FIELDS = {
        "t": (), "h_cmd": (), "h": (), "p_cz": (), "p_cz_dot": (),
        "roll": (), "pitch": (), "yaw": (), "imu_age": (),
        "omega_b": (3,), "b_d": (6,), "e_R": (3,), "fz": (C.N_LEGS,),
        "f_w": (C.N_LEGS, 3), "residual": (6,),
        "q": (C.N_JOINTS,), "qd": (C.N_JOINTS,), "q_ref": (C.N_JOINTS,),
        "tau_cmd": (C.N_JOINTS,), "tau_meas": (C.N_JOINTS,),
        "tau_req": (C.N_JOINTS,),
        # the trot: NaN outside it.  x_b beside p_swing is the swing error.
        "contact_w": (C.N_LEGS,), "swing_s": (C.N_LEGS,),
        "p_swing": (C.N_LEGS, 3), "x_b": (C.N_LEGS, 3),
        # the state estimator, when one is FED to the law (a trot's --est-xy):
        # the estimate the law read (trunk origin, world), its age, the CoM
        # x/y setpoint the trot holds, and 1 on the sweeps the x/y rows were
        # driven by it.  NaN everywhere else.  b_d[0:2] is the force it asked.
        "p_est": (3,), "v_est": (3,), "est_age": (), "xy_des": (2,),
        "xy_on": (),
        # the CoM (--com-auto): the latest HOLD sample, trunk x/y m (NaN
        # outside HOLD; a sweep late, it is taken after the row), and the
        # pin c^b x/y the law flew this sweep -- a step in it is a T's
        # re-centring, and hw.com_check reads both.
        "com_meas": (2,), "com_pin": (2,),
        # the MPC (hw.fold2_cmpc): ms its QP took, on the sweeps one ran; NaN
        # on every other.  On a trot sweep of that runner f_w / fz are the
        # MPC's forces and b_d what the SRB law would have asked.
        "mpc_ms": (),
    }

    def __init__(self) -> None:
        self.rows: list[dict] = []

    def add(self, **row) -> None:
        self.rows.append(row)

    def save(self, path: str) -> str:
        if not self.rows:
            return "nothing to save -- the run never reached a torque phase"
        columns = {"phase": np.array([row.get("phase", "") for row in self.rows],
                                     dtype="U8")}
        for field, shape in self.FIELDS.items():
            blank = np.full(shape, np.nan)
            columns[field] = np.array(
                [blank if row.get(field) is None else row[field]
                 for row in self.rows], dtype=float)
        np.savez_compressed(path, **columns)
        return "%d sweeps -> %s" % (len(self.rows), path)


# ===========================================================================
# the loop
# ===========================================================================
class KeyPoller:
    """Non-blocking single keys from a POSIX tty; `ok` is False without one.

    cbreak, not raw, so Ctrl-C still raises KeyboardInterrupt and the
    `finally` still stops the motors.  Always `restore()`.
    """

    def __init__(self):
        self.ok = False
        self._saved = None
        try:
            import termios
            import tty
            if not sys.stdin.isatty():
                return
            self._fd = sys.stdin.fileno()
            self._saved = termios.tcgetattr(self._fd)
            tty.setcbreak(self._fd)
            self.ok = True
        except Exception:                # noqa: BLE001
            self.restore()

    def get(self):
        if not self.ok:
            return None
        import select
        if select.select([sys.stdin], [], [], 0.0)[0]:
            return sys.stdin.read(1)
        return None

    def restore(self):
        if self._saved is not None:
            import termios
            try:
                termios.tcsetattr(self._fd, termios.TCSADRAIN, self._saved)
            except Exception:            # noqa: BLE001
                pass
        self._saved = None
        self.ok = False


def _print_phase(stand: StandSequence) -> None:
    print("\n>> phase %d %-6s : %s"
          % (stand.phase, stand.phase_name, phase_blurb(stand)), flush=True)


def _torque_lines(tau_cmd, tau_meas) -> str:
    """All twelve joints, commanded beside measured, in N*m, JOINT frame.

    Printed in RISE and HOLD, the two torque phases.  `tau_cmd` is what went
    out AFTER the safety gate; `tau_meas` is the q-axis current each driver
    reported back, with the direction already applied, so the two rows are
    directly comparable joint by joint.  A column where cmd moves and meas
    does not is a driver that is not following; a column where both move and
    the robot does not is torque being absorbed downstream of the motor.
    """
    rows = []
    for tag, tau in (("cmd ", tau_cmd), ("meas", tau_meas)):
        t4 = C.unflat(np.asarray(tau, dtype=float))
        rows.append("          tau %s %s" % (tag, "  ".join(
            "%s %+5.2f %+5.2f %+5.2f" % (leg, *t4[i])
            for i, leg in enumerate(("FL", "FR", "RL", "RR")))))
    return "\n".join(rows)


def _angle_lines(q_hold, q) -> str:
    """All twelve joint angles, degrees, JOINT frame, abd / pitch / knee per
    leg -- printed on every HOLD status line, in every entry point (fold
    trot and walk alike), 2026-10-06 on request ("the hold stage need print
    joint angle for each fold trot walk").

    `q_hold` is what the joint layer holds in HOLD (`balance.q_hold`: the IK
    at the stand with a tracked rise, re-latched after a --com-auto slide;
    the pose measured on reaching HOLD without one), printed above the
    measured `q` so a joint that is not where it is held reads at a glance.
    None (no joint layer) prints the measured row alone.  A damping-only
    HOLD (`--kp-joint 0`) latches the row all the same and pulls nothing to
    it."""
    rows = []
    for tag, qq in (("hold", q_hold), ("meas", q)):
        if qq is None:
            continue
        q4 = C.unflat(np.degrees(np.asarray(qq, dtype=float)))
        rows.append("          q   %s %s" % (tag, "  ".join(
            "%s %+6.1f %+6.1f %+6.1f" % (leg, *q4[i])
            for i, leg in enumerate(("FL", "FR", "RL", "RR")))))
    return "\n".join(rows)


def _crouch_report(stand, body) -> str:
    """The crouch as REACHED: every joint commanded beside measured, every
    foot from the FK, and the left/right mirror of each axle.

    Printed ONCE, on the sweep the crouch's position ramp arrives (and again
    when the park's does).  The crouch is the drivers' own position loop
    against whatever the floor allows -- in the fold the knee motors meet
    the floor before the joints meet their targets -- so the pose the robot
    SITS in is not the pose it was sent, and a leg that stopped on the floor
    earlier than its twin reads here as an error on that leg and as a foot
    out of mirror.  The operator's 2026-10-01: the rear feet were not the
    same in the fold crouch.  THIS TABLE SAYS WHICH LEG AND WHICH JOINT.

    The angles are JOINT coordinates through the measured table, so a joint
    whose measured angle MATCHES its command while the leg visibly does not
    match its twin is a zero or a direction in `hw.hardware_map`, not the
    floor: read it against a protractor with `hw.record --raw` and re-measure
    that row with `calibrate_leg.py --ids N`.
    """
    return _pose_table(
        stand.q_des, body,
        "  CROUCH REACHED -- joint angles (deg) and feet (mm, trunk frame):")


def _pose_table(q_target, body, head: str, extra: str | None = None) -> str:
    """The joint table both reports print: `q_target` beside `body.q`."""
    q_cmd = C.unflat(np.degrees(np.asarray(q_target, dtype=float)))
    q = C.unflat(np.degrees(np.asarray(body.q, dtype=float)))
    x = 1e3 * np.asarray(body.x_b, dtype=float)
    legs = ("FL", "FR", "RL", "RR")
    rows = [head] + ([extra] if extra else []) + [
            "   leg   abd cmd / meas / err   pitch cmd / meas / err   "
            "knee cmd / meas / err  |  foot x      y      z"]
    for i, leg in enumerate(legs):
        e = q[i] - q_cmd[i]
        rows.append("   %-3s %+7.1f %+7.1f %+5.1f   %+7.1f %+7.1f %+5.1f   "
                    "%+7.1f %+7.1f %+5.1f  |  %+7.1f %+6.1f %+6.1f"
                    % (leg, q_cmd[i, 0], q[i, 0], e[0], q_cmd[i, 1], q[i, 1], e[1],
                       q_cmd[i, 2], q[i, 2], e[2], *x[i]))
    rows.append("   mirror, left MINUS right (a symmetric pose reads 0 everywhere; "
                "joints mirror by sign, so the sum is printed):")
    for lo, hi, axle in ((0, 1, "front"), (2, 3, "rear")):
        dq = q[lo] + q[hi]
        rows.append("   %-5s joints abd %+5.1f  pitch %+5.1f  knee %+5.1f deg  |  "
                    "feet dx %+5.1f  d|y| %+5.1f  dz %+5.1f mm"
                    % (axle, *dq, x[lo, 0] - x[hi, 0], abs(x[lo, 1]) - abs(x[hi, 1]),
                       x[lo, 2] - x[hi, 2]))
    target = np.asarray(q_target, dtype=float)
    worst = int(np.argmax(np.abs(np.asarray(body.q) - target)))
    rows.append("   largest tracking error: %s, %.1f deg"
                % (HM.JOINT_LABELS[worst],
                   np.degrees(abs(float(body.q[worst]) - float(target[worst])))))
    return "\n".join(rows)


class VelocityTap:
    """`hw.velocity_estimator` on the stand's own IMU, for the status lines.

    The biases are taken in LIMP -- the one phase with no torque anywhere,
    so the robot is still (DOG5's `quiet_stages`) -- and the integration
    runs every sweep after that on the sensor's own clock.  Nothing the law
    does reads it.  No zero-velocity update: it drifts as the integrator
    does, and the status line shows the seconds since its zero.
    """

    def __init__(self, imu):
        self.feed = VEL.ImuRawFeed(imu)
        self.est = VEL.AccelVelocityEstimator()
        self.failed: str | None = None

    def update(self, still: bool) -> str | None:
        """Drain the raw stream; returns a line to print, once, or None."""
        if self.failed:
            return None
        samples = self.feed.drain()
        if self.est.initialised:
            self.est.update(samples)
            return None
        if not still:
            return None
        try:
            if self.est.collect(samples):
                return ("velocity estimator initialised in limp: b_f %s "
                        "m/s^2" % np.round(self.est.b_f, 3))
        except ValueError as refusal:
            self.failed = str(refusal)
            return "velocity estimator OFF: %s" % refusal
        return None

    def status(self) -> str:
        if self.failed:
            return "v OFF"
        if not self.est.initialised:
            return "v -- (not initialised: needs limp)"
        v = self.est.v_w
        return ("v (%+.3f, %+.3f, %+.3f) m/s  %.0f s since zero"
                % (v[0], v[1], v[2], self.est.elapsed_s))


class SwingHeight:
    """The swing foot's REAL height, for the trot's status lines: its FK above
    the floor the planted feet stand on, peaked over each swing.

    From the law's own state, which while trotting is `state.on_stance`'s:
    `z_origin` is the trunk above the feet that are DOWN, so z_origin -
    FOOT_RADIUS + (R x_b)_z is a foot's clearance in the WORLD -- zero on
    average for a planted foot, the lift for a swinging one, the trunk's
    tilt taken out by the IMU (none of it without one).  `--swing-height` is
    what the arc ASKS, trunk frame, above the resting foot; this is what the
    foot DID.  Print only: nothing reads it.
    """

    def __init__(self) -> None:
        self.peak = np.full(C.N_LEGS, np.nan)    # m, the swing in flight
        self.last = np.full(C.N_LEGS, np.nan)    # m, each leg's last whole swing

    def update(self, out) -> None:
        """Every sweep; `out` is the law's output while trotting, else None."""
        if out is None or out.state is None or out.swing_s is None:
            self.peak[:] = np.nan                # a swing cut off is not a swing
            return
        st = out.state
        z = st.z_origin - P.FOOT_RADIUS + st.x_b @ st.R[2]
        up = np.asarray(out.swing_s) > 0.0
        landed = ~up & np.isfinite(self.peak)
        self.last[landed] = self.peak[landed]
        self.peak[landed] = np.nan
        self.peak[up] = np.fmax(self.peak[up], z[up])

    def status(self, asked: float) -> str:
        return ("swing foot apex %.0f mm asked, reached %s mm (last swing, "
                "above the planted feet)"
                % (1e3 * asked, "  ".join(
                    "%s %s" % (C.LEGS[i], " -- " if not np.isfinite(z)
                               else "%4.1f" % (1e3 * z))
                    for i, z in enumerate(self.last))))


def run(mb, stand: StandSequence, *, rate_hz: float = RATE_HZ, key=None,
        auto_s: float | None = None, clock=time.perf_counter,
        imu=None, log: "StandLog | None" = None,
        velocity: "VelocityTap | None" = None, estimator=None,
        hook=None, terse: bool = False, feed: bool = False,
        gcq: "RT.QuietGC | None" = None,
        script: "SCRIPT.KeyScript | None" = None) -> str | None:
    """Drive `stand` on an ARMED `mb` until done, X, or a trip.

    Returns the stop reason, or None for a clean exit from "done".  Does not
    stop the motors -- the caller's `with MotorBus(...)` does, on every path.
    A link that dies under the loop (the adapter off USB, can0 down) is a
    stop reason too, not an exception: the log and the reports still come.

    `gcq` is `main`'s started `realtime.QuietGC`: with it the loop runs the
    garbage collector itself, in `realtime.GC_SLOT`; without it the
    automatic collector runs wherever an allocation trips it, as before.

    `imu` is an `hw.imu.ImuDog` or None.  NONE IS AN ABLATION, NOT A DEFAULT:
    with no IMU the trunk is assumed perfectly level and infinitely fresh, the
    attitude error is identically zero, and the SRB law degenerates to a
    height loop plus gravity split by the geometry.  That is a legitimate
    first run -- it is strictly more than the per-leg law had -- but it is not
    the controller this exists to be.

    `velocity` is a `VelocityTap` or None: print-only, nothing reads it.
    `estimator` is another print-only tap, duck-typed the same way --
    `update(now, stand, body, orientation) -> str | None` every sweep, and
    `status() -> str`, which may hand back several lines, under every status
    line.  `hw.trot_esti.EstimatorTap` is one, over `hw.state_estimator`'s
    filter; it costs as much as the law does, so it is stepped in
    `ESTIMATOR_SLOT` on the sweep's own latched measurement.  Without `feed`
    NOTHING HERE READS WHAT EITHER TAP RETURNS: the law is fed by
    `stand.update(now, body)` alone.
    `feed` True is the estimator IN THE LOOP (a trot's `--est-xy`), and its door
    is not the tap's return value: after each `update` the runner hands
    `estimator.estimate()` -- a `balance.law.TrunkEstimate`, or None -- to
    `stand.feed_estimate`, and the law reads it on the NEXT sweep's slot 0.
    One sweep late, 4 ms, because slot 0 has no room for the filter; the law
    ages every estimate and uses none past `config.EST_MAX_AGE_S`.  What it
    does with one is `balance`'s decision, not this loop's.
    `hook` is `main`'s: keys, an ENTER veto, and a call every sweep.

    `terse` cuts the 2 Hz stream down to the phase's OWN line -- rpy, its
    error and the height -- plus whatever a tap prints.  The weight, moment,
    torque, |tau|, gap and overrun lines are what an operator watching the
    LAW needs; a run whose subject is a tap's numbers wants those numbers
    unbroken instead, and `hw.trot_esti` asks for this.  It changes printing
    and nothing else: every trip still runs, and the exit reports are whole.
    """
    ids = HM.motor_ids()
    n = len(ids)
    unwrappers = CAL.new_unwrappers()
    misses = SAFE.CanMissMonitor(mb)
    readback = SAFE.TorqueReadback(n)
    slot = mb.slot(rate_hz)
    alpha_qd = 1.0 - np.exp(-2.0 * np.pi * QD_FILTER_HZ * n * slot)
    level = IMU.TrunkOrientation.level()
    est_slot = ESTIMATOR_SLOT % n
    est_sweep = None                  # (now, stand, body, orientation), latched
    com_slot = COM_SLOT % n
    com_sweep = None                  # (now, body, tau_meas), latched in HOLD
    # The gap counted on frames the kernel TOOK, and the verdict on a stall.
    guard = RT.SendGuard(mb, ids, GAP_ESTOP_S, SAFE.INPUT_LOST_S, gcq)
    gc_slot = RT.GC_SLOT % n
    link_lost = CANL.bus_errors()

    sweep = 0
    mode, values = "keepalive", None
    q_prev = t_prev = None
    qd_ctrl = np.zeros(n)
    q = np.zeros(n)
    overruns = 0
    #: `_crouch_report`, once per arrival of a position ramp (crouch, park).
    pose_reported = False
    swing_z = SwingHeight()
    imu_warned = False
    # The phase NAME as well as the index: the trot is a sub-state of hold
    # and changes the name without changing the index.
    last_phase = (stand.phase, stand.phase_name)
    last_status = stand.t_phase = clock()
    _print_phase(stand)

    deadline = clock() + slot
    k = 0
    while True:
        try:
            mb.poll()
        except link_lost as failure:
            return ("CAN link lost: %s -- the adapter left USB or can0 went "
                    "down under the run (the drivers go limp within %.0f ms)"
                    % (failure, 1e3 * SAFE.INPUT_LOST_S))
        if k == 0:
            now = clock()
            q, qd_driver = CAL.joint_state(mb, unwrappers)
            if q_prev is not None and now > t_prev:
                qd_raw = (q - q_prev) / (now - t_prev)
                qd_ctrl += alpha_qd * (qd_raw - qd_ctrl)
            q_prev, t_prev = q, now

            # -- stages 1 and 2, every phase ------------------------------
            # DO NOT WAIT FOR A PACKET.  The IMU streams on its own clock;
            # this takes the most recent one whatever its age and the law
            # decides what to do about the age.  A sweep that blocks on the
            # IMU is a sweep that misses its CAN deadline.
            orientation = level if imu is None else (imu.orientation() or level)
            # The SRB model is the LAW'S -- the posture's, pinned at the hold
            # height `--height` asked for -- not the module constant's: the
            # measurement must use the same c^b the reference does, and the
            # same object.
            body = BSTATE.read(q, qd_ctrl, orientation, srb=stand.balance.srb)
            stand.body = body
            if velocity is not None:
                said = velocity.update(stand.phase_name == "limp")
                if said:
                    print("\n   " + said, flush=True)
            if estimator is not None:
                # LATCHED HERE, RUN AT `ESTIMATOR_SLOT`.  `body` is rebound
                # further down, to the state the law acted on, so the tap's
                # copy is taken before anything can move it.  `stand` is the
                # live object, so by the time the tap reads its phase and its
                # yaw offset, THIS sweep's advance and rezero are already in
                # it -- which is what puts the read-out in the right phase and
                # the right world frame on the sweep the handover happens.
                est_sweep = (now, stand, body, orientation)
            if body.imu_stale and not imu_warned and imu is not None:
                imu_warned = True
                print("\n   IMU stale (%.0f ms): the attitude half of the law "
                      "is HELD at zero while it lasts"
                      % (1e3 * body.imu_age_s), flush=True)

            # -- operator ---------------------------------------------------
            pressed = key.get() if key is not None else None
            # THE SCRIPT (hw.script) PRESSES WHERE THE OPERATOR WOULD, one
            # key a sweep, and a key from the keyboard cancels it: whoever is
            # at the robot overrides the file -- except the stand-up's ENTER,
            # before the script's first press (`KeyScript.lets_through`).
            # With a script, --auto keeps only the position phases; HOLD and
            # the trot are the script's.
            auto_now = auto_s
            if script is not None:
                if pressed is not None:
                    if not script.lets_through(pressed, stand):
                        print("\n   " + script.cancel(
                            "operator pressed %s" % SCRIPT.key_name(pressed)),
                            flush=True)
                else:
                    pressed = script.poll(now, stand)
                    if pressed is not None:
                        print("\n   [script] %s" % script.describe_last(),
                              flush=True)
                if stand.phase_name not in SCRIPT.AUTO_PHASES:
                    auto_now = None
            if pressed in ("x", "X"):
                return "operator X"
            if pressed in ("t", "T"):
                print("\n   " + stand.toggle_trot(now), flush=True)
            # A hook that OWNS a key gets it alone: `hw.fold_walk`'s W is
            # forward, not the foot step.
            owned = (hook is not None and pressed is not None
                     and getattr(hook, "owns", lambda ch: False)(pressed))
            if pressed in ("w", "W") and not owned:
                print("\n   " + stand.toggle_step(now), flush=True)
            if hook is not None and pressed is not None:
                said = hook.key(pressed, now, stand)
                if said:
                    print("\n   " + said, flush=True)
            wants_next = pressed in ("\r", "\n")
            # --auto: `auto_s` after the phase's ramp has ARRIVED.  Asking
            # ramp_remaining about `auto_s` ago is exactly that test.  With a
            # gait, the hold presses T once and the trot latches its own exit
            # after two settles' worth of cycles.
            auto_trot = (auto_now is not None and stand.gait is not None
                         and (stand.trotting or (stand.phase_name == "hold"
                                                 and stand.trot_runs == 0)))
            # With a step: the first hold presses W, the trot runs from the
            # stepped stance, and the final ENTER steps back before parking.
            auto_step = (auto_now is not None and stand.step_to is not None
                         and stand.phase_name == "hold"
                         and stand.step_runs == 0)
            if auto_step:
                if now - stand.t_phase >= auto_now:
                    print("\n   " + stand.toggle_step(now), flush=True)
            elif auto_trot:
                trot_s = stand.gait.cycle_start(2 * stand.gait.settle_every)
                # A T already pressed and waiting for the HOLD's CoM is not
                # pressed again (`StandSequence.trot_pending`).
                if (not stand.trotting and not stand.trot_pending
                        and now - stand.t_phase >= auto_now) or (
                        stand.trotting and not stand.trot_exit
                        and now - stand.t_phase >= trot_s):
                    print("\n   " + stand.toggle_trot(now), flush=True)
            elif (auto_now is not None and now - stand.t_phase >= auto_now
                    and stand.phase_name not in ("step", "recentre")
                    and stand.ramp_remaining(now - auto_now) <= 0.0):
                wants_next = True
            if wants_next and hook is not None:
                veto = hook.blocks_advance(stand)
                if veto:
                    print("\n   ENTER ignored: " + veto, flush=True)
                    wants_next = False
            if wants_next:
                if stand.finished:
                    return None
                refused = stand.advance(now, q)
                if refused and stand.refusal_final and auto_s is not None:
                    return "refused to advance: " + refused
                if refused:
                    print("\n   ENTER ignored: " + refused, flush=True)

            # -- the law ----------------------------------------------------
            if hook is not None:
                hook.sweep(now, stand)
            mode, values, trip = stand.update(now, body)
            # THE BANNER FOLLOWS THE PHASE, NOT THE KEYSTROKE.  RISE ends on
            # its own clock, so a banner printed only where ENTER is handled
            # would silently skip the one phase change nobody pressed a key
            # for -- and that is the phase the operator is waiting for.
            if (stand.phase, stand.phase_name) != last_phase:
                last_phase = (stand.phase, stand.phase_name)
                _print_phase(stand)
            # The sequence does no I/O, so anything it needs an operator to
            # read comes back as text and is printed here.  Generic on
            # purpose: this is a channel, not a feature.
            notice = stand.take_notice()
            if notice:
                print("\n   " + notice, flush=True)
            if trip:
                return trip

            # -- the trips --------------------------------------------------
            errors = mb.errors()
            latched = [mid for mid, err in errors.items() if err & 0x80]
            if latched:
                return ("input-lost latch (0x80) on CAN %s: a driver heard "
                        "nothing for %.0f ms and went limp"
                        % (latched, 1e3 * SAFE.INPUT_LOST_S))
            temps = np.asarray([mb.rec(mid).temp or 0 for mid in ids])
            reason = stand.gate.estop_reason(
                q, qd_driver, now, temps=temps,
                miss_streaks=misses.update(mb), errors=errors)
            if reason:
                return reason

            # THE DRIVERS REPORT q-AXIS CURRENT IN EVERY REPLY, so commanded
            # torque can be compared against produced torque for free.  On
            # DOG5 a blackout produced ZERO measured torque with the command
            # pinned at the cap and CAN still answering -- every trip DOG6 has
            # would have stayed silent through it.  This is the one witness
            # that sees it.
            tau_meas = np.asarray([mb.torques_nm()[mid] for mid in ids])
            reason = readback.reason(stand.tau, tau_meas,
                                     live=(mode == "torque"))
            if reason:
                return reason
            # THE HOLD'S CoM SAMPLE: latched here with the measurement it goes
            # with, taken at `COM_SLOT`.  The sequence decides when it counts.
            if stand.com is not None and stand.phase_name == "hold":
                com_sweep = (now, body, tau_meas)

            swing_z.update(stand.out if mode == "torque" and stand.trotting
                           else None)

            if log is not None and mode == "torque":
                out = stand.out
                if out is not None and out.state is not None:
                    body = out.state          # the height the law acted on
                # The three-leg stance has no `out`: its load split and its
                # contact weights go in the same two columns.
                wave = (stand.wave if stand.wave is not None
                        and stand.phase_name in WV.WAVE_PHASES else None)
                log.add(t=now - stand.t_phase, phase=stand.phase_name,
                        h_cmd=BSTATE.origin_to_height(stand.h_cmd), h=body.h,
                        p_cz=body.p_cz, p_cz_dot=body.p_cz_dot,
                        roll=body.roll, pitch=body.pitch, yaw=body.yaw,
                        omega_b=body.omega_b, imu_age=body.imu_age_s,
                        b_d=None if out is None else out.wrench.b_d,
                        e_R=None if out is None else out.wrench.e_R,
                        fz=(wave.fz if wave is not None else
                            None if out is None else out.allocation.fz),
                        f_w=None if out is None else out.allocation.f_w,
                        residual=None if out is None else out.allocation.residual,
                        q=body.q, qd=body.qd.copy(), q_ref=stand.q_des,
                        tau_cmd=stand.tau, tau_meas=tau_meas,
                        tau_req=stand.tau_request,
                        tau_ff=None if out is None else out.tau_ff,
                        mpc_ms=None if out is None else out.mpc_ms,
                        contact_w=(wave.contact if wave is not None else
                                   None if out is None else out.contact),
                        swing_s=None if out is None else out.swing_s,
                        p_swing=None if out is None else out.p_swing,
                        x_b=body.x_b,
                        com_meas=(None if stand.com is None
                                  or stand.phase_name != "hold"
                                  else stand.com.last.copy()),
                        com_pin=np.array(stand.balance.srb.com_body[:2]),
                        **({} if not feed or out is None
                           or out.estimate is None else dict(
                               p_est=out.estimate.p_w, v_est=out.estimate.v_w,
                               est_age=out.est_age_s, xy_des=out.xy_des,
                               xy_on=float(out.xy_on))))

            # THE CROUCH AS REACHED, once, the sweep the position ramp arrives.
            if stand.phase_name in ("crouch", "park"):
                if stand.ramp_remaining(now) <= 0.0 and not pose_reported:
                    print(_crouch_report(stand, body), flush=True)
                    pose_reported = True
            else:
                pose_reported = False

            if now - last_status >= STATUS_PERIOD_S:
                last_status = now
                tail = "" if terse else (
                        "  |tau|=%.2f/%.2f  gap=%.1f ms  overrun=%d%s"
                        % (float(np.abs(stand.tau).max()), stand.tau_peak,
                           guard.worst_ms(), overruns,
                           "" if stand.out is None else
                           "  res %.1fN/%.2fNm"
                           % (stand.out.allocation.residual_force,
                              stand.out.allocation.residual_moment)))
                # THE HOLD PRINTS SOMETHING ELSE ENTIRELY, and REPLACES the
                # usual line rather than adding to it.  Every other phase is
                # asking "is it getting there"; the hold is asking "is the
                # attitude loop correcting", and the three numbers that answer
                # that -- rpy, rpy MINUS setpoint, and the moment being asked
                # for -- do not fit beside h_cmd and the gyro.
                watch = {"hold": stand.hold,
                         "trot": stand.trot}.get(stand.phase_name)
                if watch is not None and watch.live:
                    print("   %-6s t=%5.1f  %s"
                          % (stand.phase_name, now - stand.t_phase,
                             watch.status()), flush=True)
                    # IMU AGE IS BACK ON THE HOLD LINE.  A stiffer roll loop
                    # has less latency margin than the freeze threshold, so
                    # the age is now the number that says whether a roll
                    # oscillation is the gain or the stream.
                    if stand.trotting and not terse:
                        print("          cycle %d  weight %s%s%s"
                              % (stand.gait.cycles(now),
                                 np.array2string(stand.gait.contact_weight(now),
                                                 precision=2),
                                 "  SETTLE" if stand.gait.settling(now) else "",
                                 "  exit latched" if stand.trot_exit else ""),
                              flush=True)
                        print("          " + swing_z.status(
                            stand.balance.swing_height), flush=True)
                    if not terse:
                        print("          %s  imu %3.0f ms%s%s"
                              % (watch.moment_status(),
                                 1e3 * body.imu_age_s,
                                 " STALE" if body.imu_stale else "", tail),
                              flush=True)
                else:
                    track = ""
                    if stand.phase_name in ("settle", "crouch", "park", "done") \
                            and stand.q_des is not None and not terse:
                        # NOT `k`: that is the slot, and the frame below goes
                        # to ids[k].  Named `k` until 2026-10-05, every
                        # position-phase status line moved the round robin
                        # to the worst joint and skipped the motors before
                        # it for a sweep -- an 8 ms gap where 4 was meant.
                        err = np.abs(np.asarray(body.q) - np.asarray(stand.q_des))
                        worst = int(np.argmax(err))
                        track = "  track %.1f deg (%s)" % (np.degrees(err[worst]),
                                                           HM.JOINT_LABELS[worst])
                    print("   %-7s t=%5.1f  h_cmd=%6.1f  %s%s%s"
                          % (stand.phase_name, now - stand.t_phase,
                             1e3 * BSTATE.origin_to_height(stand.h_cmd),
                             body.status(), track, tail), flush=True)
                    if (stand.wave is not None
                            and stand.phase_name in WV.WAVE_PHASES):
                        # `body.h` averages the paw in; the law's h3 does not.
                        print("          " + stand.wave.status(), flush=True)
                if velocity is not None and not terse:
                    print("          " + velocity.status(), flush=True)
                if estimator is not None:
                    for line in estimator.status().splitlines():
                        print("          " + line, flush=True)
                if (hook is not None and not terse
                        and stand.phase_name in ("hold", "trot")):
                    print("          " + hook.status(now, stand), flush=True)
                if script is not None and not terse:
                    print("          " + script.status(now, stand), flush=True)
                if stand.phase_name == "hold" and not terse:
                    # THE HOLD'S JOINT ANGLES, every status line: what the
                    # joint layer holds beside what the encoders read.
                    print(_angle_lines(getattr(stand.balance, "q_hold", None),
                                       body.q), flush=True)
                if (stand.phase_name in ("rise", "hold", "trot", "step",
                                         "fall") + WV.WAVE_PHASES
                        and not terse):
                    print(_torque_lines(stand.tau, tau_meas), flush=True)
            sweep += 1

        # -- one frame, to one motor --------------------------------------
        mid = ids[k]
        sent_at = clock()
        # Past GAP_ESTOP_S since this motor's last frame THE KERNEL TOOK --
        # and the reason says whether the link refused, another process had
        # the core, or this one was computing (`realtime.SendGuard`).
        reason = guard.check(k, sent_at)
        if reason:
            return reason
        if (sweep % STATUS_EVERY_SWEEPS == 0
                and k == (sweep // STATUS_EVERY_SWEEPS) % n):
            taken = mb.status1_req(mid)
        elif mode == "position":
            taken = mb.position(mid, float(np.rad2deg(values[k])),
                                max_dps=float(stand.max_dps[k]))
        elif mode == "torque":
            taken = mb.torque(mid, float(values[k]))
        else:
            taken = mb.keepalive(mid)
        guard.sent(k, taken, sent_at)

        # The garbage collector, in a slot of its own after its frame -- not
        # wherever an allocation happens to trip it (`realtime.QuietGC`).
        if k == gc_slot and gcq is not None:
            gcq.step(sweep)

        # A tap that costs real time runs HERE, in a slot of its own and
        # AFTER that slot's frame is already out -- see `ESTIMATOR_SLOT`.
        if k == est_slot and est_sweep is not None:
            said = estimator.update(*est_sweep)
            est_sweep = None
            if feed:
                # THE ESTIMATOR IN THE LOOP: its answer goes to the law, which
                # reads it at the next slot 0 and decides what it is worth.
                stand.feed_estimate(estimator.estimate())
            if said:
                print("\n   " + said, flush=True)

        # The HOLD's CoM, in a slot of its own after its frame (`COM_SLOT`).
        if k == com_slot and com_sweep is not None:
            stand.feed_torque(*com_sweep)
            com_sweep = None

        k = (k + 1) % n
        overrun = mb.pace(deadline)
        deadline += slot
        if overrun > 3 * slot:
            # RE-ANCHOR, do not catch up: catching up is a burst of frames.
            overruns += 1
            deadline = clock() + slot
    # unreachable


def add_swing_leg_flags(group, base: str = "swing") -> None:
    """`--kp-swing-fl` .. `--kd-swing-rr`: ONE LEG'S Cartesian swing PD, x y
    z, in place of `--kp-swing` / `--kd-swing` on that leg alone.  2026-10-05,
    on request: a leg whose swing is weak is tuned without touching the other
    three.  The trot's parser and `hw.swing_bench`'s; `base` "swing-walk" is
    the walk's impedance, `--kp-swing-walk-rl` in place of `--kp-swing-walk`
    (`hw.fold_walk`, `hw.fold2_walk`).  `swing_leg_gains` reads them back."""
    for leg in C.LEGS:
        group.add_argument("--kp-%s-%s" % (base, leg.lower()), type=float,
                           nargs=3, default=None, metavar="N_PER_M",
                           help="%s's own swing stiffness, x y z, in place of "
                                "--kp-%s on %s alone" % (leg, base, leg))
        group.add_argument("--kd-%s-%s" % (base, leg.lower()), type=float,
                           nargs=3, default=None, metavar="NS_PER_M",
                           help="%s's own swing damping, in place of --kd-%s"
                                % (leg, base))


def swing_leg_gains(args, base: str = "swing"
                    ) -> tuple[np.ndarray, np.ndarray, list[str]]:
    """(4, 3) Kp, (4, 3) Kd -- a row per leg, FL FR RL RR: `--kp-<base>` /
    `--kd-<base>` in every row, a leg's own flags in its own -- and the
    names of the legs that have their own."""
    name = base.replace("-", "_")
    kp = np.tile(np.asarray(getattr(args, "kp_" + name), dtype=float),
                 (C.N_LEGS, 1))
    kd = np.tile(np.asarray(getattr(args, "kd_" + name), dtype=float),
                 (C.N_LEGS, 1))
    own = []
    for i, leg in enumerate(C.LEGS):
        row_p = getattr(args, "kp_%s_%s" % (name, leg.lower()), None)
        row_d = getattr(args, "kd_%s_%s" % (name, leg.lower()), None)
        if row_p is not None:
            kp[i] = row_p
        if row_d is not None:
            kd[i] = row_d
        if row_p is not None or row_d is not None:
            own.append(leg)
    return kp, kd, own


def swing_leg_banner(kp, kd, own, indent: str = "       ") -> str:
    """The banner's line for the legs with their own swing gains."""
    rest = [leg for leg in C.LEGS if leg not in own]
    return ("%sPER-LEG swing PD: %s%s"
            % (indent,
               "; ".join("%s Kp %s Kd %s" % (leg, kp[C.LEGS.index(leg)],
                                            kd[C.LEGS.index(leg)])
                         for leg in own),
               "; %s as above" % " ".join(rest) if rest else ""))


def main(argv=None, crouch: POSE.CrouchPose = POSE.NOMINAL,
         dynamic_setpoint: bool = None, only_law: str = None,
         roll_gains: tuple = None,
         track_stop: float = None, gait=None, tau_cap: float = None,
         tau_ceiling: float = None, tau_slew: float = None,
         overspeed_trip: bool = True, step_to=None,
         step_period: float = None, swing: str = "cartesian",
         swing_height: float = None,
         velocity: bool = False, estimator=None, hook=None,
         terse: bool = False, limits: bool = True,
         rise_track: bool = False, height: float = None,
         stand_xy=None, slide_from: float = None,
         est_xy: bool = None, alloc: str = "qp", qp_s=None,
         fall_hold: float = None, kp_joint: float = None,
         kp_joint_abd: float = None, kp_rise: float = None) -> int:
    """The runner.  `crouch` is the posture the lift starts from and PARK
    returns to; `dynamic_setpoint` None defers to `config.SETPOINT_DYNAMIC`;
    `only_law` pins the lift law and drops `--law` from the parser.

    `limits` False is `--no-limits` by default: every limit on WHERE the
    robot goes is off -- the soft joint limits (the gate's torque block and
    its e-stop), the position-mode tracking trips, the torque-phase tracking
    trip, the residual trip and the overspeed trip.  What stays on is
    `NO_LIMITS_KEPT`.  There is no tilt stop to turn off: it is deleted.

    `gait` (a `balance.gait.TrotGait`) enables T; `tau_cap`, `tau_ceiling`
    and `tau_slew` are the gate's default cap, the ceiling it will accept and
    its slew -- None keeps the stand's.  `overspeed_trip` False keeps the
    joint-speed peaks and stops nothing on them (`safety.SafetyGate`).
    `step_to` ((4, 2) hip-frame foot xy, needs `gait`) enables W: the hold
    steps the feet there, and steps them back before the park, on its own
    gait clock of `step_period` seconds (None: the trot's).
    `swing_height` (m) is `--swing-height`'s default; None is
    `config.SWING_HEIGHT`.
    `swing` is `law.BalanceLaw.swing`: "joint" is the z-only joint PD the
    fold trot flew until 2026-09-28; every trot entry point now takes the
    default "cartesian".
    `hook` is an extra operator layer (`hw.sway.Sway`): its keys, a veto on
    ENTER, a call every sweep before the law, and lines for the banner and
    the status.  It turns the joint-space layer's flags on without a gait.
    `velocity` True prints `hw.velocity_estimator`'s v under every status
    line, every phase (needs the IMU; `--no-imu` has nothing to integrate).
    `estimator` is a CALLABLE taking the live `ImuDog` (or None on the
    `--no-imu` path) and returning a tap (see `run`), or None.  A factory
    rather than an object because the IMU is opened in here, after the caller
    is done: `hw.trot_esti` passes a class.
    `terse` is `run`'s: the 2 Hz stream carries the phase's rpy line and the
    taps, and nothing else.
    `rise_track` is `--rise-track`'s default: the joint-space layer holds
    the legs on the IK reference through the rise, before HOLD latches the
    measured pose (`law.BalanceLaw.rise_track`).  `hw.fold_trot` passes
    True; it needs the layer, so it means nothing without a gait or hook.
    `height` (m) is `--height`'s default; None is `config.H_LIFT`.
    `stand_xy` ((4, 2) hip-frame foot xy) with `slide_from` (m) is the
    SLANTED RISE (`law.BalanceLaw.stand_xy`): the stand's feet differ from
    the crouch's and the tracked layer carries the trunk over the planted
    feet as the commanded height passes `slide_from`.  `hw.fold_trot`.
    `est_xy` is `--est-xy`'s default -- THE ESTIMATOR IN THE LOOP
    (`law.BalanceLaw.est_xy`): the hold's and the trot's x/y rows close on
    the state estimator, `--kp-xy` / `--kd-xy`.  None is no loop and no flag (a stand
    with no trot).  Every trot passes True through `trot.trot_options`
    (2026-10-02).  It needs a gait and an `estimator` whose objects also have
    `estimate()` (`hw.trot_esti.EstimatorFeed`); with the loop on `run` is
    called with `feed`, and with `--no-est-xy` the filter only prints.
    `alloc` is `--alloc`'s default, every entry point, every phase the SRB
    law drives: "qp" (`hw.balance.qp`, the friction pyramid and the contact
    box inside the problem -- the default since 2026-10-04, on request), or
    "wls" (`allocation.allocate`, the least squares with the cone clipped on
    afterwards, which every run flew until then).  `qp_s` is `--qp-s`'s
    default, the QP's S diagonal (None: config.QP_S).  A hook with
    `law_kwargs(args)` hands the law more keyword arguments --
    `hw.fold_walk`'s walk plan.
    `fall_hold` (deg) is `--fall-hold`'s default, THE FALL HOLD
    (`law.BalanceLaw.fall_hold_deg`): every trot passes
    `config.FALL_HOLD_DEG` through `trot.trot_options`; None is off, the
    stands' default -- on their 5 N*m/s slew it whirls the legs, and
    `--fall-hold` is refused below `config.FALL_HOLD_MIN_SLEW_NM_S`.

    They are arguments rather than flags-only so that `hw.fold_stand` is three
    lines instead of a copy of this parser.
    """
    ap = argparse.ArgumentParser(
        description=__doc__.splitlines()[0],
        formatter_class=argparse.ArgumentDefaultsHelpFormatter)
    ceiling = SAFE.TAU_STAGED_MAX if tau_ceiling is None else float(tau_ceiling)
    slew = SAFE.DEFAULT_TAU_SLEW_NM_S if tau_slew is None else float(tau_slew)
    ap.add_argument("--tau-cap", type=float,
                    default=SAFE.TAU_START_MAX if tau_cap is None else tau_cap,
                    help="lift-phase torque cap, N*m (SafetyGate allows up to "
                         "%.1f)" % ceiling)
    ap.add_argument("--tau-slew", type=float, default=slew, metavar="NM_PER_S",
                    help="SafetyGate's |dtau/dt| limit on every joint.  The "
                         "stand's 5 and the trot's 60 are DOG5's; it bounds "
                         "how fast a swing torque can rise, so the trot "
                         "banner prints what the swing needs against it")
    ap.add_argument("--rate", type=float, default=RATE_HZ,
                    help="per-motor command rate, Hz")
    ap.add_argument("--bitrate", type=int, default=1_000_000)
    ap.add_argument("--arm-timeout", type=float, default=30.0)
    ap.add_argument("--unconfirmed", default=None, metavar="WHY",
                    help="run although hw.CONFIRMED_ON_DOG6 is False")
    ap.add_argument("--fake", action="store_true",
                    help="hw.fake_bus instead of can0: protocol only, no "
                         "dynamics")
    ap.add_argument("--auto", type=float, default=None, metavar="SECONDS",
                    help="advance phases by themselves, SECONDS after each "
                         "ramp arrives (--fake only)")
    ap.add_argument("--script", default=None, metavar="FILE",
                    help="the operator's keys from a file, on the phase clock "
                         "(hw.script): T, the walk's keys, SPACE and ENTER at "
                         "scheduled seconds after each phase is entered, the "
                         "same in every run.  Stand it up with ENTER; from "
                         "the script's first press, any key pressed by hand "
                         "cancels the rest.  Beside --auto (--fake) the position "
                         "phases still step by themselves and the script owns "
                         "HOLD and the trot")

    law = ap.add_argument_group(
        "the lift law",
        "`srb` is the balance controller of hw.balance; `per-leg` is the "
        "Cartesian compliance law it replaces, kept as the A/B baseline."
        if only_law is None else
        "pinned to `%s` by this entry point." % only_law)
    if only_law is None:
        law.add_argument("--law", choices=LAWS, default="srb",
                         help="which law drives the lift phase")
    else:
        ap.set_defaults(law=only_law)
    law.add_argument("--rise", type=float, default=BCFG.T_RISE,
                     metavar="SECONDS",
                     help="S-curve duration; the only knob the reference has")
    law.add_argument("--height", type=float,
                     default=1e3 * (BCFG.H_LIFT if height is None else height),
                     metavar="MM",
                     help="lift target, mm FLOOR TO TRUNK BOTTOM (the ruler's "
                          "number, not the code's trunk-origin frame)")
    law.add_argument("--kp-z", type=float, default=BCFG.KP_Z)
    law.add_argument("--kd-z", type=float, default=BCFG.KD_Z)
    law.add_argument("--kp-att", type=float, default=BCFG.KP_ATT)
    law.add_argument("--kd-att", type=float, default=BCFG.KD_ATT)
    law.add_argument("--kp-yaw", type=float, default=BCFG.KP_YAW,
                     help="HEADING spring, same units as --kp-att.  It holds "
                          "the drift off the heading latched at the handover; "
                          "0 is the damper-only yaw of before 2026-09-24")
    law.add_argument("--kd-yaw", type=float, default=BCFG.KD_YAW,
                     help="heading damper, same units as --kd-att -- the "
                          "gyro's omega_z, inertial, on even at --kp-yaw 0")
    law.add_argument("--kp-roll", type=float,
                     default=None if roll_gains is None else roll_gains[0],
                     help="roll only, same units as --kp-att; default follows "
                          "--kp-att")
    law.add_argument("--kd-roll", type=float,
                     default=None if roll_gains is None else roll_gains[1],
                     help="roll only, same units as --kd-att; default follows "
                          "--kd-att")
    law.add_argument("--mu", type=float, default=BCFG.MU,
                     help="friction coefficient of the allocator's cone (the "
                          "QP's pyramid, or the round cone the least squares "
                          "projects onto); it bounds what is asked for, not "
                          "what the floor gives")
    law.add_argument("--com-offset", type=float, nargs=2, default=[0.0, 0.0],
                     metavar=("DX_MM", "DY_MM"),
                     help="the MEASURED offset of the built robot's CoM from "
                          "the CAD's, trunk x / y, mm (hw.com_check reads it "
                          "off a HOLD log).  Shifts the SRB pin by it AND the "
                          "stance the other way, so the trunk stands over "
                          "the real CoM.  In MuJoCo a 3 / 5 mm error alone "
                          "turns the trot in place into a roll that grows "
                          "for 30 s and fells every walk within 5 s; the pin "
                          "alone does not cure it, the stance does "
                          "(2026-10-05)")
    law.add_argument("--com-auto", dest="com_auto", action="store_true",
                     default=None,
                     help="MEASURE THE CoM IN EVERY HOLD AND APPLY IT AT T "
                          "(the default on every trot that tracks its rise): "
                          "each HOLD reads it off the drivers' measured "
                          "torques (hw.com_check's statics), and T moves the "
                          "pin and the stance sites by measured - pinned, "
                          "slides the trunk over the planted feet onto it "
                          "for %.1f s, then starts the trot.  The log's "
                          "com_meas / com_pin columns carry it.  2026-10-06"
                          % BCFG.COM_SLIDE_S)
    law.add_argument("--no-com-auto", dest="com_auto", action="store_false",
                     help="T starts the trot on the pin there is, as before "
                          "2026-10-06")
    law.add_argument("--alloc", choices=("qp", "wls"), default=alloc,
                     help="the force allocator, every phase the SRB law "
                          "drives: 'qp' (default) the friction pyramid and "
                          "the contact box INSIDE the problem, so the wrench "
                          "delivered is the closest the cone can make "
                          "(hw.balance.qp); 'wls' the least squares, the cone "
                          "clipped on afterwards (every run until 2026-10-04)")
    law.add_argument("--qp-s", type=float, nargs=6,
                     default=[float(s) for s in
                              (BCFG.QP_S if qp_s is None else qp_s)],
                     metavar=("FX", "FY", "FZ", "MX", "MY", "MZ"),
                     help="the QP's wrench weights S, world (Fx, Fy, Fz, "
                          "roll, pitch, yaw); a larger one is given up "
                          "later where the cone or the fz box binds, and "
                          "on a diagonal pair, which cannot make the moment "
                          "about its own line, on every sweep.  Default "
                          "config.QP_S (all 1); hw.fold2_walk's is "
                          "QP_S_FOLD2_WALK (1 1 10 20 1 1)")
    law.add_argument("--ablate-attitude", action="store_true",
                     help="zero both attitude gains -- the other half of the "
                          "A/B.  Height loop and gravity only; the trunk will "
                          "NOT push back")
    law.add_argument("--fall-hold", type=float,
                     default=0.0 if fall_hold is None else float(fall_hold),
                     metavar="DEG",
                     help="THE FALL HOLD: past this many degrees FROM THE "
                          "SETPOINT the balance law, the swing and the trot "
                          "stop and every joint is held at the stand in joint "
                          "space; the run goes on until ENTER parks.  There "
                          "is no tilt e-stop (deleted), so 0 -- off -- means "
                          "nothing acts on a tilt.  Not a limit: --no-limits "
                          "leaves it on.  Needs --tau-slew %.0f or more"
                          % BCFG.FALL_HOLD_MIN_SLEW_NM_S)
    law.add_argument("--kp-fall", type=float, default=BCFG.KP_FALL_HOLD,
                     metavar="NM_PER_RAD",
                     help="the fall hold's joint stiffness, every joint, on "
                          "top of the leg's own weight.  STIFFER IS WORSE "
                          "behind the slew: in MuJoCo 10 whirled the legs in "
                          "2 of 8 falls and 30 in all 3 tried "
                          "(config.KP_FALL_HOLD)")
    law.add_argument("--kd-fall", type=float, default=BCFG.KD_FALL_HOLD,
                     metavar="NMS_PER_RAD", help="the fall hold's joint damping")
    law.add_argument("--track-stop", type=float,
                     default=(np.rad2deg(BCFG.TRACK_STOP_RAD) if track_stop is None
                              else track_stop), metavar="DEG",
                     help="e-stop when any joint is this far from the IK at "
                          "the commanded height; 0 turns it OFF.  A MONITOR "
                          "ONLY -- the SRB torque never reads that IK, so "
                          "this changes no N*m the drivers get.  It is what "
                          "notices a leg that has gone wrong while the "
                          "attitude still reads fine")
    lim = ap.add_argument_group(
        "limits", "every limit on where the robot goes, as one switch")
    lim.add_argument("--limits", dest="limits", action="store_true",
                     default=bool(limits),
                     help="ON: the soft joint limits (the gate's torque block "
                          "and e-stop), the position-mode and torque-phase "
                          "tracking trips, the residual trip and the "
                          "overspeed trip -- at the flags above")
    lim.add_argument("--no-limits", dest="limits", action="store_false",
                     default=argparse.SUPPRESS,
                     help="all of those OFF, whatever the flags above say.  "
                          "Still on: %s" % NO_LIMITS_KEPT)
    if gait is not None:
        trot = ap.add_argument_group(
            "the trot", "the gait clock T starts; the entry point's defaults")
        trot.add_argument("--period", type=float, default=gait.period,
                          metavar="SECONDS",
                          help="one full gait cycle.  Shorter = faster "
                               "handovers, AND a faster swing: the knee's peak "
                               "speed and the handover torque rate scale as "
                               "1/period")
        trot.add_argument("--duty", type=float, default=gait.duty,
                          help="stance fraction, in [0.5, 1); 0.5 only with "
                               "--contact-ramp 0 --settle 0 (no four-foot "
                               "window: the load steps across, and T leaves "
                               "the trot at a handover)")
        trot.add_argument("--contact-ramp", type=float, default=gait.ramp,
                          metavar="FRACTION",
                          help="fraction of STANCE a foot's share of the load "
                               "smoothsteps over at touchdown and at liftoff.  "
                               "It has to fit inside the four-foot window, so "
                               "the ceiling is (duty - 0.5) / (2 duty) = 0.19 "
                               "at duty 0.80; past it the clock refuses and "
                               "says so.  0 is none: the weight steps 0/1")
        trot.add_argument("--settle", type=float, default=gait.settle_s,
                          metavar="SECONDS",
                          help="the four-foot re-level; 0 turns it off")
        trot.add_argument("--settle-every", type=int,
                          default=gait.settle_every, metavar="CYCLES")
        trot.add_argument("--swing", choices=BSWING.SWING_MODES, default=swing,
                          help="the swing leg's controller: 'cartesian' is "
                               "the foot impedance the nominal trot flies -- "
                               "soft (~1 Hz at the foot), so pair it with "
                               "--swing-ff; 'joint' is the z-only arc "
                               "through the IK with a joint PD, abd held -- "
                               "on the nominal trot it failed every run "
                               "(2026-09-25), and the fold trot on it had "
                               "the swing leg rush (2026-09-28)")
        trot.add_argument("--swing-height", type=float,
                          default=1e3 * (BCFG.SWING_HEIGHT if swing_height is None
                                         else swing_height), metavar="MM",
                          help="the swing apex above the resting foot.  Speed, "
                               "torque and slew demand all scale with it, so "
                               "it is the first thing to lower for a fast "
                               "gait; the banner prints the demand.  With "
                               "--swing-ff the apex is real: 20 mm flew on "
                               "the nominal trot, 40 mm landed hard enough to "
                               "bounce the robot (2026-09-25)")
        trot.add_argument("--swing-roll", dest="swing_roll",
                          action="store_true", default=None,
                          help="level the Cartesian swing arc in ROLL (the "
                               "trunk's roll from level, IMU), so the foot "
                               "lands on the floor whatever the roll.  The "
                               "joint-hold latch stays HOLD's "
                               "(law.BalanceLaw.swing_roll).  DEFAULT ON for "
                               "--swing cartesian since 2026-10-07 (on "
                               "request); the joint/knee swings stay off.  "
                               "The walks' swing (fold_walk.WalkHook) does "
                               "not read it")
        trot.add_argument("--no-swing-roll", dest="swing_roll",
                          action="store_false",
                          help="the arc in the trunk frame, tilting with it "
                               "(every trot before 2026-10-07)")
        trot.add_argument("--swing-ff", action="store_true",
                          help="add the arc's own inertial torque, M0 J^+ "
                               "(a_ref - Jdot qd_ref), to each swing leg open "
                               "loop (both swing modes).  It is ~90 %% of the "
                               "torque a 15 mm / 140 ms arc asks for, which "
                               "the PD was making out of tracking error; see "
                               "swing.py.  Logged as tau_ff")
        trot.add_argument("--ff-armature", type=float, default=None, metavar="KG_M2",
                          help="the reflected rotor inertia the feedforward's M0 "
                               "is built on, joint side.  Default params.ARMATURE "
                               "%.4f, DOG5's, not measured on DOG6; "
                               "`hw.swing_bench --analyse` fits it from a log"
                               % P.ARMATURE)
        trot.add_argument("--ff-scale", type=float, default=1.0, metavar="K",
                          help="the feedforward's whole M0 times K (doc/swing_hw "
                               "section 7 proposes 0.35).  Under --swing-ff it "
                               "scales tau_ff only; under --swing-law osc M0 is "
                               "the law's gain, so the PD too")
        trot.add_argument("--kp-swing", type=float, nargs=3, metavar="N_PER_M",
                          default=list(BCFG.KP_SWING),
                          help="the Cartesian swing PD's x y z stiffness.  The "
                               "default is the operator's best fold trot, "
                               "2026-10-02 (config.KP_SWING); DOG5's was 140 "
                               "140 180.  With --swing-ff, stiffening z drives "
                               "the foot into x (no Lambda in this PD)")
        trot.add_argument("--kd-swing", type=float, nargs=3,
                          metavar="NS_PER_M", default=list(BCFG.KD_SWING),
                          help="the Cartesian swing PD's x y z damping.  The "
                               "default is the operator's best fold trot, "
                               "2026-10-02 (config.KD_SWING); DOG5's was 8 8 "
                               "15")
        add_swing_leg_flags(trot)
        trot.add_argument("--kp-swing-knee", type=float, nargs=3,
                          metavar="NM_PER_RAD", default=list(BCFG.KP_SWING_KNEE),
                          help="--swing knee's joint PD, abd pitch knee: abd "
                               "and pitch held at liftoff, the knee on its "
                               "bump (config.KP_SWING_KNEE)")
        trot.add_argument("--kd-swing-knee", type=float, nargs=3,
                          metavar="NMS_PER_RAD", default=list(BCFG.KD_SWING_KNEE))
        trot.add_argument("--half-gait", action="store_true",
                          help="T steps the gait by HAND, half a cycle a "
                               "press: one diagonal lifts and lands, HOLD by "
                               "itself, and the next T swings the other one")
        if step_to is not None:
            trot.add_argument("--step-period", type=float,
                              default=(gait.period if step_period is None
                                       else step_period), metavar="SECONDS",
                              help="the gait cycle W steps the feet on.  The "
                                   "foot crosses the whole step in one swing, "
                                   "so this sets the joint speeds of the step")
    if gait is not None or hook is not None:
        joint = ap.add_argument_group(
            "the joint-space layer", "DOG5's JointImpedance, from HOLD on")
        joint.add_argument("--joint-hold", dest="joint_hold",
                           action="store_true", default=True,
                           help="MODE: the joint angles on reaching HOLD are "
                                "the joint-space target -- trunk position and "
                                "rpy pinned by the legs")
        joint.add_argument("--no-joint-hold", dest="joint_hold",
                           action="store_false", default=argparse.SUPPRESS,
                           help="MODE: the SRB law alone, no joint target -- "
                                "height and rpy held, the body free to shift "
                                "under a push")
        joint.add_argument("--kp-joint", type=float,
                           default=(BCFG.KP_JOINT_HOLD if kp_joint is None
                                    else kp_joint), metavar="NM_PER_RAD",
                           help="the joint-space layer: every leg held at the "
                                "joint angles latched on reaching HOLD, through "
                                "the hold and the trot (a swinging leg gets "
                                "none of it).  0 turns the spring off")
        joint.add_argument("--kd-joint", type=float,
                           default=BCFG.KD_JOINT_HOLD, metavar="NMS_PER_RAD")
        joint.add_argument("--kp-joint-abd", type=float,
                           default=(BCFG.KP_JOINT_HOLD_ABD if kp_joint_abd is None
                                    else kp_joint_abd), metavar="NM_PER_RAD",
                           help="the layer's gain on the ABDUCTION joints once "
                                "HOLD has latched (hold and trot); pitch and "
                                "knee keep --kp-joint, the tracked rise keeps "
                                "--kp-rise on all three")
        joint.add_argument("--kd-joint-abd", type=float,
                           default=BCFG.KD_JOINT_HOLD_ABD, metavar="NMS_PER_RAD")
        joint.add_argument("--kp-rise", type=float, default=kp_rise,
                           metavar="NM_PER_RAD",
                           help="the TRACKED RISE's spring (--rise-track), all "
                                "three joints, until HOLD latches.  Default: "
                                "follows --kp-joint, except the walks, which "
                                "keep %.1f while their stance is damping-only"
                                % BCFG.KP_JOINT_HOLD)
        joint.add_argument("--rise-track", dest="rise_track",
                           action="store_true", default=rise_track,
                           help="the layer holds the legs on the IK reference "
                                "(feet at the crouch's sites, the commanded "
                                "height) THROUGH THE RISE, until HOLD latches "
                                "the measured pose.  Nothing else holds trunk "
                                "x over the feet, and the parallel fold walks "
                                "forward without it (law.BalanceLaw.rise_track)")
        joint.add_argument("--no-rise-track", dest="rise_track",
                           action="store_false", default=argparse.SUPPRESS,
                           help="the rise on the SRB law alone, the layer from "
                                "HOLD on (as before 2026-10-01)")
    if est_xy is not None:
        loop = ap.add_argument_group(
            "the state estimator in the loop",
            "the hold's and the trot's CoM x/y and rate from the Kalman "
            "filter, held at the x/y latched as each HOLD and each trot starts "
            "(law.BalanceLaw.est_xy).  --kp-xy 0 --kd-xy 0 is the flown "
            "torque, filter printed")
        loop.add_argument("--est-xy", dest="est_xy", action="store_true",
                          default=bool(est_xy),
                          help="close the hold's and the trot's x/y on the "
                               "filter (every trot entry point's default "
                               "since 2026-10-02)")
        loop.add_argument("--no-est-xy", dest="est_xy", action="store_false",
                          default=argparse.SUPPRESS,
                          help="the filter printed, not fed: the x/y rows "
                               "zero, the hold and the trot as they were "
                               "before 2026-10-02")
        loop.add_argument("--kp-xy", type=float, default=BCFG.KP_XY_EST,
                          metavar="PER_S2",
                          help="x/y position gain, acceleration units like "
                               "--kp-z: the hold holds the CoM where the filter "
                               "had it on reaching HOLD, the trot where it had "
                               "it at T.  Hold and trot only")
        loop.add_argument("--kd-xy", type=float, default=BCFG.KD_XY_EST,
                          metavar="PER_S",
                          help="x/y velocity gain on the filter's v, like "
                               "--kd-z.  Hold and trot only")
    law.add_argument("--kp-stance-xy", type=float, default=0.0, metavar="N_PER_M",
                     help="a Cartesian spring on every PLANTED foot toward its "
                          "trunk-frame site, x and y only, per leg -- trunk xy "
                          "stiffness relative to the feet without the z the joint "
                          "layer adds.  0 is off.  400 on four feet is 1600 N/m "
                          "on the trunk, 2.6 Hz")
    law.add_argument("--kd-stance-xy", type=float, default=0.0, metavar="NS_PER_M",
                     help="its damping, per leg; ~25 is zeta 0.5 at 400 N/m")
    law.add_argument("--gravity-legs", type=int, default=4, choices=(1, 2, 4),
                     metavar="N", help="leg-gravity terms refreshed per sweep; "
                                       "4 removes the 12 ms cross-leg skew")

    # THE WAVE IS THE PLAIN STAND'S ONLY: `sim.wave` validated it from the
    # nominal stance at the default height, with no gait and no hook in the
    # hold it starts from.  Every other entry point flies without it.
    if (crouch is POSE.NOMINAL and gait is None and hook is None
            and step_to is None and stand_xy is None and height is None):
        wave = ap.add_argument_group(
            "the three-leg stance",
            "`--wave LEG` splices sim.wave's five phases after the hold: "
            "shift the trunk, unload and raise that paw, wave it, put it "
            "back, shift back.  ENTER from HOLD starts them.  Torque phases, "
            "sim.wave.ThreeLegStance on hw.kinematics, whatever --law lifted "
            "the robot.  `python -m sim.wave --check` first.")
        wave.add_argument("--wave", choices=C.LEGS, default=None,
                          metavar="LEG",
                          help="which paw leaves the floor (FL FR RL RR)")
    else:
        ap.set_defaults(wave=None)

    sensing = ap.add_argument_group("sensing and recording")
    sensing.add_argument("--imu-port", default=IMU.DEFAULT_PORT,
                         help="DETA10 serial port")
    sensing.add_argument("--no-imu", action="store_true",
                         help="assume a perfectly level trunk.  AN ABLATION: "
                              "the attitude error is then identically zero and "
                              "the SRB law degenerates to height + gravity")
    sensing.add_argument("--log", default=None, metavar="FILE.npz",
                         help="record every torque-mode sweep")
    datum = sensing.add_mutually_exclusive_group()
    datum.add_argument("--latch-setpoint", dest="latch", action="store_true",
                       default=None,
                       help="take the attitude setpoint at zero torque, in "
                            "LIMP -- 'level' becomes the attitude the robot "
                            "was resting at")
    datum.add_argument("--fixed-setpoint", dest="latch", action="store_false",
                       help="do NOT latch: fly config.SETPOINT_ROLL/PITCH_DEG. "
                            "A run comparing two postures wants this, or the "
                            "two are measured against two different 'level's")
    if hook is not None:
        hook.add_arguments(ap)
    args = ap.parse_args(argv)
    try:                                  # --ff-scale, refused before anything is built
        BSWING.feedforward_inertia(getattr(args, "ff_armature", None),
                                   getattr(args, "ff_scale", 1.0))
    except ValueError as refusal:
        ap.error(str(refusal))
    if hook is not None:
        try:
            hook.configure(args)
        except ValueError as refusal:     # the hook's own flags, refused
            ap.error(str(refusal))
    if args.latch is None:
        args.latch = (bool(BCFG.SETPOINT_DYNAMIC) if dynamic_setpoint is None
                      else bool(dynamic_setpoint))

    if est_xy is not None and (gait is None or estimator is None):
        ap.error("est_xy needs a gait (the trot entry points offer it) and "
                 "an estimator to feed it")
    #: The x/y loop, as this run flies it: offered by the entry point AND on.
    xy_loop = est_xy is not None and bool(args.est_xy)
    if xy_loop and not hasattr(estimator, "estimate"):
        ap.error("--est-xy needs an estimator with estimate() "
                 "(hw.trot_esti.EstimatorFeed)")
    if gait is not None:
        from .balance.gait import TrotGait
        try:
            gait = TrotGait(period=args.period, duty=args.duty,
                            offsets=gait.offsets, ramp=args.contact_ramp,
                            settle_s=args.settle,
                            settle_every=args.settle_every)
            step_gait = (None if step_to is None else TrotGait(
                period=args.step_period, duty=args.duty, offsets=gait.offsets,
                ramp=gait.ramp, settle_s=args.settle,
                settle_every=args.settle_every))
        except ValueError as refusal:
            ap.error("the gait: %s" % refusal)
    else:
        step_gait = None

    if args.auto is not None and not args.fake:
        ap.error("--auto is only allowed with --fake: on the robot a person "
                 "steps the phases")
    # THE SCRIPTED KEYS (hw.script), parsed before the bus opens so a bad
    # line refuses here and not mid-run.
    script = None
    if args.script:
        try:
            script = SCRIPT.KeyScript.load(args.script)
        except (OSError, ValueError) as refusal:
            ap.error("--script: %s" % refusal)
        if gait is None and script.presses("t"):
            ap.error("--script presses T, and this entry point has no trot")
        if hook is None and any(script.presses(ch) for ch in "wasdqe "):
            ap.error("--script presses the walk's keys, and this entry point "
                     "does not walk")
    if args.law == "per-leg" and not args.no_imu:
        # Not an error: the baseline reads no IMU by construction, and saying
        # so beats letting an operator think the A/B differs in two ways.
        args.no_imu = True
    if args.rate * 2 * STATUS_EVERY_SWEEPS < 1.0 / GAP_ESTOP_S:
        ap.error("--rate %.0f Hz cannot keep every motor inside the %.0f ms "
                 "stop line" % (args.rate, 1e3 * GAP_ESTOP_S))
    reason = args.unconfirmed or ("hw.fake_bus" if args.fake else None)

    # Everything that can refuse, refuses BEFORE the bus opens.
    ids = HM.motor_ids()
    slew = float(args.tau_slew)
    if gait is not None:
        swing = args.swing
        if args.swing_roll is None:          # on wherever it applies
            args.swing_roll = swing == "cartesian"
        if args.swing_roll and swing != "cartesian":
            ap.error("--swing-roll levels the Cartesian arc; --swing %s "
                     "latches its own at liftoff" % swing)
        kp_swing, kd_swing, own_swing = swing_leg_gains(args)
        if own_swing and swing != "cartesian":
            ap.error("--kp/--kd-swing-%s are the Cartesian swing's; --swing "
                     "%s swings on its own joint PD"
                     % (own_swing[0].lower(), swing))
        if own_swing and getattr(hook, "replaces_swing", False):
            ap.error("--kp/--kd-swing-%s are the trot's swing, and this entry "
                     "point's hook replaces it: the walk's own are "
                     "--kp/--kd-swing-walk-%s"
                     % (own_swing[0].lower(), own_swing[0].lower()))
    if args.fall_hold > 0.0 and slew < BCFG.FALL_HOLD_MIN_SLEW_NM_S:
        ap.error("--fall-hold on a %.0f N*m/s slew: a joint PD behind a slew "
                 "that slow limit-cycles -- in MuJoCo, hw.fold_stand pushed "
                 "over at 5 N*m/s, the legs whirled (670 deg off the stand); "
                 "at 60 and 120 they held.  Add --tau-slew %.0f or more, "
                 "knowing it is the stand's whole torque path, or leave the "
                 "fall hold off (config.FALL_HOLD_MIN_SLEW_NM_S)"
                 % (slew, BCFG.FALL_HOLD_MIN_SLEW_NM_S))
    if not args.limits:
        # --no-limits, `main`'s docstring.  Set before anything is built or
        # printed, so the banner reports what actually flies.
        args.track_stop = 0.0
        overspeed_trip = False
    try:
        gate = SAFE.SafetyGate(args.tau_cap, unconfirmed_reason=reason,
                               ceiling=ceiling, tau_slew=slew,
                               overspeed_trip=overspeed_trip,
                               limits=(None if args.limits else
                                       (np.full(C.N_JOINTS, -np.inf),
                                        np.full(C.N_JOINTS, np.inf))))
    except (RuntimeError, ValueError) as refusal:
        print("[stand] REFUSED before opening the bus:\n  %s" % refusal,
              file=sys.stderr)
        if not CONFIRMED_ON_DOG6 and reason is None:
            print('[stand] to run on the unconfirmed map anyway: '
                  '--unconfirmed "why"', file=sys.stderr)
        return 2
    gains = BCTRL.BalanceGains()
    gains.kp_pos[2], gains.kd_pos[2] = args.kp_z, args.kd_z
    gains.kp_att[0] = gains.kp_att[1] = args.kp_att
    gains.kd_att[0] = gains.kd_att[1] = args.kd_att
    if args.kp_roll is not None:
        gains.kp_att[0] = args.kp_roll
    if args.kd_roll is not None:
        gains.kd_att[0] = args.kd_roll
    gains.kp_att[2], gains.kd_att[2] = args.kp_yaw, args.kd_yaw
    if xy_loop:
        # Read only in the hold and the trot, and only off a usable estimate
        # -- the law's `est_xy`.  Every other sweep the x/y rows stay zero.
        gains.kp_pos[:2] = args.kp_xy
        gains.kd_pos[:2] = args.kd_xy
    if args.ablate_attitude:
        gains.ablate_attitude()
    # THE PIN FOLLOWS --height (posture.CrouchPose.srb_at): at the default it
    # is the posture's `srb`, the same object.  With a slanted rise it is
    # pinned at the STAND's feet -- the stance the hold will hold.
    layer_on = ((gait is not None or hook is not None) and args.joint_hold
                and args.rise_track)
    slide = stand_xy is not None and layer_on
    if stand_xy is not None and not slide:
        print("  NOTE: the stand's own foot sites need the tracked joint layer "
              "(--rise-track with the layer on); without it the rise is "
              "straight, on the crouch's feet")
    # THE CoM MEASURED IN EVERY HOLD AND APPLIED AT T (sequence.py): on by
    # default wherever it can run -- a trot to apply it at, the SRB law's pin
    # to move, the tracked layer with a spring to slide the trunk with, and
    # a HOLD held by the joint spring (`--kp-joint` > 0), which is what makes
    # the drivers' torque carry the load: in MuJoCo with 0.1 N*m of joint
    # friction a sprung HOLD read the CoM within 0.4 mm, a damping-only one
    # 3-4 mm off (stiction carried the rest) and the walk then fell.
    com_able = (gait is not None and args.law == "srb" and layer_on
                and args.kp_joint > 0.0
                and (args.kp_joint if args.kp_rise is None
                     else args.kp_rise) > 0.0)
    if args.com_auto is None:
        args.com_auto = com_able
    elif args.com_auto and not com_able:
        ap.error("--com-auto needs a trot (T), the SRB law, the tracked "
                 "joint layer with a spring (--rise-track, the layer on, "
                 "--kp-rise > 0) to slide the trunk over the planted feet, "
                 "and a HOLD held by the joint spring (--kp-joint > 0): in a "
                 "damping-only HOLD stiction carries part of the load and the "
                 "drivers' torque misreads the CoM (MuJoCo: 3-4 mm off)")
    if any(args.com_offset):
        # THE STANCE RE-CENTRED ON THE REAL CoM: the stand's sites move WITH
        # the offset, so both trot diagonals pass where the real CoM is.  In
        # MuJoCo the pin alone bought almost nothing (a 3 / 5 mm plant error:
        # hw.fold_trot in place 9.7 -> 7.9 deg, still growing); the trunk
        # rocks about whichever diagonal the real CoM is further from, and
        # no model fixes geometry.  doc/walk/README.md section 11.
        shift = 1e-3 * np.asarray(args.com_offset, dtype=float)
        if slide:
            stand_xy = np.asarray(stand_xy, float) + shift[None, :]
        else:
            feet = np.zeros((C.N_LEGS, 3))
            feet[:, :2] = np.asarray(crouch.foot_xy, float) + shift[None, :]
            feet[:, 2] = P.FOOT_RADIUS - crouch.z_origin
            crouch = POSE.CrouchPose.from_hip_sites(
                crouch.name, feet, q_seed=crouch.q, note=crouch.note)
    srb = crouch.srb_at(1e-3 * args.height,
                        np.asarray(stand_xy, float) if slide else None)
    if any(args.com_offset):
        # ONE object, shifted once, before anything reads it: `state.read`
        # and the law must share it or the CoM offset stops cancelling out
        # of the height error (config.SrbModel).
        com = np.array(srb.com_body, dtype=float)
        com[:2] += 1e-3 * np.asarray(args.com_offset, dtype=float)
        com.flags.writeable = False
        srb = dataclasses.replace(
            srb, name="%s, CoM %+.1f/%+.1f mm" % (srb.name, *args.com_offset),
            com_body=com)
    knee_plan = None
    if gait is not None and swing == "knee":
        # THE KNEE SWING'S PLAN AT THE HOLD, BEFORE THE BUS OPENS: every leg
        # must be able to swing toward the CoM to the apex (swing.py, "THE
        # KNEE SWING").  The law re-plans at each liftoff from the measured
        # joints; this is the hold it will lift from.
        if step_to is not None:
            ap.error("--swing knee lands each foot where it lifted; this "
                     "entry point's W step needs the Cartesian swing")
        q_stand = BLAW.ik_reference(1e-3 * args.height, crouch.q,
                                    np.asarray(stand_xy, float) if slide
                                    else crouch.foot_xy)
        knee_plan = []
        for leg in range(C.N_LEGS):
            try:
                knee_plan.append(BSWING.knee_swing_demand(
                    leg, q_stand[leg], gait.swing_duration,
                    1e-3 * args.swing_height))
            except ValueError as refusal:
                ap.error("--swing knee at this hold: %s" % refusal)
        if knee_plan[0]["slew"] > slew:
            # THE BUMP'S TORQUE RATE PAST THE GATE'S SLEW: the PD winds up
            # behind the limiter and the knee flies past the apex (MuJoCo,
            # swing.knee_swing_demand).  The shortest swing that fits: T^3.
            t_fit = gait.swing_duration * (knee_plan[0]["slew"] / slew) ** (1 / 3)
            ap.error("--swing knee: the knee bump asks ~%.0f N*m/s of torque "
                     "rate in %.0f ms of swing, the gate allows %.0f "
                     "(--tau-slew).  In MuJoCo the knee then overshoots: at "
                     "0.6 s a 20 mm apex came out 85-99 mm.  Lengthen --period "
                     "to %.2f s or more (%.0f ms of swing; 1.2 s is what "
                     "tracked in MuJoCo at 20 mm), lower --swing-height, or "
                     "raise --tau-slew knowing what it is"
                     % (knee_plan[0]["slew"], 1e3 * gait.swing_duration, slew,
                        t_fit / (1.0 - gait.duty), 1e3 * t_fit))
    balance = BLAW.BalanceLaw(gains=gains, rise_s=args.rise,
                              h_lift=1e-3 * args.height,
                              gravity_legs_per_sweep=args.gravity_legs,
                              mu=args.mu, foot_xy=crouch.foot_xy,
                              dynamic_setpoint=args.latch,
                              fall_hold_deg=(args.fall_hold
                                             if args.fall_hold > 0.0 else None),
                              kp_fall=args.kp_fall, kd_fall=args.kd_fall,
                              track_stop_deg=args.track_stop,
                              residual_trip=args.limits, srb=srb,
                              swing=swing,
                              swing_height=(1e-3 * args.swing_height
                                            if gait is not None
                                            else BCFG.SWING_HEIGHT),
                              swing_ff=bool(gait is not None and args.swing_ff),
                              swing_roll=bool(gait is not None
                                              and args.swing_roll),
                              kp_stance_xy=args.kp_stance_xy,
                              kd_stance_xy=args.kd_stance_xy,
                              ff_inertia=(None if gait is None
                                          else BSWING.feedforward_inertia(args.ff_armature,
                                                                          args.ff_scale)),
                              **({} if gait is None else dict(
                                  kp_swing=kp_swing, kd_swing=kd_swing,
                                  kp_swing_knee=np.asarray(args.kp_swing_knee,
                                                           float),
                                  kd_swing_knee=np.asarray(args.kd_swing_knee,
                                                           float))),
                              **({} if (gait is None and hook is None)
                                 or not args.joint_hold
                                 else dict(kp_joint=args.kp_joint,
                                           kd_joint=args.kd_joint,
                                           kp_joint_abd=args.kp_joint_abd,
                                           kd_joint_abd=args.kd_joint_abd,
                                           kp_rise=args.kp_rise,
                                           rise_track=args.rise_track)),
                              **({} if not slide else dict(
                                  stand_xy=np.asarray(stand_xy, float),
                                  slide_from_h=slide_from)),
                              alloc=args.alloc,
                              qp_s=np.asarray(args.qp_s, dtype=float),
                              **({} if hook is None
                                 or not hasattr(hook, "law_kwargs")
                                 else hook.law_kwargs(args)),
                              est_xy=xy_loop)
    stand = StandSequence(gate, law=args.law, balance=balance, crouch=crouch,
                          gait=gait, step_to=step_to, step_gait=step_gait,
                          trot_swings=(1 if gait is not None and args.half_gait
                                       else 0),
                          position_trips=args.limits, wave=args.wave,
                          # The wave shifts over, and splits the load about,
                          # the same CoM the SRB pin was moved to.
                          wave_com_xy=(WV.COM_XY_LIFT
                                       + 1e-3 * np.asarray(args.com_offset,
                                                           dtype=float)),
                          com_auto=args.com_auto)
    log = StandLog() if args.log else None
    key = KeyPoller()
    if not key.ok and not args.fake:
        print("[stand] stdin is not a terminal, so neither ENTER nor the X "
              "e-stop can reach this process.  Run it from a shell.",
              file=sys.stderr)
        return 2
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
