snowyfoams/dog6/hw/trot_esti.py

"""`hw.trot`, with `hw.state_estimator` READ OUT beside it, and in the x/y of
its hold and its trot.

    V=/home/robot01/Documents/can_motor_control/.venv/bin/python
    $V -m hw.trot_esti --fake --auto 1 --no-imu      the whole path, no robot
    $V -m hw.trot_esti                               on the robot
    $V -m hw.trot_esti --log trot_esti.npz           (the log is `hw.trot`'s,
                                                      p_est / v_est / xy_des
                                                      with the loop on)
    $V -m hw.trot_esti --no-est-xy                   print only, as it was

EVERY TROT CLOSES ITS x/y ON THIS FILTER SINCE 2026-10-02, ON REQUEST, AND
ITS HOLD DOES TOO (the same day, on request).  `EstimatorFeed` below -- what `hw.fully_trot` flew first -- is in
`trot.trot_options`, so `--est-xy` is every trot's default and `--no-est-xy`
is the print-only tap the sections below describe.  `hw.fully_trot`'s
docstring has the loop's account and what MuJoCo said it is worth.

THE TROT IS `hw.trot`'S, UNCHANGED, AND IT IS IMPORTED RATHER THAN COPIED.
Every constant, gain, trip, crouch and key comes from that module -- see its
docstring for all of it.  The only thing this file adds is `EstimatorTap`:
MIT's linear KF (`hw.state_estimator`) fed from the same sweep's sensors the
balance law is fed from, and printed.

NOTHING READS WHAT IT PRINTS, AND THAT IS THE EXPERIMENT
    The estimator is OUTSIDE the control loop.  `stand.run` LATCHES the sweep's
    `BodyState` and `TrunkOrientation` where the law is given them, hands the
    tap that pair in a CAN slot of its own (below), and throws the result away
    -- the law is fed by `stand.update(now, body)` alone, exactly as under
    `hw.trot`.  So this run produces the same torques as that one and can be
    compared against it sweep for sweep.

    The first question about a new estimator is not "does it stabilise the
    robot", it is "does it agree with what is already measured".  Height is
    where it can be checked: `hw.balance.state` reports the trunk height from
    the legs and the IMU, the filter reports it from the accelerometer and the
    legs, and the two are printed side by side in every phase.  A frame error
    shows up as a standing gap, a sign error as a gap that grows with tilt,
    and a bad datum as a constant 15 mm.

    A tap must not be able to end a run.  Any exception inside it disables it,
    prints why, and the trot goes on.

WHAT IT PRINTS, AND WHAT IT SILENCES
    THE STREAM IS THE FILTER'S AND THE TRUNK'S ATTITUDE, NOTHING ELSE.  This
    run is read to decide whether an estimate is true, so it asks `stand.run`
    for `terse`: the 2 Hz stream keeps the phase's own rpy line and these two,
    and drops the weight, moment, torque, |tau|, gap and overrun lines an
    operator watching the LAW wants.  The accelerometer-only `VelocityTap` is
    off with them -- the filter's v is the same quantity, measured better.
    Every trip, every phase banner and every exit report is untouched.

        trot   t= 12.3  rpy  +0.41/ -0.88/  -7.20   err ...   h  145.1 mm
        est h  145.3 mm (fk  145.1, d  +0.2)  v (+0.012, -0.003, +0.001) m/s
            xy (+0.021, -0.004) m  yaw   -7.2 deg  trust 1.00/...  innov ...

    h      the filter's trunk height, FLOOR TO TRUNK BOTTOM -- `hw.stand`'s
           convention, so it is the same number as the `h` on the line above.
           `fk` is that line's, from the legs; `d` is filter minus legs.
    v      trunk velocity in the run's world frame, m/s.  `vz fk` beside it is
           `BodyState.zdot_origin`, the height rate the law damps with, which
           is the only component of v anything else in `hw` measures.
    xy     the filter's world x and y: LEG ODOMETRY.  Unobservable, drifts,
           and printed so the drift is visible rather than surprising.
    yaw    the trunk's heading DRIFT off the run's world x axis, degrees --
           the same number as the third field of the `rpy` line above.  It is
           here because xy cannot be read without it; see below.
    trust  tau per leg, FL FR RL RR: 1 planted and believed, 0 in the air.
    innov  y - C x_pre, the largest row of each block -- position, velocity,
           foot height.  This is the number that says the filter and the legs
           disagree, and it is where a frame error appears first.
    acc    the 0x40 packet's own age.  It is a DIFFERENT packet from the
           attitude, on a different clock, so it is aged separately.

    And on entering every phase, one `estimator, <phase>:` line with the same
    fields -- the per-phase reading this file exists for.  Leaving a trot adds
    one more, the yaw and the xy the trot itself moved:

        trot yaw  -0.3 -> -7.2 deg (d -6.9) off the latched heading;
            xy moved (+0.031, -0.055) m, |d| 0.063 over 18.4 s

WHAT ZEROES YAW, AND WHY THE TROT'S IS PRINTED
    ONE THING ZEROES IT, ONCE.  `law.BalanceLaw.arm` latches `yaw_offset` from
    the heading measured at the crouch -> rise handover and `state.rezero_yaw`
    puts every reading after it in that frame, so the yaw printed here is
    drift off that one heading.  NOTHING ELSE TOUCHES IT: starting a trot does
    not, latching its exit does not, and this tap does not -- `yaw_offset` is
    also the law's heading SETPOINT (`arm` builds `R_des` from it), so
    re-zeroing it mid-run would move where the attitude loop is pulling the
    trunk.  That is a control change, and a read-out does not get to make one.

    WHAT DOES ACT ON IT IS `config.KP_YAW`, ON SINCE 2026-09-24 BECAUSE OF
    THAT LATCH.  The heading spring holds the drift printed here at 25 /s^2,
    0.80 Hz, critically damped, and these lines are its report card: the
    `trot yaw` line below is the number to read before and after `--kp-yaw 0`,
    which is the trot as it ran with the damper alone.  The spring does not
    make the xy trustworthy -- it makes d yaw small enough that the xy can be
    read at all.

    WHICH IS WHY THE TROT'S YAW IS THE FIRST NUMBER TO READ BEFORE THE xy.
    The filter's x and y are leg odometry: world foot positions differentiated
    through R.  Turn the trunk by psi and the whole stance turns with it, so a
    trot that ends 7 deg off its heading has moved every foot some 20 mm
    sideways at a 160 mm stance radius WITHOUT THE ROBOT GOING ANYWHERE.  An
    xy read across a trot is a claim about the filter only to the extent that
    d yaw is small; when it is not, the yaw line above says so and the xy is
    that rotation before it is drift, bias or a frame error.

WHICH WORLD, AND WHY THE FILTER IS RESET ONCE
    The tap puts every measurement in the run's own world frame first
    (`state.rezero_yaw` at `stand.yaw_offset`), so the filter's v and xy are in
    the frame the law controls in: world x is where the trunk pointed at the
    handover, not where the magnetometer calls north.

    BOTH SOURCES, NOT ONE.  `rezero_yaw` turns `body.R`, and the legs read
    off `body`; the IMU source is built from the sweep's `TrunkOrientation`,
    whose R still carries the magnetometer's heading, so it is handed
    `body.R` in place of its own (`_update`).  FOUND ON THE ROBOT 2026-09-24:
    with the raw R the filter integrated in the magnetometer's world while
    `reset` had laid the feet out in the run's, and at that day's 170 deg
    heading the trunk walking forward printed as -x and left as -y, with the
    status line's yaw reading 0.3 deg the whole time because that yaw is the
    law's, already zeroed.  `tests/test_dog6_sources.py` pins a forward walk
    at that heading to +x.

    That frame is fixed ONCE, at the end of the crouch, and the instant it
    turns is the one instant the filter's own state -- p, v and four world foot
    positions -- would be left behind in the old frame.  So the tap resets the
    filter on the sweep the offset changes, which is the handover: feet
    planted, the crouch arrived, torque just live.  `reset` starts it at the
    legs' own geometry, which is the only thing it can honestly start from.
    Before the handover the offset is 0.0 and the world is the magnetometer's;
    that is the frame the limp, settle and crouch readings are in.
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
