snowyfoams/dog6/(commit log)

2026-09-15 Initial commit: DOG6 sim + hardware stack, measured hardware map
    Fill hw/hardware_map.py from the assembled robot (2026-09-15):
    CAN ids FL=1-3, FR=4-6, RR=7-9, RL=10-12; direction -1 on ids
    3, 6, 7, 9, 10, 12. No row is confirmed yet.
    hw.selftest still asserts an empty map, so 9 of its checks now fail.
    [MG5010-i10_plane.stl, MG5010-i10_plane_MIR.stl, MG5010-i10_plane_MIR_MIR.stl, link01_v2_support.stl, link01_v2_support_MIR.stl, link01_v2_support_MIR_MIR.stl, quadruped_body_cover.stl, quadruped_body_v2.stl]
2026-09-15 Fix the flat zero: the leg plane was folded 180 deg the wrong way
    At hip_abd = 0 the model hung the thigh UNDER its pitch motor. The built
    robot has it ON TOP, its twelve drivers are calibrated to that zero, and
    hw.kinematics is written in that frame -- so every joint angle this repo
    produced was 180 deg off about the abduction axis at exactly the point where
    it crosses to hardware.
    The 180 deg was never measured, and coordinates.py said so: "Which way the
    leg plane folds down is otherwise a free 180 deg choice", resolved by
    DEFINING the standing pose to carry DOG5's Q_ROLL sign. That pinned the
    choice to DOG5's convention rather than to DOG6's bench, and DOG6 folds the
    other way. Where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
2026-09-15 sim.stand: position mode -> Cartesian compliance -> park, no IMU
    A four-phase sequence stepped by ENTER: hold, position-mode down to the
    crouch, TORQUE-mode Cartesian compliance that pins the feet in xy and drives
    z to lift the trunk, then position mode back to the crouch. The point is
    the handover in the middle -- a joint servo that does not know the robot has
    a body meets a force law at the feet that does not know what the joints are
    doing, and they have to agree on one pose.
    NO IMU. Trunk height comes from the twelve joint encoders alone,
    h = FOOT_RADIUS - mean(foot_position(leg, q).z). That assumes a level trunk
    and four planted feet, which this sequence never violates, and it is exa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
2026-09-15 sim.stand: bring the sequence under hw.safety.TAU_STAGED_MAX
    The sequence peaked at 3.583 N*m, over the 3.0 N*m cap a real bring-up runs
    under, so it could not have gone to hardware as written. Every steady-state
    hold in it is below 0.75 N*m -- the peak was entirely the transient at the
    start of the stand-to-belly move, which swings the knee 88 deg.
    Two changes, both to the reference and neither to the gains:
    * the position and lift ramps now use half a cosine instead of a straight
    line, so the commanded velocity starts and ends at zero. A linear ramp
    asks for its full speed in one tick and KD_JOINT answers that with the
    largest torque in the phase.
    * RAMP_POSITION 1.5 ->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
2026-09-15 hw.stand: run sim.stand's sequence on the robot; confirm the hardware map
    - hw/stand.py: limp -> settle -> crouch -> lift -> park -> done on the real
    drivers, single paced round-robin loop kept inside the drivers' 50 ms
    input-lost window, lift through hw.safety.SafetyGate.
    - hw/hardware_map.py, hw/__init__.py: all twelve rows confirmed on the robot
    (CAN 3, 6, 7, 9, 10, 12 are -1); CONFIRMED_ON_DOG6 = True.
    - hw/safety.py: INPUT_LOST_S = 0.050; bringup/README corrected from 10 ms.
    - sim/stand.py: no top-level mujoco import, public smoothstep, shared
    compliance_torque(); LIFT_HEIGHT 0.15 m, KP_CART/KD_CART retuned.
    [bringup.py, hardware_map.py, safety.py, stand.py]
2026-09-16 hw.balance: the stand's SRB balance controller, replacing the per-leg law
    The lift phase had no sensor that read trunk attitude and no variable that
    named it, so roll and pitch were whatever four independent Cartesian springs
    happened to produce. Load sharing was a fixed mg/4 regardless of where the
    feet were, and the six-dimensional internal-force null space was picked by
    accident. This names all of it.
    Five stages, once per sweep at slot 0, world frame between the two crossings:
    state R, omega^b from the IMU; q, qd from the encoders
    ... omega^w = R omega^b, r_i^w = R (x_i^b - c^b), h
    controller PD on (p_c,z, R) -> desired accelerations -> b_d
    allocation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
    [imu.py, safety.py]
2026-09-16 hw.balance: fold stance, IMU setpoint latch, and trot in place
    The stand:
    - hw.balance.sequence: the phase machine moves out of hw.stand (stand is the
    I/O runner only); rise and hold split on the S-curve's clock, HoldWatch
    reports what a push did
    - DOG5's SETPOINT_DYNAMIC ported: roll/pitch latched at zero torque in limp,
    yaw at arm, built into R_des rather than subtracted
    - hw.balance.posture + hw.fold_stand: the hand-folded crouch, regularised,
    with its own pinned SRB model; roll gains 290/23 for the narrow I_xx
    - hw.record: read the twelve joints with no torque
    The trot (hw.fold_trot):
    - gait.py: DOG5 trot_demo's clock (1.2 s, duty 0.80, ramp 0.15, settle
    every 2 cycles, altern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
2026-09-17 hw.balance: fold rear-as-front, joint-space z-only swing, wide trot and foot step
    - posture.FOLD: rear legs fold like the front (knee motor toward the CoM),
    mirrored fore-aft from the regularised capture; c^b x now 0.0 mm.
    - swing: the fold gets its own joint-space swing -- the z-only arc through
    the IK, abd held, joint PD (Kp 30 / Kd 0.8) -- instead of the shared
    Cartesian impedance (~4 N*m/rad about abd in the fold stance). The arc is
    latched to the measured foot at liftoff: unlatched, 8 mm of offset
    demanded 94 N*m in MuJoCo with the runner's sensing; latched, 1.0 N*m.
    - hw.fold_trot: its own 2.0 s period (400 ms swing); under ~300 ms the joint
    swing cannot follow the 60 N*m/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
2026-09-21 hw: joint-space hold layer, half-gait, sway, and the accel velocity estimator
    - hw.balance: DOG5 trot_hw's JointImpedance -- tau += Kp (q_hold - q) - Kd qd
    under every leg, q_hold latched on the sweep the robot reaches HOLD and kept
    through the hold and every trot (swing legs get the damper only); W releases
    and re-latches. KP/KD_JOINT_HOLD 3.0 / 0.1 [DOG5 FLOWN]; --joint-hold (the
    default) / --no-joint-hold, --kp-joint / --kd-joint.
    - gait: the alternating lead diagonal removed on request, one fixed trot.
    - --half-gait: each T is one diagonal's swing, then HOLD by itself; the next
    T swings the other diagonal.
    - law.offset_attitude: a moving attitude target; tilt stop and error re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
    [fold_trot.py, selftest.py, stand.py, sway.py]
2026-09-24 hw.state_estimator: MIT's linear KF for trunk position and velocity
    A port of LinearKFPositionVelocityEstimator from MIT's Cheetah-Software.
    The accelerometer drives the prediction; every leg then reports where the
    trunk is relative to its foot and, if the foot is planted, how fast the
    trunk moves over it. Each leg's contact phase decides how far it is
    believed.
    x (18,) p_w | v_w | four feet WORLD
    y (28,) p - foot_i (12) | v (12) | foot_i,z (4)
    Two layers, and the boundary is the point:
    estimator/ numpy and the standard library only. Pure functions for
    C, A/B, Q, R, the trust ramp and the measurement; the
    class holds x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
2026-09-24 hw: yaw spring on via heading rezero, swing slew bill, estimator tap
    - hw.balance: latch the heading at the crouch -> rise handover
    (`law.arm`), `state.rezero_yaw` turns the world frame to it, and the
    yaw spring is on now that the loop closes on a difference, not the
    magnetometer's absolute heading. `FOOT_RADIUS_XY` bounds `KP_YAW`.
    - hw.balance.swing: `joint_swing_demand` prices a swing in peak qd, peak
    tau and the slew the gate must allow; 80 ms swings measured on the
    robot 2026-09-24 did not lift the foot. selftest and sequence check it.
    - hw.imu: IMU listener, acc age, specific-force scale (9.7807 over
    Singapore), measured gyro agreement.
    - hw.stand: `terse` stream, tap slo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
2026-09-25 hw: parallel fold, swing feedforward, --no-limits, swing bench
    - hw.balance.posture: FOLD's rear legs carried PARALLEL to the front
    (2026-09-25), every knee behind its hip; rear feet at -154 mm, c^b x
    -10.7 mm, the CoM 14.8 mm behind both diagonals. selftest gates the
    parallel legs and checks the two-foot residual is W d.
    - hw.balance.swing: `swing_feedforward`, M0 J^+ (a_ref - Jdot qd_ref) per
    swing leg, open loop, both modes, off unless `--swing-ff`; M0 from
    `leg_dynamics.mass_matrix` at the lift pose, `--ff-armature` to replace
    the inherited armature. `swing_reference_pva`. The bench overshot with
    it on (15 mm asked, 26 reached); feedforward off with `--kd-swing 20 20
    4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
    [fold_stand.py, fold_trot.py, selftest.py, stand.py]
2026-09-28 hw: fold trot on hw.trot's Cartesian swing, arc latched at liftoff, fold feet forward
    hw.fold_trot: the joint swing on its 2.0 s clock failed on the robot on
    2026-09-28 (the swing leg rushed; the run ended on a CAN missed-reply
    e-stop the swing leg caused). It now flies hw.trot's trot -- trot_options,
    the Cartesian swing, --swing-ff / --ff-armature at hw.stand's defaults --
    from hw.fold_stand's stand, on its own tested clock and apex (0.5 s, 20 mm),
    and prints hw.trot_esti's Kalman filter where the accel velocity was.
    `--swing joint --period 2.0 --swing-height 40` is the old fold trot.
    balance.law / swing / swing_bench: the Cartesian arc starts on the foot
    latched at liftoff and, in place,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
    [fold_stand.py, fold_trot.py, selftest.py, stand.py]
2026-10-01 hw.wide_trot: trot from posture.WIDE at 160 mm, stance xy spring on
    hw.fold_trot's run (cap 9, slew 60, roll 290/23, limits off, Cartesian
    swing, joint hold, trot_esti's filter, 0.5 s / 20 mm) from posture.WIDE
    -- X knees, feet +-81 mm, |y| 85, crouch 40 -- flown at 160 mm with the
    SRB re-pinned at that height and --kp-stance-xy 400 --kd-stance-xy 25 on
    by default. --track 95 / 105 builds the same posture with the feet
    further out. The posture the doc/trot_posture simulation study found
    best for the trot in place: every perturbation survived at 0.5 s and
    0.8 s, a quarter of the fold's hold torque, no forward glide on the rise.
2026-10-01 doc/trot_posture: the stand posture for the trot, and the rise from the crouch
    MuJoCo study against 1f9304f, the repo's sequence/law/gait/gate run
    unmodified through doc/crouch_trot/hwsim.py (committed here with the two
    modules evalpose imports from it).
    - The forward shift on the rise from the parallel fold: trunk x has zero
    stiffness in the law, and all-knees-back legs follow a forward path of
    least dissipation as h rises (~100 mm; mirrored legs 0). The existing
    --kp-stance-xy pins it; the handover sag is separate.
    - The committed fold crouch rests the knee motors 21 mm into the floor
    (mesh hull check, evalpose.collisions).
    - 28 stances x 2 clocks x 13 perturbations: every stance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
    [evalpose.py]
2026-10-02 hw.balance: no joint-hold layer on a swinging leg
    The hold layer's spring target already followed a swinging leg, but its
    damper stayed: -0.2 qd against an arc that runs the knee at 7-13 rad/s,
    83 N s/m at the foot in z -- twice the swing PD's own Kd_z, all of it
    opposing the lift. It halved a 20 mm apex in the one-leg model
    (doc/dog6_swing_leg.tex). cMPC damps stance legs only, for the same
    reason; the swing bench never had it. A swinging leg now gets none of
    the layer, so the trot flies the swing the bench tunes. Planted legs
    are unchanged.
    selftest: a check that stance legs get -Kd qd and swing legs nothing.
2026-10-02 doc/swing_leg: the swing-leg control law and its slew budget
    A method note on the swing leg (LaTeX source; build with pdflatex): the
    law as feedforward plus Cartesian impedance, which hardware flag sets
    which term, and what the robot's actuation chain adds that the cMPC
    simulator does not. One leg, trunk pinned, the repo's own arc, law and
    RNEA, plus the gate's slew, a one-sweep delay and the 40 Hz velocity
    filter (swing_study.py regenerates every table and both figures).
    - The 60 N*m/s slew is the sim-to-hardware gap: without it the robot's
    chain tracks within 1-2 mm; with it the apex is late (s 0.66-0.82)
    and the foot is 10-20 mm up at the clock's touchdown.
    - The arc's peak torque r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
2026-10-02 hw: fold stand on a slanted rise, fold2, estimator x/y in every trot
    The uncommitted work of 2026-09-28..10-02 on top of 90204ee, one tree
    shared across sessions. Per item: what flew, what MuJoCo passed, and
    what has not been on the robot.
    - One trot, shared (2026-10-02, on request): every trot entry point
    defaults to the operator's best fold trot -- 0.6 s, 20 mm apex, gate
    slew 120 N*m/s, swing Kp 10/10/400 N/m, Kd 5/5/40 N s/m
    (config.KP_SWING, TAU_SLEW_TROT_NM_S, SWING_HEIGHT; hw.trot PERIOD_S
    0.8 -> 0.6, hw.wide_trot 0.5 -> 0.6). Flown as the fold trot.
    - The Cartesian arc's liftoff latch from 1f9304f is reverted: the arc
    starts at the resting foot again, after the operator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
    [fold2_trot.py, fold_trot.py, fully_trot.py, selftest.py]
2026-10-04 hw.fold_walk: WASD/QE walking on one reference, the joint layer kept, the QP
    The walk the operator asked for, five files in hw.balance and an entry point:
    trajectory.py sim.cmpc.trajectory's generator, imported: the body
    command slewed, clipped to the hardware box, integrated
    by the reference yaw, leashed to the filter (30 mm, 10 deg)
    keys.py W/S x, A/D y, Q/E yaw, SPACE stop -- sim.cmpc.run's map
    qp.py stage 4 as a QP: the pyramid and the contact box inside
    the problem; dense primal active set from the projected
    unconstrained optimum (agrees with SLSQP to 1e-4 N,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
    [fold_walk.py]
2026-10-04 QP as every entry point's default allocator; hw.fold2_walk
    The QP (hw.balance.qp) is now the default allocator of law.BalanceLaw and of
    hw.stand for every entry point and every phase the SRB law drives -- the
    stands, the rise, the hold, the trot, the walk -- on request, for the robot:
    the friction pyramid and the contact box are constraints of the problem,
    where the least squares meets the wrench first and clips into the cone
    after. --alloc wls keeps the least squares; the banner says which.
    In MuJoCo the trot entry points in place are the same allocation either way
    (hw.fold_trot and hw.fold2_trot, in place, with 0.1 N*m joint friction and
    15 ms of IMU, on mu 0.5: tilt within 0.05 deg); pu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
    [fold2_walk.py, fold_walk.py, selftest.py, stand.py]
2026-10-04 doc/walk: FOLD2 across the gait phase, the envelope figure with FOLD2
    hw.fold2_walk, six gait phases a case in MuJoCo: in place, 0.05-0.15 m/s
    forward, 0.10 back, 0.05 / 0.08 / 0.10 sideways, 20 and 40 deg/s turns and
    0.10 m/s with a 20 deg/s turn, none tipped, all under 8 deg of tilt (the
    fold tipped 3 of 6 at 0.15 m/s forward); 0.20 m/s forward is the edge, 4 of
    6 to the tilt stop at the 9 N*m clip. Joint friction with the IMU 15 ms
    late, a mu 0.5 floor, and the 0.6 rotor with DOG5's M0 or a fitted one:
    none tipped. The keys' box stays the fold's for the first flights; the
    README and hw.fold2_walk say what MuJoCo allows past it.
    Cl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
2026-10-05 hw: fall hold for the tilt e-stop, per-leg swing gains, the walk at rest, can0 and the loop's timing
    2026-10-05, everything on request, none of it flown.
    THE TILT E-STOP IS DELETED ("estop is not good, i want to delete it ... when
    tilt 46, then just hold the leg posture and don't stop"). No TILT_STOP_DEG,
    no --tilt-stop, no tilt trip in the law. Every trot and walk entry point
    instead FALL-HOLDS past 45 deg from the setpoint (config.FALL_HOLD_DEG,
    --fall-hold, 0 = off): no wrench, no swing, no trot, every joint PD'd to the
    first HOLD's pose (Kp 5 / Kd 0.2 + leg gravity), sequence phase "fall", the
    run goes on, ENTER parks, X drops it limp. The stands have nothing on tilt.
    MuJoCo, fold_tr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
2026-10-05 sim.cmpc: the stance joint floor is damping only, with no position term
    The stance legs' joint-space floor was `joint_pd(q, qd, q)`: a PD whose
    reference was the current angle, so the Kp term was identically zero while
    KP_JOINT, the latched `_q_hold` pose and the position arithmetic all stayed
    in the code. Make the law what it already was in effect:
    tau = -KD_JOINT qd
    `swing.joint_pd` becomes `swing.joint_damping(qd)`, KP_JOINT is gone, and
    the controller no longer latches a joint reference. A joint-angle spring
    under a stance leg needs a reference the MPC never supplies, and a spring
    to a pose latched at some earlier instant fights the MPC's force every time
    the body moves; damping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
2026-10-05 hw.balance: a singular leg no longer raises out of the walk's law
    Found in MuJoCo, 2026-10-05, running hw.fold_walk in place for 30 s on a
    robot-like plant (rotor 0.6x, 0.1 N*m joint friction, IMU 15 ms, mu 0.7,
    CoM 3/5 mm off, kt 0.9): a fall straightened a planted leg, its Jacobian
    went singular, and np.linalg.solve raised LinAlgError out of
    walk.hold_targets. On the robot hw.stand.run ends on any exception and
    the bus closes -- the robot drops limp -- so the exception, not the fall,
    would have ended the run.
    swing.solve_jacobian: np.linalg.solve, and the least-squares answer on a
    singular matrix. Used by walk.hold_targets (the planted legs' target
    rate), swing_control (the osc law's J^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
    [selftest.py]
2026-10-05 hw: --com-offset, hw.com_check, the 30 s robot-like study, hwsim's pin
    2026-10-05, after the operator's report: the trot fails after a while on
    the robot, the walk's trot in place is worse than hw.fold_trot's, other
    Kp/Kd did not cure it. doc/walk/longrun.py runs both for 30 s in place
    and across the keys' box on a ROBOT-LIKE plant (rotor 0.6x, 0.1 N*m joint
    friction + IMU 15 ms, floor mu 0.7, the CoM 3 / 5 mm off the CAD's, 10 %
    less torque per amp), then one unknown at a time. The CoM is the one that
    matters: alone it takes hw.fold_trot in place from 2.3 deg of tilt to 9.7
    with the tilt rms growing 2.3 -> 4.8 -> 4.9 deg over three 10 s windows
    (the stance narrowing 124 -> 110 mm as each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
    [com_check.py, stand.py]
2026-10-05 hw.stand --com-offset re-centres the stance, not just the pin
    MuJoCo, the robot-like plant with its CoM 3 / 5 mm off the CAD's: shifting
    the SRB pin alone left hw.fold_trot in place at 7.9 deg (9.7 unshifted,
    the tilt rms still growing 1.8 -> 2.7 -> 4.2 over three 10 s windows) and
    hw.fold_walk's osc at 7.2 deg drifting 0.6 m -- a model does not fix
    geometry: the trunk rocks about whichever trot diagonal the real CoM is
    further from. Moving the stand's sites WITH the offset, so the diagonals
    pass through the real CoM, brings both back to the ideal plant's: the
    trot 1.9 deg (rms 0.5 / 0.7 / 0.8, flat), the walk's impedance on the
    trot's clock 1.5, the osc 3.8, and 0.06 m/s forward stands on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
    [stand.py]
2026-10-05 doc/walk: section 11, the 30 s robot-like study and the CoM
    The tables behind the 2026-10-05 commits: eight swing/clock configurations
    for 30 s in place on the ideal and the robot-like plant, one hardware
    unknown at a time, the pin alone against the stance re-centred, the keys'
    box with the CoM uncorrected (nothing walks it; every duty-0.70
    configuration is down within two seconds) and corrected (everything
    stands), and the standard set and FOLD2's re-run on the harness that now
    measures on the law's own pin. 11.6 is the order to do things in on the
    robot: measure the CoM (hw.com_check), fly --com-offset, meanwhile the
    walk's impedance on the trot's clock, then fit the armature. hw/README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
2026-10-06 sim.wave + hw.stand --wave: a three-leg stance, the raised paw waving
    Five torque phases spliced into the stand after the lift: shift the trunk
    over the feet, unload and raise one paw, wave it, put it back and reload it,
    shift back. One law for all four legs -- sim.stand's Cartesian compliance --
    with only the targets, their analytic rates and the per-foot vertical
    feedforward changing. The feedforward is SOLVED: the three statics equations
    about the CoM, closed by weighted minimum norm with a contact weight per foot
    that fades the paw's share out before it leaves the floor and back in after
    it lands. No instant at which a leg switches controllers, so no step in any
    torque. sim.wave.chec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
    [selftest.py, stand.py]
2026-10-20 hw: impedance walk swing and no settle by default; WASD x/y doubled
    2026-10-20, on request, from the operator's test on the robot that day:
    - config.SETTLE_S 0.2 -> 0: DOG6 needs no four-foot re-level; every trot
    defaults to none (the walk's was already 0). --settle 0.2 restores it.
    - config.WALK_SWING_LAW osc -> impedance for fold_walk / fold2_walk
    (--kp/--kd-swing-walk); --swing-law osc restores the task-space swing.
    - WASD x/y doubled: 0.06 m/s a press, box 0.12 / 0.06 m/s (yaw unchanged).
    Also commits the uncommitted work of 2026-10-06/07 in the tree:
    - walk stance damper-only (WALK_KP_JOINT 0, rise keeps --kp-rise)
    - --com-auto: every HOLD measures the CoM (balance/com_estimate.py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
2026-10-20 hw.balance: touchdown detection, scheme A; on by default in hw.fold2_trot/walk
    Which foot is DOWN, without a sensor: hw/balance/contact.py decides it
    from the swing law's own commanded push on the floor -- the drivers'
    current cannot see the floor (the current loop follows the command), the
    encoders can -- gated by the foot's clearance above the planted feet's
    plane and by the reference's own. A foot that has landed is handed to the
    allocator, the joint layer and the walk's anchors on the sweep it is felt;
    a foot the clock has landed that nothing has felt stays OUT of the
    allocator and PROBES down, pushed along gravity, until the floor answers
    (the 2026-10-06 fall was that foot, loaded in th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
2026-10-21 Revert "hw.balance: touchdown detection, scheme A; on by default in hw.fold2_trot/walk"
    This reverts commit 6f51e56. On the robot the trot did not run with the
    detector on (the operator's test, 2026-10-21): the tree goes back to
    9102aa6, the trot and the walk as flown on 2026-10-07 and 2026-10-20, with
    no detector, no --touchdown flag and no td_* log columns. The design and
    the MuJoCo study stay in the history at 6f51e56 for the diagnosis to start
    from; the next attempt should start from a robot log of the failed trot.
    Claude-Session: https://claude.ai/code/session_01U6UPMGxpKM3rkfksYCCm6o
2026-10-21 doc/gait_study: experimental design for the WASD tip-over and the gait parameters
    A protocol, no code and no runs: turns the two proposed explanations of
    the walk's tip-over -- an accumulating error (H1) and the time-driven
    clock loading feet that have not landed (H2) -- into measurable claims,
    adds the lateral geometry (H3: an A/D command crosses the support diagonal
    3.4x faster than W/S and STEP_KV is a quarter of the capture-point gain),
    and lays out E0-E5: the metrics from the existing hw.stand log (touchdown
    lag, phantom impulse, roll step per landing, scuffed swings, stance
    width, per-cycle attitude bias, the hazard), the factors (duty, period,
    contact ramp, apex, slew, swing Kd, settl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
2026-10-21 doc/gait_study: B0 pinned to the 2026-10-21 line, its silent defaults, Session 1
    The baseline is the line the operator flew today -- --duty 0.8
    --contact-ramp 0.15 --tau-slew 300 --period 0.6 -- written out with every
    default it carries: no settle, the damping-only stance (joint Kp 0), and
    so NO --com-auto (hw.stand's com_able needs a joint spring), and the
    governor ON at 5 deg of lean. "Fairly stable" was observed with the
    governor pressing SPACE, so the hypothesis runs fly --pause-lean 0 and
    the governor is a cell of its own; the joint spring with the CoM measured
    is another. The E2 levels sit around that B0 (slew 120 vs 300, ramp
    0.075 / 0.15 / 0.1875, duty 0.70 / 0.75 / 0.80). The lat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
2026-10-21 doc/gait_study: B0 carries the joint spring (Kp 4/5, so --com-auto on); the tracked set
    The operator's full line is --duty 0.8 --contact-ramp 0.15 --tau-slew 300
    --kp-joint 4 --kp-joint-abd 5: the HOLD is sprung, so hw.stand's com_able
    is true and the CoM is read in every HOLD and applied at T. B1 (the
    tree's defaults) is the cell without the spring. Section 2.0 is the
    tracked set in priority: twelve quantities in three tiers -- attitude,
    outcome, real swing height, swing tracking error; touchdown lag, phantom
    impulse, roll step, liftoff lag; stance geometry, attitude bias, the
    estimator, torque -- each with its unit, its period and the hypothesis it
    tests, and the three definitions fixed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
2026-10-21 doc/gait_study: phase 1, the minimal programme on today's line; no touchdown time
    On the operator's reading of the plan (2026-10-21): a fall is the fall
    hold at 45 deg, the true touchdown time cannot be estimated on this robot,
    and the gait has too many knobs to decouple at once. Section 0 is phase
    1: nothing varied, thirteen runs of today's line (in place x2, the
    lateral shuttle x5, the forward shuttle x3, the lateral shuttle with 10 s
    pauses x3, the governor on as flown), and the argument in four claims
    with the evidence each needs from the log -- A, no authority about the
    support diagonal (the allocator's residual projected on the diagonal, the
    roll excursion per two-foot phase against t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
2026-10-21 hw.script: the operator's keys from a file, on the phase clock (--script)
    A scripted run is the same run every time: T, the walk's keys, SPACE and
    ENTER go out at scheduled seconds after each phase is entered, where
    hw.stand.run would read the keyboard, one key a sweep. The keyboard
    still works and any key pressed by hand cancels the rest of the script
    (X is X). The file: `<phase>[n] +<s> <keys>`, phases as
    StandSequence.phase_name reads them, [n] the n-th entry (hold[2] is the
    HOLD after the trot), and `shuttle K1 K2 leg= total= [pause=]` for the
    back-and-forth a lab floor needs -- without pause a reversal is the
    other key pressed twice on consecutive sweeps, so the reference crosses
    zero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
2026-10-21 hw/scripts: p1_lat_slow, the lateral shuttle at half speed and the same distance per leg
    Claude-Session: https://claude.ai/code/session_01AT5MRsCBPGa1ncQk4aRt76
2026-10-21 doc/gait_study/analyse.py: the tracked quantities from an hw.stand log, with figures
    Reads `hw.stand --log` npz files: rebuilds one clock (the log's t restarts
    in every phase), differentiates positions (the qd column is one row
    repeated), levels the trunk-frame feet by the IMU's roll and pitch, and
    measures each foot's height against the plane of the planted feet -- at
    the clock's touchdown (h_td), over the swing (the apex, the scuffs, the
    liftoff lag) and under the allocator's force while still above 4 mm
    (Phi); the roll step across each landing; each landing against its
    liftoff over the floor the planted feet show (the ratchet); per cycle the
    stance width, the feet against their HOLD sites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
2026-10-21 doc/gait_study/runs: p1_lat_1..3, the robot's lateral-shuttle logs of 2026-10-21
    hw.fold2_walk --script hw/scripts/p1_lat.txt, three runs on the robot, the
    hw.stand log as written (force-added past .gitignore's *.npz on request,
    for the analysis). Recorded spans: 20.3 s, 38.5 s, 11.2 s.
    Flown on the Pi's working tree, which carried two changes not on origin:
    A/D halved to 0.03 m/s a press (WALK_VY_STEP, --vy-step) and the stand-up
    ENTER no longer cancelling a script (KeyScript.lets_through). The log does
    not record the command line, so whether --vy-step 0.06 was given is the
    operator's to say.
2026-10-21 doc/gait_study/analyse.py: foot height at the clock's instants per cycle, and every cycle on the leg's own clock
    Figure 7: per leg, the height at the clock's liftoff, the apex and the
    height at the clock's touchdown (h_td) against the gait cycle since the
    trot started. Figure 8: per leg, every cycle's height overlaid on the
    leg's own clock, ms after its liftoff, coloured early to late, with the
    clock's liftoff and touchdown marked and each landing's h_td as a point.
    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
2026-10-21 doc/gait_study/analyse.py: figure 9, each foot's FK height by gait cycle, the clock's swing red and stance blue
    Time replaced by the gait count (t / period from the trot's start, from
    0), one panel a leg, the 4 mm gate kept; --cycles C0 C1 windows it.
    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
2026-10-21 doc/gait_study/analyse.py: figure 11, roll/pitch/yaw by gait cycle with the clock's swing windows shaded
    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
2026-10-21 doc/gait_study/analyse.py: figure 10 draws the clock's commanded arc beside the measured foot height
    p_swing levelled against the same planted plane and per-foot offset as
    the FK height, dashed in the leg's colour.
    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
2026-10-21 doc/gait_study/analyse.py: figures 12-20, every other column on the gait axis with the clock's swing shaded
    Forces, the wrench, the attitude error and gyro, joint torques commanded
    and measured, the feet against their sites, the estimator, the swing
    error, the residual and the clock, the knee's request against the gate.
    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
2026-10-21 doc/gait_study/analyse.py: figure 21, the load handover aligned on the clock's touchdown
    Per leg, the fz the allocator asks, the clock's contact weight and the
    foot's height, median and p10-p90 over every landing, from 60 ms before
    the clock's touchdown to 240 ms after: the ramp against the foot.
    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
2026-10-27 doc/swing_height: one-leg study of the swing with the inertial feedforward off and on
    One hung-up leg, the robot's swing code against MuJoCo through the hardware
    chain, 20 mm apex: what --swing-ff changes against the gait study's
    feedforward-off flight. study.py runs the ten cases and writes results.txt,
    the tables and the figures; build_leg.py generates model/leg_RR.xml;
    hwsim_leg.py is the bench emulation. dog6_swing_height.tex is the report.
    The saved runs (data/*.npz) are not committed, as for the other studies;
    study.py --figures rebuilds the tables and figures from them.
2026-10-27 hw.swing_ff: the swing feedforward's A/B on the robot, FOLD2's hold, the study's clock
    The hardware side of doc/swing_height (branch swing-analysis, the one-leg
    MuJoCo study on the weighed leg_RR.xml): the robot hung up, no IMU, the legs
    ramped to posture.FOLD2's hold at 160 mm, every stance leg on the joint layer
    the trots and walks fly (Kp 5 / Kd 0.2 + gravity), the clock time-driven at
    period 0.8 / duty 0.8 / ramp 0.15, and the legs in --legs on the 20 mm arc
    with the walk's Cartesian PD, --swing-ff off or on. F flips the feedforward
    between bouts; --ab N flies N swings per leg each way and exits. One line
    per swing with the study's metrics (apex and where on the arc, lag, rms,
    h_td, vz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
2026-10-27 doc/swing_height/runs: the hung-up swing logs of 2026-10-27, round 1
    Eight hw.swing_ff runs on the hung-up robot, one per group, all four legs,
    12 swings a leg: duty 0.8, contact ramp 0.15, 20 mm arc, the walk's swing
    gains (Kp 150/150/400 N/m, Kd 6/6/40 N*s/m), the joint layer on the legs
    in stance (Kp 5, Kd 0.2), cap 9 N*m, slew 300 N*m/s, FOLD2's hold at
    160 mm. Every run finished: 48 liftoffs, ended in hold. Copies of the
    root files, renamed _1 for round 1 ($R was empty when they were flown).
    *.npz is ignored by policy, so they are force-added.
    THE OPERATOR'S GUESS
    1. Period. A short period keeps the body stable, but the swing follows
    its arc badly, so the feet touch down early o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
2026-10-27 doc/swing_hw: the hung-up swing logs of 2026-10-27 against the operator's three guesses
    analyse.py reads doc/swing_height/runs (branch swing-analysis, the eight
    hw.swing_ff runs of round 1), computes the study's per-swing metrics plus
    the arrival after the clock's touchdown, the speed there and the dip below
    the site, fits the inertia the leg answered the sent torque with, and
    writes results.txt and eight figures. README.md is the report.
    What the data says: tracking improves with the period but the foot still
    arrives 32-48 ms after the clock at every period (the arc's slow end); at
    2.0 s the feedforward (armature 0.003) fixes the phase (lag 117 -> 82 ms,
    rms 6.2 -> 3.8 mm) but lowers the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
2026-10-27 doc/swing_hw: the gait-axis figures, as doc/swing_height's 7-10
    Four more figures from analyse.py: the whole bout by gait cycle with the
    four feet on one axis and the clock's swing shaded by diagonal (FF off by
    period; FF off and on at 2.0 and 0.8 s), RR by gait cycle red in swing,
    every cycle of RR overlaid on the leg's own clock, and h_td / apex / liftoff
    height per swing in the order flown. The report gains section 2b: the
    cycles repeat, the diagonals agree, and the feedforward's dip below the
    site (B8), bounce (B7) and shoulder (B6) are on every cycle.
    Claude-Session: https://claude.ai/code/session_013XM3zy6ZD5EyxNqaeoRDDq
2026-10-29 hw.swing_ff: --sched, the swing PD scheduled on the foot's apparent mass
    The swing's Cartesian PD has fixed gains (150/150/400 N/m, 6/6/40 N*s/m) on a
    foot whose apparent mass Lambda = (J M0^-1 J^T)^-1 is 0.31/0.36/5.8 kg at the
    FOLD2 hold and 3.3 kg in z 20 mm up. swing.GainSchedule re-reads Lambda from
    every sweep's Jacobian and sends Kp = wn^2 Lambda, Kd = 2 zeta wn Lambda:
    one natural frequency and one damping ratio per axis whatever the pose.
    - balance/swing.py: foot_mass_diag, GainSchedule (from_reference: wn from
    --kp-swing at the hold, or given). Lambda is clamped to LO..HI x its hold
    value (Kp floor, singular-pose cap) and comes from the datasheet M0, not
    --ff-armature.
    - s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
2026-11-10 hw.fold2_cmpc: the convex MPC as the trot's force law, on fold2_walk
    hw.fold2_walk with sim.cmpc's QP in place of the SRB wrench and its
    allocator on the sweeps the gait clock runs, and on no other.
    cmpc's: the foot forces (hw/balance/mpc.py, MpcForces: sim.cmpc's
    condensed QP, its Q and R, horizon 10, 40 Hz, with the robot's 5.210 kg,
    the held stance's inertia and the law's cone and fz box) and the clock,
    0.5 s at duty 0.5, no contact ramp, no settle.
    fold2_walk's, the same objects: the crouch, the tracked rise, HOLD, the
    park (SRB law, QP allocator), the swing control (the impedance,
    150/150/400, 6/6/40), the walking reference, footholds and arc, the
    planted legs' joint layer, the gate,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
